Omar-Magdy0/ForgeDriveHW/Doc/ForgeX/G0/PSU_G0P20N_tref.pdf

# ForgeX

# PSU_G0P20N Technical Reference

Project: ForgeX
Generation: Gen0
Document: PSU_G0P20N Technical Reference Author: Omar Magdy
Revision: Rev. 0
Status: Development
Date: August 2026

FOrgeDrive

PSU_G0P20N Technical Reference | 1

# Table of Contents

Table of Contents

# 1. Introduction

The PSU (Power Supply Module) provides the localized low-voltage auxiliary power required by the ForgeX platform. It converts the system high-voltage DC link, nominally in the 340–400 VDC range, into regulated low-voltage supplies for downstream electronics and auxiliary circuitry.

The PSU provides the electrical boundary between the VDCH power domain and the low-voltage electronics domain. In addition to power conversion, the module incorporates the local functions required for controlled startup, protection, output regulation, and DC-link voltage monitoring.

The Gen0 implementation, PSU_G0P20N , establishes the initial electrical, mechanical, and interface definition for the ForgeX PSU family. Subsequent PSU generations may revise the power-conversion topology, switching devices, magnetics, control and regulation architecture, protection mechanisms, or thermal implementation while maintaining the defined ForgeX module interfaces where generational compatibility is required.

The Gen0 design is intentionally optimized for a relatively low-power auxiliary supply, with emphasis on simple magnetics, component availability, ease of debugging, and predictable behavior under the intended ForgeX operating conditions.

## 1.1 Naming

PSU_G0P20N follows the ForgeX module naming convention:

- PSU — Power Supply Module
- G0 — Generation 0
- P20 — 20 W nominal power class
- N — Non-isolated auxiliary/tie interface variant

The N suffix denotes that the module exposes the internal auxiliary supply and the power-side reference through a dedicated tie interface. This allows the module to be used in configurations where:

- the internal auxiliary supply is used on the PGND side;
- the PSU output-side ground is intentionally referenced to PGND ;
- the low-voltage outputs are used in a non-galvanically-isolated system configuration

The P20 designation identifies the intended power class of the module and should not be interpreted as an unconditional continuous-power rating. The achievable output power and current depend on operating conditions including:

- VDCH input voltage
- ambient and component temperature
- transformer and semiconductor losses
- PCB thermal characteristics
- enclosure and cooling conditions
- output-voltage loading

## 1.2 Functional Overview

The PSU accepts the ForgeX VDCH bus as its primary input and generates regulated low-voltage auxiliary supplies for downstream electronics.

The principal functions of the PSU are:

- Generate the primary 12 V auxiliary supply.
- Generate the 5 V auxiliary supply.
- Provide the required startup and power-conversion functions.
- Provide local protection against abnormal operating conditions.
- Provide output-side monitoring and regulation.
- Provide conditioned measurement of the VDCH bus voltage.
- Provide the required power and signal interfaces to downstream ForgeX modules.
- Maintain the required galvanic isolation between the VDCH /power domain and the low-voltage domain for configurations requiring an isolated output.
1. Introduction

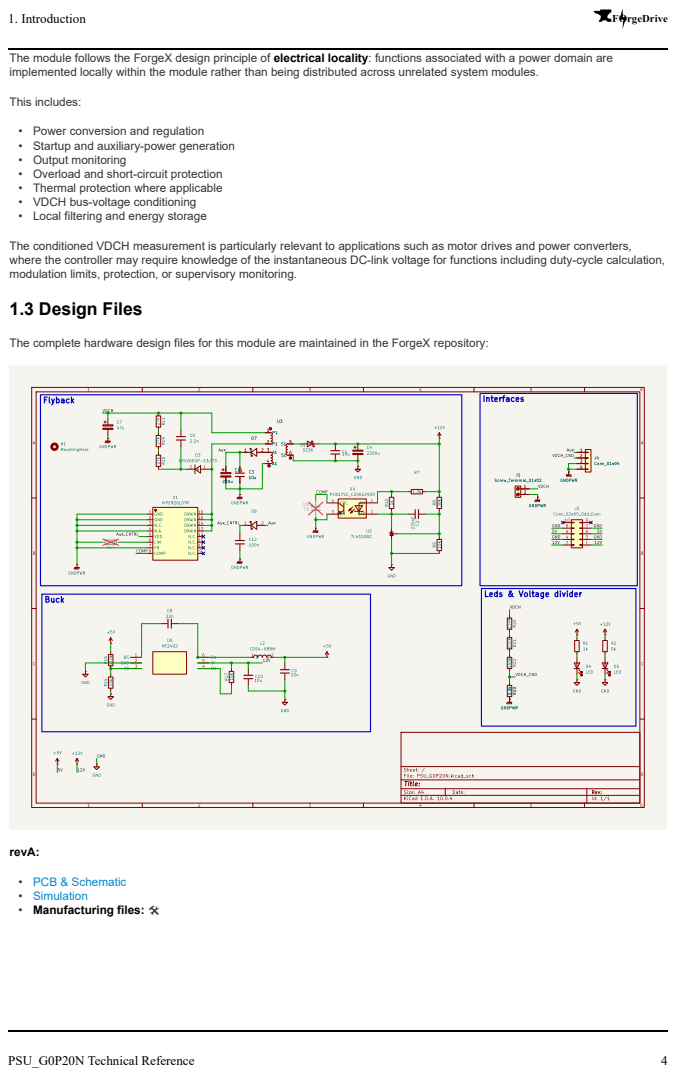
[picture p21: page 4]
This includes:; revA:; • PCB & Schematic • Simulation • Manufacturing files: 🛠; 1. Introduction

The module follows the ForgeX design principle of electrical locality: functions associated with a power domain are
implemented locally within the module rather than being distributed across unrelated system modules.

• Power conversion and regulation
• Startup and auxiliary-power generation
• Output monitoring
• Overload and short-circuit protection
• Thermal protection where applicable
• VDCH bus-voltage conditioning
• Local filtering and energy storage

The conditioned VDCH measurement is particularly relevant to applications such as motor drives and power converters,
where the controller may require knowledge of the instantaneous DC-link voltage for functions including duty-cycle calculation,
modulation limits, protection, or supervisory monitoring.
1.3 Design Files

The complete hardware design files for this module are maintained in the ForgeX repository:

# 2. Interfaces & I/O

1 | 2

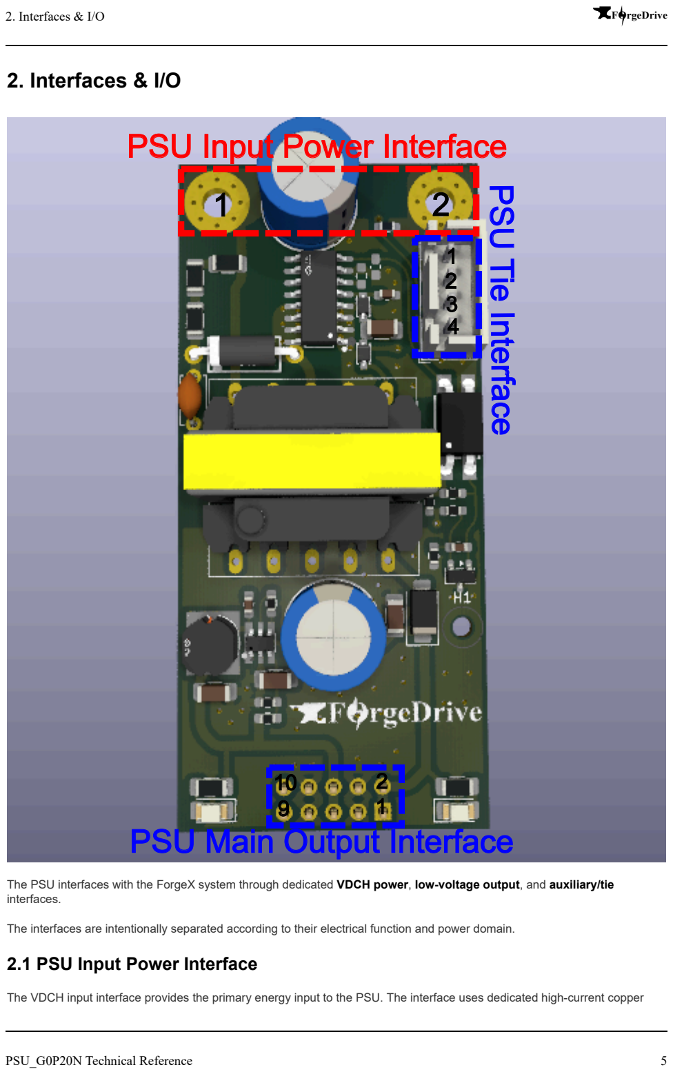
[picture p22: page 5]

1
9
10 | 2

1

4

2
3

# PSU Input Power Interface PSU Main Output InterfacePSU

# Tie Interface

The PSU interfaces with the ForgeX system through dedicated VDCH power, low-voltage output, and auxiliary/tie interfaces.

The interfaces are intentionally separated according to their electrical function and power domain.

## 2.1 PSU Input Power Interface

The VDCH input interface provides the primary energy input to the PSU. The interface uses dedicated high-current copper

2. Interfaces & I/O terminals suitable for connection to the ForgeX DC-link distribution structure.

The positive terminal is connected to the system VDCH positive rail, while PGND provides the corresponding DC-link return and power-domain reference.

Pin Number | Pin Name | Pin Description
1 | VDCH | Positive VDCH input. Connects to the positive DC-link rail.
2 | PGND | VDCH return and primary power-domain reference.

The input interface shall be treated as a hazardous-voltage interface when the PSU is connected to the ForgeX VDCH bus.

## 2.2 PSU Main Output Interface

The main output interface provides the regulated low-voltage supplies generated by the PSU.

The interface exposes both 12 V and 5 V rails together with their corresponding low-voltage ground reference, LGND .

The PSU Main Output interface uses a 2.54 mm-pitch header and is compatible with standard IDC and Dupont-style connectors. Multiple pins are paralleled for the power rails and return paths to reduce contact resistance and distribute current across multiple contacts.

A long-pin Dupont header may be used where access to the module's top-layer debug and test points is required.

Pin Number | Pin Name | Pin Description
1–2 | 12V | Regulated 12 V low-voltage output.
3–4 | LGND | Low-voltage output return/reference.
5–6 | 5V | Regulated 5 V low-voltage output.
7–8 | LGND | Low-voltage output return/reference.
9–10 | NC | No electrical connection.

LGND represents the low-voltage output reference and is electrically distinct from PGND in galvanically isolated configurations. In non-isolated configurations, LGND and PGND may be intentionally referenced together through the system-level grounding/ tie arrangement.

## 2.3 PSU Non-Isolated Tie Interface

The N variant provides a dedicated auxiliary/tie interface exposing selected internal nodes that are not available through the main output connector.

The Non-Isolated Tie interface uses JST-XH 2.5 mm-pitch connectors.

This interface permits the PSU to be integrated into systems where the low-voltage auxiliary supply or its reference must be associated with the primary power domain.

Pin Number | Pin Name | Pin Description
1 | Internal Aux 12V | Internal 12 V auxiliary output, limited to < 5W.
2 | VDCH_CND | Conditioned VDCH bus-voltage measurement output.
3 | PGND | Primary power-domain reference.
4 | PGND | Primary power-domain reference.

VDCH_CND is a conditioned analog representation of the VDCH DC-link voltage after the PSU's internal voltage-conditioning

2. Interfaces & I/O network. It is intended for connection to a suitable low-voltage ADC or monitoring circuit.

The PGND connection on this interface provides access to the primary power-domain reference and shall only be connected according to the intended system-level grounding architecture.

2. Interfaces & I/O

# 3. Design Requirements

The Gen0 PSU is designed around the following primary requirements:

- VDCH input: 340–400 VDC nominal operating range.
- Power class: 5–20W output operation.
- Nominal auxiliary rails: 12 V and 5 V.
- Efficiency: ≥ 85 under the intended nominal operating condition.
- Provide controlled startup from the VDCH bus.
- Provide appropriate overload and short-circuit protection.
- Provide regulated low-voltage outputs suitable for ForgeX downstream electronics.
- Provide conditioned VDCH-bus voltage measurement.
- Maintain the required electrical isolation or intentional non-isolated relationship according to the selected system configuration.
- Provide sufficient thermal margin for continuous operation within the intended power class.

The 20W designation represents the intended Gen0 design power class. Detailed continuous-load capability shall be evaluated against the thermal limits of the transformer, switching devices, rectification components, PCB copper, and other dissipative elements.

3. Design Requirements

# 4. Constraints

The Gen0 PSU design is subject to several practical constraints.

A significant constraint is the limited local supply chain, with component availability primarily governed by vendors accessible in Egypt. Component selection therefore considers availability and replacement options in addition to electrical performance.

PCB fabrication is constrained by the DFM rules applicable to the available fabrication process:

- Maximum number of layers: 2
- Minimum track width: 0.25 mm
- Minimum clearance: 0.25 mm
- Minimum polygon-pour clearance: 0.3 mm
- Minimum via diameter: 0.9 mm
- Minimum via hole diameter: 0.4 mm
- Minimum annular ring: 0.5 mm
- Maximum single-board size: 38 cm × 28 cm
- Maximum double-board size: 28 cm × 22 cm

The Gen0 implementation additionally prioritizes:

- Cost effectiveness
- Component availability
- Electrical and mechanical simplicity
- Reliability
- Predictable startup and protection behavior
- Ease of debugging and characterization
- Ease of modification during development
- Maintainability
- Simple and reproducible magnetics
- Compatibility with the broader ForgeX module architecture

Because the PSU interfaces directly with the VDCH bus, the Gen0 implementation also places particular emphasis on controlled voltage stress, switching-node behavior, insulation/isolation requirements where applicable, creepage and clearance, and safe probing during development and validation.

4. Constraints

# 5. Sizing and Component Selection

This section documents the principal component-selection and sizing decisions of the Gen0 PSU. Component values are selected from the electrical requirements established in the preceding sections, together with the operating characteristics of the selected switching topology and power devices.

Where analytical sizing is insufficient to capture parasitic effects or nonlinear device behavior, the initial component values are supplemented by simulation and experimental characterization.

## 5.1 Off-line Switcher

The VIPer26 off-line switcher from the STMicroelectronics VIPerPlus family was selected as the primary switching controller and integrated power device.

Datasheet: VIPer26LD (https://www.st.com/resource/en/datasheet/VIPER26.pdf)

Selection rationale:

- Local availability and cost: The device is readily available from local suppliers at relatively low unit cost, making it practical for prototyping, production, and replacement.
- Integrated high-voltage MOSFET: The integrated MOSFET provides an 800 V maximum drain-source voltage rating, providing substantial voltage margin relative to the intended VDCH operating range and associated switching transients.
- Application-appropriate conduction characteristics: The integrated MOSFET has an on-state resistance in the order of 7 Ω, which is suitable for the relatively low primary current associated with the 5–20W PSU power class.
- Low switching-node capacitance: The relatively low effective output capacitance of the integrated MOSFET reduces switching-node capacitive energy and associated switching losses.
- Integrated control and protection: The device integrates startup, PWM control, current limiting, burst-mode operation, and associated protection functions.
- Integrated current sensing: Primary current is sensed internally through the integrated SenseFET structure, eliminating the need for a conventional external primary-side current-sense resistor.
- Frequency jittering: The integrated switching-frequency jitter function reduces the concentration of switching energy at a single frequency and can reduce EMI peaks.
- Low standby consumption: Integrated low-power operating modes reduce consumption under light-load conditions.

The integrated switching, control, sensing, startup, and protection functions result in a compact implementation with substantially reduced external component count.

Although the application is not a conventional mains-powered offline supply, the input-voltage range and required operating conditions are within the intended application domain of the device. The VIPer26 therefore provides a suitable integrated switching solution for the ForgeX PSU.

The Gen0 implementation follows the isolated flyback application topology presented in the VIPer26 datasheet.

## 5.2 Flyback Transformer

The flyback transformer is the primary energy-storage, energy-transfer, and galvanic-isolation element of the PSU.

Unlike a conventional power transformer, the flyback transformer stores a substantial fraction of the transferred energy in its magnetizing inductance during the primary conduction interval and subsequently transfers this energy to the secondary during the demagnetization interval.

The design methodology follows the general procedure described in Designing a DCM flyback converter, (https://www.ti.com/lit/ta/ssztcw6/ssztcw6.pdf?ts=1787114658344&ref_url=https://www.google.com/)
with modifications to the order and priority of the design constraints to reflect the requirements of the ForgeX PSU.

The transformer design is constrained by:

- VDCH operating-voltage range
- Required output power
5. Sizing and Component Selection

- Selected switching frequency
- Maximum primary peak current
- Target operating mode
- Allowable flux density
- Required primary magnetizing inductance
- Selected turns ratio
- Allowable leakage inductance
- Winding current density
- Insulation and creepage requirements
- Thermal constraints

The transformer design establishes the primary magnetizing inductance, maximum stored energy per switching cycle, reflected secondary voltage, MOSFET voltage stress, secondary-device voltage stress, and the resulting flyback operating regime.

The initial electrical parameterization is performed before physical core
and winding selection. The resulting electrical requirements are then passed to the magnetic design stage, where the core, number of turns, air gap, winding geometry, leakage inductance, and thermal characteristics are determined.

The 150 V maximum reflected-voltage constraint is selected
from the available voltage margin of the VIPer26 integrated MOSFET.

At the maximum VDCH input voltage, the idealized MOSFET drain-source voltage is approximately:

Additional voltage stress is introduced by leakage-inductance-induced switching overshoot. For the initial design, a 100 V allowance
is reserved for this overshoot:

This provides an initial voltage margin below the 800 V MOSFET rating. The actual leakage-induced overshoot and resulting voltage margin are subsequently verified using the final transformer leakage inductance and RCD clamp design.

### Primary Inductance and Turns Ratio

The initial flyback electrical parameterization is performed by first
establishing the reflected-voltage constraint and turns ratio, followed by selection of the maximum operating duty cycle and corresponding primary peak current.

For DCM operation, the switching period consists of three distinct intervals:

VDS ≈ Vin,max + VR

## VDS,max ≈ 400 V + 150 V + 100 V = 650 V

fsw

VRmax

Ns

Np

VR

Ilim

## = 60 Khz (Switcher fixed switching frequency) = 150 V (Maximum tolerable secondary-to-primary reflected voltage)

= 8

## = (Vout + Vd) ×

Ns

## Np = 99.2 V

## = 0.7 A (Controller peak-current limit)

where:

The boundary between DCM and CCM occurs when the demagnetization interval exactly occupies the remainder of the switching period:

The maximum operating duty cycle is selected below this boundary to maintain DCM operation at the minimum VDCH input voltage:

Therefore:

With the maximum duty cycle selected as a design constraint, the required primary peak current is determined from the desired output power:

The required primary magnetizing inductance is then selected to store the required energy per switching cycle at the selected peak current:

The resulting peak current remains below the controller current limit:

The resulting Lm, Ipk, Dmax, and turns ratio are passed to
the subsequent magnetic design stage.

### Magnetics Design

The practical design of the flyback transformer follows the procedure
presented in Fairchild application note
AN-4140 — Transformer Design Consideration for Offline Flyback Converters Using Fairchild Power Switch FPS. (https://www.academia.edu/8900999/AN_4140_Transformer_Design_Consideration_for_Offline_Flyback_Converters_Using_Fairchild_Power_Switch_FPS)

The transformer is designed around the previously established electrical
requirements, including the primary magnetizing inductance, peak primary
current, switching frequency, turns ratio, reflected voltage, and required
DCM operating range.

Ts

Ts

Ts

D

=
fsw

1
= 16.67 μs

## = t1 + t2 + t3

> t1 + t2

=
Ts

t1

t1

t2

t3

: Primary switch ON; magnetizing current ramps up.
: Primary switch OFF; secondary conducts and transfers stored energy. : Both primary and secondary currents are zero.

Dcrit =
Vin,min + VR

VR =
340 + 99.2

99.2
≈ 0.226

## Dmax ≈ 0.2

## Dmax < Dcrit (DCM operation at Vin,min)

Pout

η

Ipk

= 20W
= 0.85

=
ηVin,minDmax

2Pout
≈ 0.692 A

Lm =
ηIpk

2 fsw

2Pout
≈ 1.6 mH

Ipk < Ilim

Core Selection

An 6H20 EE22 ferrite core from
FDK's ferrite core catalogue (https://www.es.co.th/Schemetic/PDF/FDK-FERRITE.PDF)
is selected as the initial magnetic core for the Gen0 transformer.

The selected core provides the required magnetic cross-sectional area and winding window for the intended 20W flyback application.

The transformer is operated with an intentional air gap to establish the required magnetizing inductance and to store the majority of the flyback energy in the magnetic circuit.

Primary and Secondary Turns

The required primary turns are initially determined from the required magnetizing inductance and the allowable peak flux density.

Equation 1 — Minimum Primary Turns

where Lm is the required primary magnetizing inductance,
Iover is the maximum primary current used for the magnetic design,

Bsat

is the selected saturation flux-density limit, and Ae is
the effective magnetic cross-sectional area of the core.

The resulting minimum primary-turn requirement is:

The secondary winding turns are determined from the required output voltage and the selected primary-to-secondary turns ratio.

Equation 2 — Secondary Winding Turns

For the Gen0 12 V output winding, the resulting winding is:

The auxiliary winding is similarly determined from the required auxiliary supply voltage.

Equation 3 — Auxiliary Winding Turns

with:

giving:

The resulting winding arrangement is therefore based on approximately 80 primary turns, 10 secondary turns, and 12 auxiliary turns.

NP

min =
BsatAe

LmIover × 10
6

## (turns)

NP

## min ≈ 80 (turns)

Ns1 =
8

Np

## Ns(n) = 10 (turns)

Na =
Vo1 + VF1

Vcc

∗ + VFa
⋅ Ns1

Vcc

∗ = 15 V

## Na = 12 (turns)

Air Gap

The required effective air gap is determined from the target magnetizing inductance and the magnetic core AL value.

Equation 4 — Air Gap Length

For the selected core and target magnetizing inductance, the calculated effective gap is approximately:

The final physical gap is established during magnetic construction and verified by measuring the resulting primary inductance. The magnetic inductance measurement is used as the final validation of the implemented air gap rather than relying solely on the calculated mechanical gap.

Winding Conductor Sizing

The winding conductors are sized according to the calculated RMS winding currents and the selected allowable copper current density.

For the primary winding, a current density of approximately

## 5 A/mm²

is used.

The primary RMS current is estimated from the peak current and maximum primary conduction duty:

For the secondary winding, a current density of approximately

## 6 A/mm²

is used.

The secondary conduction interval is determined from the primary conduction interval and the applied primary and reflected secondary voltages:

Using the selected operating point:

The corresponding secondary RMS current is estimated as:

The required copper cross-sectional areas are therefore:

G = 40πAe (
1000Lm

NP

2
−
AL

1
)

## G = 0.2 mm

Ipk,rms = Ipk
3

## Dmax ≈ 170 mA

t2 =
(Vout + Vd) Ns

Np

t1Vin

t2 =
(12 + 0.4) × 8

60k

0.2 × 340
= 11.42 μs

Isec,rms = Ipk Ns

Np
3

## t2fsw = 2.676 A

Cp =
5

0.17

## = 0.034 mm²

Cs =
6

2.676

## = 0.446 mm²

Ca =
6

0.4

## = 0.067 mm²

where Cp, Cs, and Ca represent the required copper cross-sectional areas of the primary, secondary, and auxiliary windings, respectively.

Parallel Conductor Selection

The primary and auxiliary windings are implemented using 0.15 mm-diameter enamelled copper conductors, while the secondary winding uses 0.3 mm-diameter enamelled copper conductors.

The copper cross-sectional area of an individual conductor is:

The required number of parallel conductors is therefore approximately:

The resulting winding conductor configuration is therefore approximately:

Winding | Required Copper Area | Conductor Diameter | Parallel Conductors
Primary | 0.034 mm² | 0.15 mm | 2
Secondary | 0.446 mm² | 0.30 mm | 6
Auxiliary | 0.067 mm² | 0.15 mm | 4

The conductor selection is based on RMS-current density and represents the
initial copper-sizing calculation. Final winding selection additionally
depends on the available winding window, insulation system, winding construction, temperature rise, proximity effects, and manufacturability.

The implemented transformer is subsequently verified by measurement of the primary magnetizing inductance, winding resistance, leakage inductance, and winding-to-winding isolation.

Winding Area

The winding-window calculation accounts for the bounding-square footprint of the round conductors rather than using copper cross-sectional area alone. This provides a conservative estimate of the physical winding area required by each parallel conductor.

C0.15 = 0.15

2 ×
4

π

## = 0.0177 mm²

C0.3 = 0.3

2 ×
4

π

## = 0.071 mm²

kp =
C0.15

Cp ≈ 2

ks =
C0.3

Cs ≈ 6

ka =
C0.15

Ca ≈ 4

Astrand,ext = dext

## 2 = (1.1 ⋅ dbare)

2

Awire,total =

k∈{p,s,a}

∑ Nk ⋅ mk ⋅ Astrand,ext,k

Variable Definitions

- dbare: Bare copper conductor diameter (mm)
- dext

: Insulated outer conductor diameter (≈ 1.1 ⋅ dbare)

- Astrand,ext

: Bounding square cross-sectional footprint per strand (dext

2
)
- Nk: Turn count for winding k ∈ {p, s, a}
- mk: Number of parallel strands per turn
- Kpack: Winding packing factor (≈ 0.55 − 0.7)
- Wa: Usable bobbin window area (≈ 29.5 mm²
for EE22)

The resulting winding-window occupancy factor is within the available winding-window area of the EE22/19 core, confirming that the selected core provides sufficient space for the required winding configuration.

Winding Resistance

Based on core dimensions and expected bobbin dimensions, the mean diameter of windings is expected to be of 10.5 mm, this gives us a Mean Length / Turn (MLT) of:

Using the copper resistivity at an elevated operating temperature of approximately 75

## ∘C (ρcu ≈ 2.09 × 10

−8 Ω ⋅ m), the DC
winding resistances are calculated as:

Winding Power Loss
Winding Power LossThe conduction power loss for each winding is determined using the respective RMS currents:

The total copper conduction loss across all transformer windings is:

Awire,total = Npmpdext,p

2 | + Nsmsdext,s
2 | + Namadext,a

2
= (88 × 2 × 0.175

2
) + (10 × 6 × 0.335

2
) + (12 × 4 × 0.175

2
)

## = 5.39 mm² + 6.73 mm² + 1.47 mm²

## = 13.59 mm²

Awinding,total =
Kpack

Awire,total =
0.55

## 13.59 mm²

## ≈ 24.71 mm²

Ku

## Occupation

= Wa

Acu,total =

## 29.5 mm²

## 8.00 mm²

≈ 27.1%

## = Wa Awinding,total = 29.5 mm²

## 24.71 mm²

≈ 83.8%

## (Pure Copper Fill Ratio)

## (Bobbin Window Build-Up)

## MLT = π × Dmean = π × 10.5 mm ≈ 33 mm = 0.033 m

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
k × Cstrand

## ρ × N × MLT

=
2 × 0.0177 × 10

−6

2.09 × 10

−8 × 88 × 0.033
≈ 1.716 Ω

=
6 × 0.071 × 10

−6

2.09 × 10

−8 × 10 × 0.033

## ≈ 0.0162 Ω (16.2 mΩ)

=
4 × 0.0177 × 10

−6

2.09 × 10

−8 × 12 × 0.033

## ≈ 0.117 Ω (117 mΩ)

Pcu,p = Ip,rms

## 2 × Rp = (0.17 A)

2 × 1.716 Ω ≈ 0.05W

Pcu,s = Is,rms

## 2 × Rs = (2.68 A) 2 × 0.0162 Ω ≈ 0.116W

Pcu,a = Ia,rms

## 2 × Ra = (0.35 A) 2 × 0.117 Ω ≈ 0.014W

Winding Configuration

Sandwiching the secondary between two primary halves significantly lowers leakage inductance and suppresses switching voltage spikes across the MOSFET. This minimizes snubber power dissipation and improves overall power supply efficiency.

Layer | Winding
| Component | Turn Count (
N)
| | | Conductor
| | | Configuration | Insulation / Interlayer Barrier
0 | Bobbin Barrel | — | — | Core insulation base
1 | Primary Half 1 (P1) | 44 | 2× 0.15 mm | 2× layers Kapton or Mylar tape
2 | Main Secondary (S) | 10 | 6× 0.30 mm | 2× layers Kapton or Mylar tape
3 | Primary Half 2 (P2) | 44 | 2× 0.15 mm | 2× layers Kapton or Mylar tape
4 | Auxiliary Supply (A) | 12 | 4× 0.15 mm | Outer protective Kapton/Mylar
| | | | wrap

## 5.3 RCD Clamp

An RCD clamp is used to limit the primary switching-device voltage excursion caused by transformer leakage inductance.

When the primary switch turns off, the magnetizing current is interrupted while current associated with the transformer leakage inductance cannot change instantaneously. The resulting leakage energy produces a voltage excursion at the primary switching node.

The RCD network provides a controlled path for this leakage energy, converting the stored leakage energy primarily into heat in the clamp resistor while limiting the resulting VDCH -referenced voltage stress on the integrated MOSFET.

The initial RCD clamp values are obtained using empirical flyback-snubber design relationships and are subsequently verified using circuit simulation and experimental measurements.

The design primarily considers:

- maximum VDCH ;
- maximum primary peak current;
- transformer leakage inductance;
- switching frequency;
- reflected secondary voltage;
- desired clamp voltage;
- allowable MOSFET voltage stress;
- clamp-capacitor voltage ripple;
- clamp-resistor dissipation; and
- PCB and transformer parasitic inductance.

The initial sizing follows the methodology described in Application Note AN-4147. (https://e2e.ti.com/cfs-file/__key/communityserver-discussions-components-files/188/Design-Guidelines-for-RCD-Snubber-of-Flyback-Converters_2D00_Fairchild-AN41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)

For the initial design, transformer leakage inductance is assumed to be approximately 1% of the primary magnetizing inductance:

This value is used as an initial design assumption. The actual leakage inductance is determined by the final transformer construction and subsequently verified experimentally.

The preliminary clamp design uses:

## Pcu,total = Pcu,p + Pcu,s + Pcu,a = 0.05W + 0.116W + 0.014W ≈ 0.18W

## Llk = 0.01Lm = 0.01 × 1.6 mH ≈ 16 μH

The reflected secondary voltage established by the transformer design is:

For the initial RCD design, the clamp voltage is selected according to the empirical relationship:

The energy stored in the transformer leakage inductance at primary switch turn-off is:

The corresponding average snubber dissipation is estimated using the empirical RCD relationship:

The corresponding clamp resistance is:

For an initial clamp-capacitor value of:

the estimated clamp-voltage ripple is:

The resulting component values are used as the initial simulation values. The final RCD network is subsequently tuned against the simulated and measured primary switching waveform.

Particular attention is given to:

- MOSFET maximum VDS
- leakage-induced voltage overshoot
- clamp-voltage ripple
- snubber power dissipation
- switching-node ringing
- transformer leakage-inductance variation
- PCB parasitic inductance

The final clamp voltage is selected with sufficient margin below the 800 V MOSFET rating while avoiding unnecessary snubber dissipation.

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
= 1.6 mH
= 16 μH
= 12 V
= 0.4 V

≈ 8
= 0.692 A

## = 60 kHz

## VR = (Vo + Vd)

Ns

## Np ≈ 99.2 V

## Vsn = 2 × nVo = 198.4 V

Elk =
2

1
LlkIpk

2

Psn =
2

1
LlkIpk

2
Vsn − VR

Vsn

## fs ≈ 0.47W

Rsn =
Psn

Vsn

2
≈ 84 kΩ

## Csn = 2.2 nF

## ΔVsn =

RsnfsCsn

## Vsn ≈ 17.9 V

## 5.4 Output Capacitor, and Output Diode

The input capacitor provides the local energy reservoir for the primary-side converter and limits the high-frequency current drawn from the VDCH distribution network.

The output capacitor stores the energy delivered by the secondary winding and supplies the load during the interval in which the secondary rectifier is not conducting.

The output rectifier is selected according to:

- maximum reverse voltage
- peak forward current
- average forward current
- reverse-recovery characteristics
- forward-voltage drop
- switching frequency
- thermal dissipation

The capacitor and rectifier sizing considers both steady-state electrical requirements and transient operating conditions.

The principal sizing relationships are given below.

Output Diode

Output Capacitor

The output ripple contribution due to ESR is:

For example, with Ipk = 0.66 A, Np/Ns = 8, and Resr = 30 mΩ:

Therefore, for a 0.3 Vpp ripple target, Cout,min = 161 μF.

Consequently, the calculated Cout,min is the minimum capacitance required to meet the specified ripple-voltage target. A larger capacitance may be selected in practice to reduce the effective ESR and improve ripple-current capability, while providing additional margin for capacitor tolerance and temperature-dependent derating.

Iout

PDiode

IDiode,pk

=
Vout

Pout =
12

20
= 1.67 A

## = Vd × Iout = 0.668W; Vd ≈ 0.4 V (Schottky)

## = Ipk ×

Ns

## Np = 0.66 × 8 = 5.28 A

Cout,min

ICout,rms

t2

=
(ΔVout − Ipk Ns

NpResr)fsw

Iout,max(1 − Dmin)

= Isec,rms

2 | − Iout

2 =
3

Ipk

2 ( Ns

Np )

2
t2fsw
− Iout,max

2

= 2 A

=
( Ns

Np ) (Vout + VD)

## LmIpk = 11.976 μs

ΔVout,ESR = Ipk ×
Ns

Np × Resr

ΔVout,ESR =0.158 Vpp

For the RevA implementation, an output capacitor of Cout = 2200 μF, Iripple,rms = 2 A, and ESR ≈ 35 mΩ was selected.

## 5.5 Feedback and Compensation

The feedback network establishes output-voltage regulation and determines the small-signal response of the converter.

The control-loop design considers:

- flyback power-stage dynamics;
- the selected operating mode;
- output-capacitor characteristics;
- feedback-network dynamics; and
- the required loop bandwidth and stability margins.

The small-signal model used for the Gen0 PSU is based on the analytical DCM current-mode flyback model presented in the Richtek application note AN017 — Feedback Control Design of Off-line Flyback Converter. (https://www.richtek.com/Design%20Support/Technical%20Document/AN017)

The published analytical procedure is adapted to the electrical parameters and control characteristics of the PSU_G0P20N . The resulting model is subsequently used to determine the required compensation network and to verify loop stability across the expected operating range.

The following notation is used:

The primary-side current-sense slope is represented by:

where Sn represents the voltage slope generated across the current-sense element by the primary current ramp.

For the VIPer26 implementation, the effective current-sense conversion is approximately 3 V/A according to the device documentation.
Therefore, for the present implementation the corresponding expression can be represented as:

where the resulting units are V/s.

Se represents externally applied slope compensation:

For the present VIPer26 implementation, external slope compensation is not

D

R

fs

n

M

τL

## : Duty cycle : Equivalent load resistance : Switching frequency

=
Ns

Np

## : Transformer turns ratio

=
Vin

nVo

## : Voltage transfer ratio

=
n²R

2Lpfs

## : Flyback power-stage time constant

Sn =
Lp

Vin Rs

Sn =
Lp

Vin
× 3

## Se : Externally added current-sense voltage slope

used, therefore:

The small-signal feedback gain is represented by:

where^vRS represents the small-signal current-sense voltage and ^vFB represents the corresponding feedback signal.

### Current-Mode DCM Flyback Small-Signal Model

Following the analytical model presented in the Richtek application note, the current-mode DCM flyback control-to-output transfer function is represented by:

where:

The two power-stage poles are:

The two zeros are:

The equations above are used as an analytical approximation of the converter power-stage response rather than as a first-principles derivation of the switching converter dynamics.

1P2Z Simplification

For the intended DCM operating range, the second power-stage pole ωp2 is located well above the target control-loop crossover frequency.

It can therefore be neglected for the purpose of compensator design, reducing the power-stage model to an equivalent one-pole, two-zero 1P2Z transfer function:

Se = 0

GFB =
^vFB

^vRS

^vcomp(s)

## ^vo(s)

= G0 ⋅
(1 + ωp1

s ) (1 + ωp2

s )

(1 + ωz1

s ) (1 − ωz2

s )

G0 = Vin ⋅ GFB ⋅
2Lp

fsR
⋅

## (Sn + Se)

1

ωp1 =
RCo

2

## ωp2 = 2fs ⋅ (

(1 + M

1
)

D

1
)

2

ωz1 =
RcCo

1

## (ESR zero, LHP)

## ωz2 = M(1 + M)Lp

n

2R

## (RHP zero)

## GPS(s) ≈ G0 ⋅

(1 + ωp1

s )

(1 + ωz1

s ) (1 − ωz2

s )

This simplification substantially reduces the complexity of the
compensation design while retaining the dominant dynamics relevant to the selected crossover frequency.

Design Operating Point

The feedback network is initially designed around the low-line, heavy-load operating condition.

This operating point represents a demanding condition for the control loop and is therefore used as the primary compensation-design condition. Adequate phase margin and gain margin at this operating point provide additional stability margin as the operating conditions move away from the nominal design point.

### Compensator

The secondary-side feedback network uses the conventional TL431 and optocoupler feedback arrangement.

The compensator is designed according to the procedure presented in the Richtek AN017 application note, with the component values adapted to the output-voltage, output-capacitance, load, and power-stage parameters of the Gen0 PSU.

The compensation design establishes:

- target loop crossover frequency
- compensator pole and zero locations
- low-frequency loop gain
- phase margin
- gain margin
- required feedback-network component values

Compensator Design Procedure

The Type-II voltage-loop compensator is designed at low line Vin,min and maximum output power Pout,max to ensure stability across the worst-case power-stage operating point.

- Target Loop Dynamics: Formulated to approximate Gloop(s) ∝ s

1
near crossover, yielding a −20 dB/dec slope and a
≈ 90

∘
phase margin.
- Crossover Frequency fc: Selected well below the 60 kHz switching frequency (fc ≈ 800 Hz − 3 kHz) to decouple control dynamics from switching noise and RHP zero effects.
- Pole/Zero Placement:
- Low-Frequency Zero ωcz1: Cancels the dominant power-stage pole (ωp1) to restore phase margin.
- High-Frequency Pole (ωcp1): Cancels the output capacitor ESR zero (ωz1) and suppresses high-frequency switching noise.
- Robustness & Verification: Nominal component values are calculated analytically and swept across input voltage extremes ( VDCH ), load range, output capacitor ESR/tolerance, and feedback tolerances. Stability is verified via loop simulation and frequency response measurements.

Compensator Implementation

Gcomp(s) = A ⋅
s(1+ ωcp1
s

)

(1+ ωcz1
s

)

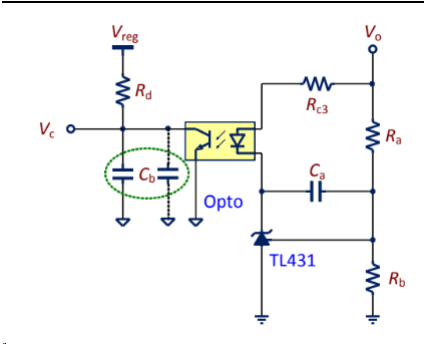
[picture p23: figure]

Compensator Implementation

The practical implementation of the feedback compensator follows the procedure presented in Section "Implementation of Compensator" of the Richtek AN017 (https://www.richtek.com/Design%20Support/Technical%20Document/AN017)
application note, specifically the sequence of design steps given in
Points 1–9.

The procedure is adapted to the TL431/PC817 feedback network used in the Gen0 PSU and to the electrical characteristics of the VIPer26 controller.

Given / Design Parameters:

where Rd is the internal VIPer26 feedback-related resistance specified by the device datasheet.

where Vref is the internal reference voltage of the TL431.

PC817 Parameters:

The optocoupler parameters are taken from the
Sharp PC817 datasheet. (https://www.alldatasheet.com/datasheet-pdf/view/43371/SHARP/PC817.html)

Gcomp(s)

A

ωcz1

ωcp1

=

## ^vc(s)

## ^vo(s)

= CTR ⋅
Rc3

Rd
⋅
sCaRa

1
⋅

## (1 + sCbRd)

## (1 + sCaRa)

= CTR ⋅
Rc3

Rd
⋅
CaRa

1

=
CaRa

1

=
CbRd

1

## Rd = 15 kΩ

## Vo = 12 V

## Vref = 2.5 V

## CTR = 0.5

The optocoupler phototransistor parasitic capacitance is approximated as:

based on the capacitance indicated by the PC817 frequency-response characteristics.

The above parameters are used as the initial values for the compensator component calculations described in the following steps.

AN017 Compensator Design Procedure:

1. Determine the required feedback-divider resistance from the TL431 reference voltage and the required output voltage.
2. Determine the required optocoupler operating current and corresponding LED current using the selected PC817 CTR.
3. Determine the required low-frequency loop gain and target crossover frequency from the previously established power-stage model.
4. Determine the required compensator zero location to provide phase compensation for the dominant power-stage pole.
5. Determine the high-frequency compensator pole location.
6. Calculate the required compensator resistance and capacitance values.
7. Verify the resulting compensator gain and phase characteristics together with the flyback power-stage transfer function.
8. Verify the resulting loop crossover frequency, phase margin, and gain margin.
9. Verify the complete compensation network across the expected input-voltage and load operating range using circuit simulation.

The calculated component values and the resulting loop characteristics are given below.

## 5.6 Primary Switch Loss Estimation

The primary switch losses are initially estimated at the principal operating-voltage extremes.

At Vin = 340 V: Maximum-duty operating point

For the triangular primary current waveform associated with DCM operation, the RMS primary current during the switching period is:

Copto = 5 nF

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
## = 800 Hz (crossover frequency)

=
Ivd

Vref =
250 μA

2.5
= 10 kΩ

=
Ivd

## Vo − Vref = 38 kΩ

= 230 nF

## = 5.133 ≈ 5 nF ≈ Copto

= 1.2 kΩ

<
Icathode

Vo − Vf − Vref

< 5.66 kΩ

Ipk,rms

Ipk,rms

= Ipk
3

Dmax

≈ 170 mA

The corresponding MOSFET conduction loss is estimated using the integrated MOSFET on-resistance:

The nonlinear MOSFET output capacitance is represented using a fitted Coss(V ) characteristic derived from the device datasheet:

For a nonlinear output capacitance, the stored capacitive energy is determined from the charge-voltage characteristic:

The corresponding first-order capacitive switching-loss estimate is:

The switching-loss contribution associated with the active turn-on and turn-off transitions is initially approximated as being comparable to the MOSFET conduction loss. This assumption is used only for the preliminary thermal estimate and is subsequently refined using switching-waveform simulation.

Therefore:

At Vin = 400 V: Minimum-duty operating point

The primary ON-time becomes:

Using the same preliminary switching-loss assumption:

The preceding loss calculations represent preliminary first-order estimates. Final MOSFET loss is verified against the simulated switching waveform, including the effects of drain-voltage overshoot, leakage inductance, switching transition time, and the RCD clamp.

## 5.7 Voltage Sensing

The PSU_G0P20N exposes VDCH non isolated voltage measurement conditioned for 3.3 ADC measurement with respect to PGND , through the Tie interface.

The divider ratio is selected such that the maximum expected switch-node voltage is mapped into the valid 0--3.3 V range of the analog sensing circuitry:

PFET,cond

PFET,cond

PFET,cond

= Ipk,rms

2 | × RDS(on)
= 0.17

2 × 7 Ω
≈ 0.2W

## QFet(V ) = 580 pC × V

0.443

Eoss(V ) = ∫

0

V
V

′
dQoss(V

′
) = 178 p × V

1.443 J

PFET,Coss = fsw × Eoss(Vin) = 48 mW

PFET,total

PFET,total

≈ PFET,Coss + PFET,cond + PFET,switching
≈ 0.45W

D

Ip,rms

PFET,cond

PFET,Coss

=
ηVinIpk

2Po ≈ 0.178

≈ 160 mA
= 0.16

2 × 7 Ω ≈ 0.18W
≈ 60 mW

PFET,total ≈ 0.42W

This gives the following nominal full-scale mapping:

The resulting scaling makes effective use of the available ADC input range while retaining a small margin below the 3.3 V rail. The divider is implemented as a series string of high-voltage resistors so that the voltage stress across each individual component remains within its rated working voltage. The physical implementation also maintains the required creepage and clearance distances across the high-voltage portion of the divider.

The power dissipated by the divider under a 400 V DC switch-node condition is approximately:

This dissipation is distributed across the series resistor string rather than concentrated in a single component, reducing the voltage and power stress on each individual resistor.

## 5.8 12V to 5V Buck Converter

The 5 V auxiliary rail is generated from the regulated
12 V PSU output using an on-board synchronous buck converter.

The selected device is the MT2492, providing a compact and integrated solution suitable for the relatively low-power 5 V auxiliary
rail.

Datasheet: MT2492 (https://www.lcsc.com/datasheet/C89358.pdf)

The converter is intended for an output power of up to approximately 10W, subject to the thermal and electrical operating
conditions of the implementation.

Selection rationale:

- Compact implementation: The integrated synchronous switching architecture reduces the required external component count and PCB area.
- High switching frequency: The 600 kHz switching
frequency permits relatively small inductance and capacitance values, reducing the overall converter footprint.
- Integrated synchronous rectification: The integrated high-side and low-side switching devices eliminate the need for an external freewheeling diode and improve conversion efficiency at the intended output current.
- Simple external power stage: The selected operating point can be implemented using a small number of external passive components.

The component values are initially selected according to the manufacturer's application and component-selection guidelines.

Initial power-stage component selection:

Component | Selected Value | Function
Input capacitor | 10 μF MLCC | Local input energy storage and switching-current decoupling
Output capacitor | 22 μF MLCC | Output filtering and reduction of switching ripple
Inductor | CD54-6R8 | 6.8 μH buck-converter energy-storage inductor

Vsignal = Vsw ×
450 k + 3.3 k

3.3 k

450 V → 3.276 V

Pdivider =
450 k + 3.3 k

400

2
≈ 0.353W

The input capacitor is placed locally to the converter switching stage to minimize the high-frequency input-current loop area.

The output capacitor and inductor form the primary LC filtering network, with the selected values providing the required output-current ripple and transient-response characteristics for the 5 V auxiliary
rail.

The selected components and resulting operating waveforms are subsequently verified against the converter datasheet limits and the expected PSU operating conditions.

# 6. Simulation

Simulation is used as a first-pass validation and design tool for the PSU.

The simulations are intended to:

- Validate initial electrical estimates
- Evaluate the effects of layout-related parasitics
- Assist with component sizing
- Investigate switching behavior and transient effects
- Provide a basis for first-pass design tuning

Simulation results are not considered a substitute for physical testing and validation. Their accuracy depends on the quality, fidelity, and
applicability of the underlying semiconductor, parasitic, and system
models.

The primary simulation focus is the power-electronics behavior of the module and its associated switching infrastructure.

The simulation test circuits used for verification are provided under simulation/ .

## Switching Model

Simulation file: PSU_G0P20N.asc

The switching-level model reproduces the principal control and power-stage behavior of the Gen0 PSU, including:

- primary-side current-mode control
- programmed current limiting
- the approximately 8.5 ms current-limited startup ramp
- feedback and compensator behavior
- flyback transformer magnetizing and leakage inductance effects
- RCD clamp operation
- output-voltage regulation under dynamic loading

The simulation includes two programmed load transitions to evaluate the transient response of the converter.

The load profile is:

For a regulated 12 V output, these correspond approximately to 6W, 12W, and 20W load conditions,
respectively.

The simulation is performed at both 340 V and
400 V input voltage to evaluate the converter response at the nominal operating range endpoints.

### Simulation Results and Summary

## - At Vin = 340 V

Rload = 24 Ω | for | 0 ms ≤ t < 35 ms
Rload = 12 Ω | for | 35 ms ≤ t < 50 ms
Rload = 7.2 Ω | for | 50 ms ≤ t < 70 ms
6. Simulation

1

1.5

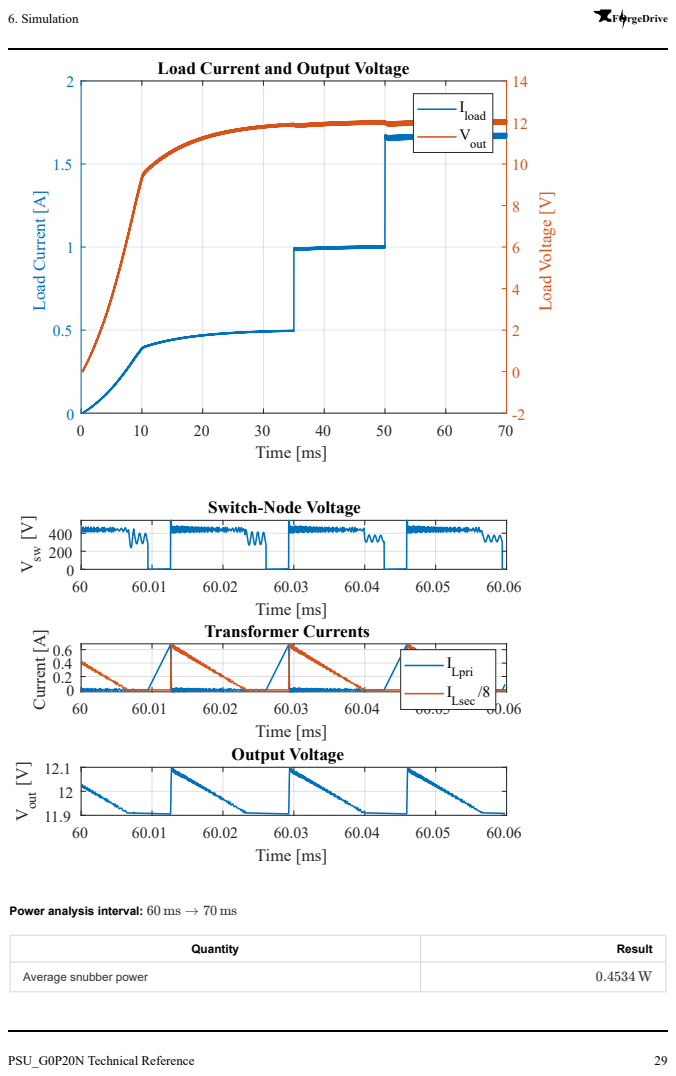
[picture p24: page 29]
Time [ms]; Load Current [A]; Load; Voltage [V]; I load V out; Current [A]; Transformer Currents; Lsec /8; Vout [V]; Output Voltage; Quantity; Result; Average snubber power; 6. Simulation

Load Current and Output Voltage

Switch-Node Voltage

Lpri

Power analysis interval: 60 ms → 70 ms

## - At Vin = 400 V

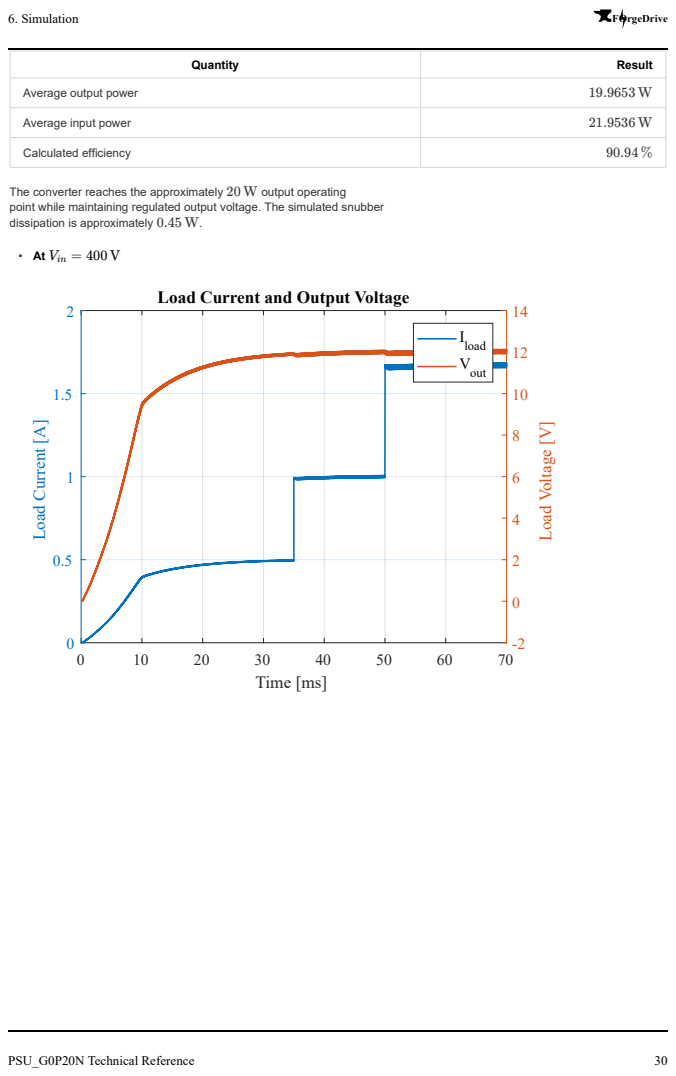
[picture p25: page 30]
Quantity; Result; Average output power; Average input power; Calculated efficiency; Time [ms]; Load Current [A]; Load; Voltage [V]; I load V out; 6. Simulation

The converter reaches the approximately 20W output operating
point while maintaining regulated output voltage. The simulated snubber
dissipation is approximately 0.45W.

Load Current and Output Voltage

60 | 60.01 | 60.02 | 60.03 | 60.04 | 60.05 | 60.06
| | | Time [ms]

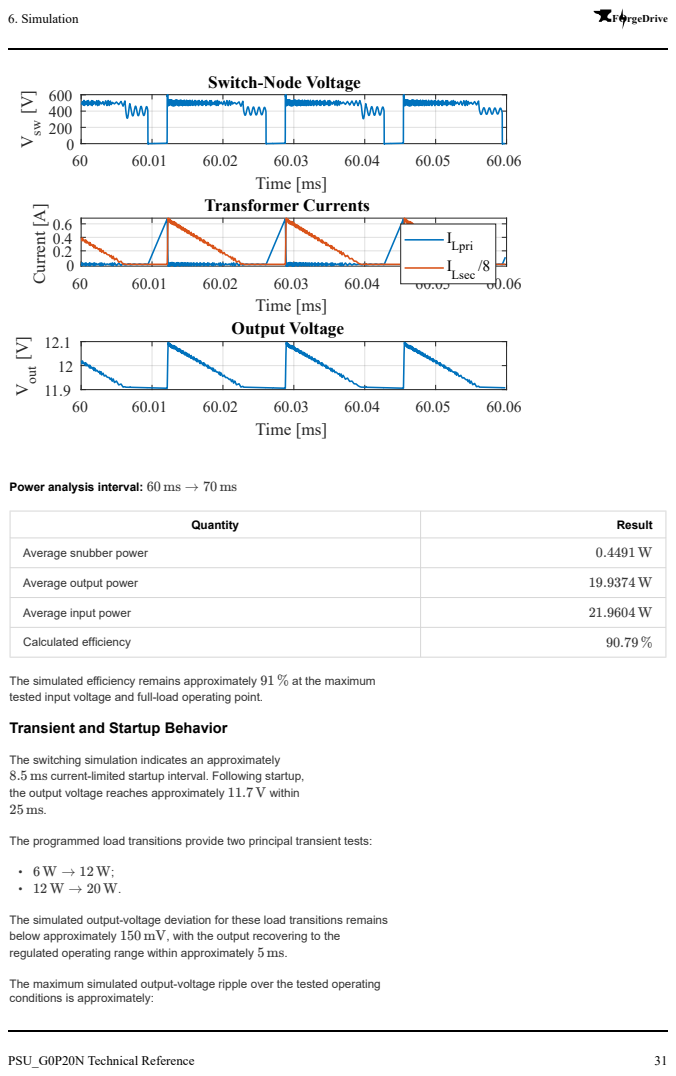
[picture p26: page 31]
Time [ms]; Current [A]; Transformer Currents; Lsec /8; Vout [V]; Output Voltage; Quantity; Result; Average snubber power; Average output power; Average input power; Calculated efficiency; 6. Simulation

Switch-Node Voltage

Lpri

Power analysis interval: 60 ms → 70 ms

The simulated efficiency remains approximately 91 % at the maximum
tested input voltage and full-load operating point.
Transient and Startup Behavior

The switching simulation indicates an approximately
8.5 ms current-limited startup interval. Following startup,
the output voltage reaches approximately 11.7 V within

The programmed load transitions provide two principal transient tests:

The simulated output-voltage deviation for these load transitions remains
below approximately 150 mV, with the output recovering to the
regulated operating range within approximately 5 ms.

The maximum simulated output-voltage ripple over the tested operating
conditions is approximately:

At the maximum tested input voltage, the simulated peak drain-source voltage of the integrated switching MOSFET reaches approximately:

The RCD clamp dissipates approximately 0.45W under the full-load operating condition.

Across the two tested input-voltage conditions, the simulated full-load efficiency is:

giving an approximately 90.9 % efficiency level over the tested operating points.

### Simulation Conclusions

The switching-level simulation demonstrates that the Gen0 PSU reaches the specified 20W operating point at both tested VDCH input
voltages while maintaining closed-loop output regulation.

The simulation additionally verifies, within the scope of the implemented model:

- current-limited startup behavior
- closed-loop regulation during load transitions
- approximately 0.2 V maximum simulated output ripple
- approximately 0.45W RCD-clamp dissipation at full load
- approximately 90.9 % full-load conversion efficiency
- a maximum simulated MOSFET drain-source voltage of approximately
600 V at Vin = 400 V.

## ΔVpp ≈0.2 V

VDS,peak ≈ 600 V

η340V = 90.94 %

η400V = 90.79 %

6. Simulation

# 7. Layout Considerations & Highlights

1
2

3
4

The PCB layout was developed with particular attention to high-voltage creepage and clearance, galvanic isolation, thermal management, and minimization of high-di/dt current-loop areas.

## 7.1 High-Voltage Clearance and Isolation

The primary-side VDCH domain is physically separated from the low-voltage secondary domain.

Particular attention was given to the spacing between high-voltage nodes and the primary-side ground. The minimum identified creepage distance between the VIPer26 drain node and the corresponding ground region is approximately
2.5 mm.

The primary-to-secondary isolation barrier provides approximately
6 mm of physical separation. This distance is primarily governed
by the mechanical dimensions and pin geometry of the feedback optocoupler.

The RCD clamp network and VDCH voltage-sensing divider are implemented using 1206-package resistors. Their placement and spacing account for the voltage rating and creepage requirements of the resistor packages and associated PCB conductors.

7. Layout Considerations & Highlights

High-voltage switching nodes are kept physically separated from sensitive low-voltage circuitry wherever practical.

## 7.2 Primary Switch Thermal Management

The VIPer26 drain connection is implemented using an approximately

## 100 mm²

copper area. This copper region provides both the electrical drain connection and a PCB-based heat-spreading path for the integrated switching device.

The increased copper area reduces the effective thermal impedance between the device package and the PCB and is intended to provide an effective junction-to-ambient thermal resistance of approximately

for the implemented package and PCB configuration.

The resulting junction temperature is determined from the device power dissipation together with the expected ambient temperature and effective thermal resistance.

## 7.3 High-di/dt Current Loops

Particular attention was given to minimizing the physical area enclosed by the principal high-di/dt current loops.

Reducing these loop areas reduces parasitic inductance and consequently limits switching-node voltage overshoot, ringing, electromagnetic coupling, and high-frequency conducted noise.

The principal high-di/dt loops identified during the layout design are shown in the preceding figure.

### 1. Secondary Rectifier and Output-Capacitor Loop

The principal secondary-side commutation loop consists of:
Transformer secondary → Output diode → Output capacitor → Transformer secondary return

### 2. Synchronous Buck Input Loop

The principal high-frequency input loop of the 12V-to-5V
buck converter consists approximately of:
CIN + → Switching stage / VCC → GND → CIN −
The CIN decoupling capacitor is positioned close to the converter power-stage connections to minimize the input switching-current loop inductance.

### 3. Primary Flyback Switching Loop

The primary flyback switching loop consists of:
CIN + → Transformer primary → switcher drain → switcher source / PGND → CIN −

This loop carries the primary switching current and is therefore kept as
compact as practical.
The input capacitor, transformer primary winding, and Switcher device
are positioned to minimize the enclosed loop area and associated parasitic inductance.

### 4. RCD Clamp Loop

The RCD clamp provides the high-frequency current path for the energy associated with the transformer leakage inductance during primary switch turn-off.

The RCD components are placed close to the transformer primary and the Switcher drain connection to minimize the physical area enclosed by the clamp

## RθJA ≈ 90 ∘C/W

7. Layout Considerations & Highlights

current path.

Minimizing this loop reduces its parasitic inductance and limits additional high-frequency voltage overshoot and ringing at the primary switching node.

7. Layout Considerations & Highlights

# 8. Field Tests and Validation 🛠

[Document laboratory testing, measurements, test conditions, and comparison against simulation.]

8. Field Tests and Validation 🛠

# 9. Known Issues and Limitations 🛠

[Document known limitations of Rev. A / Gen0.]

9. Known Issues and Limitations 🛠

# 10. Revisions

Revision | Date | Description
Rev. 0 | August 2026 | Initial technical reference
10. Revisions
