Omar-Magdy0/ForgeDriveHW/Doc/ForgeX/G0/Images_G0A/a4.png

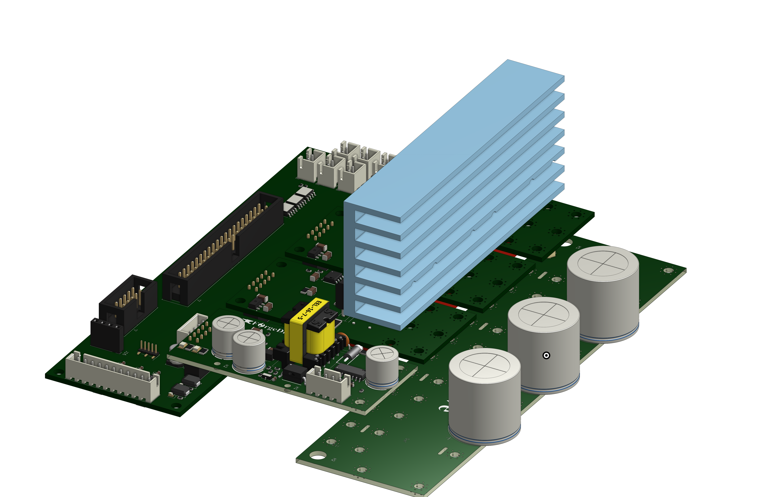
Doc/ForgeX/G0/Images_G0A/a4.png
