Omar-Magdy0/ForgeDriveHW/Doc/ForgeX/G0/Images_G0A/ab2.png

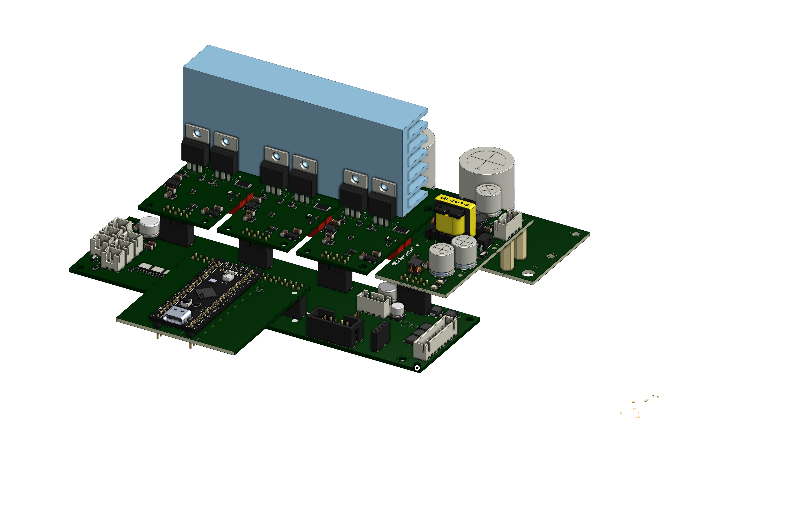
Doc/ForgeX/G0/Images_G0A/ab2.png
