Omar-Magdy0/ForgeDriveHW/Doc/ForgeX/G0/Images_G0A/ab3.png

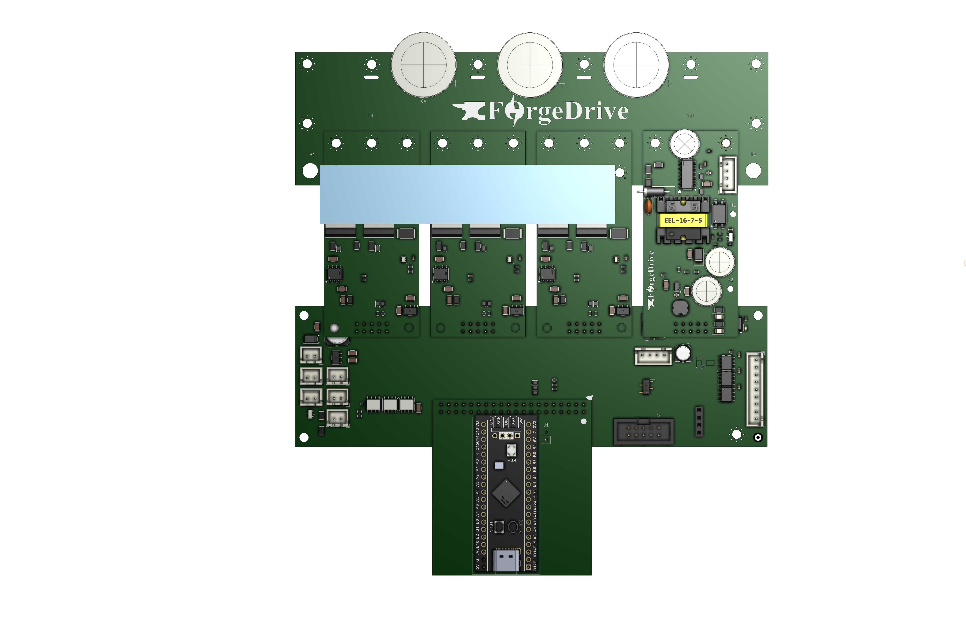
Doc/ForgeX/G0/Images_G0A/ab3.png
