Omar-Magdy0/ForgeDriveHW/Doc/ForgeX/G0/Images_G0A/LVP1.png

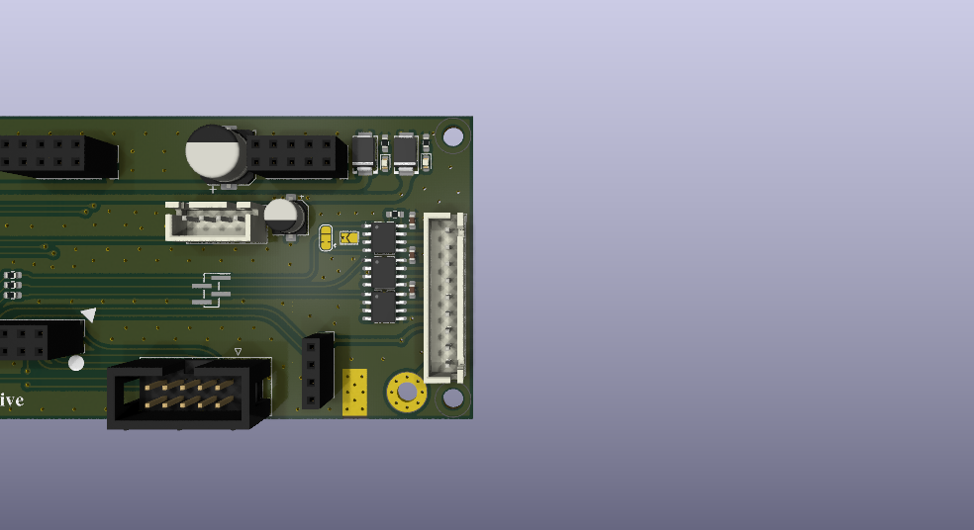
Doc/ForgeX/G0/Images_G0A/LVP1.png
