Omar-Magdy0/ForgeDriveHW/Doc/ForgeX/G0/Images_G0A/PSU0f.png

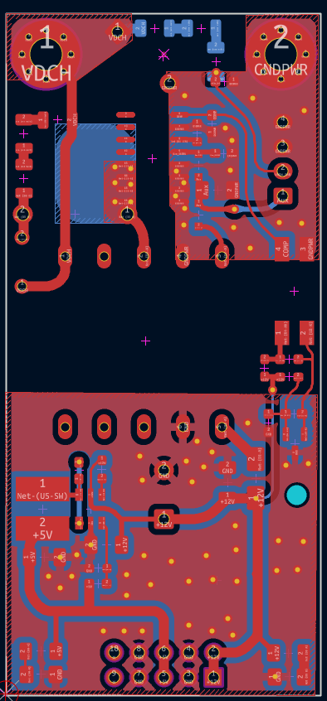
Doc/ForgeX/G0/Images_G0A/PSU0f.png
