Omar-Magdy0/ForgeDriveHW/Doc/ForgeX/G0/Images_G0A/PSU1f.png

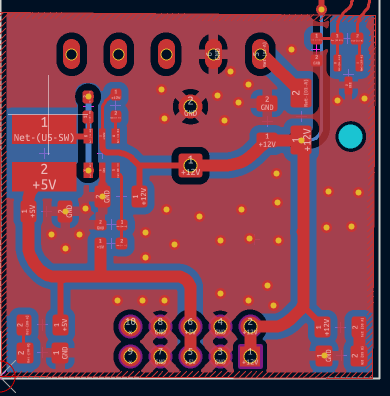
Doc/ForgeX/G0/Images_G0A/PSU1f.png
