Omar-Magdy0/ForgeDriveHW/Doc/ForgeX/G0/Images_G0A/PSU2f.png

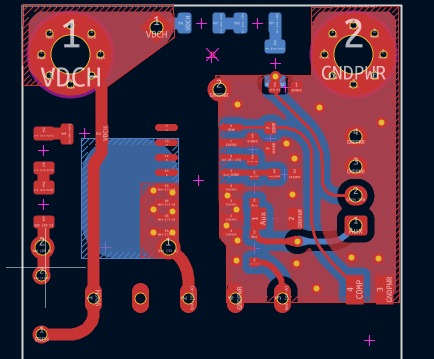
Doc/ForgeX/G0/Images_G0A/PSU2f.png
