Omar-Magdy0/ForgeDriveHW/ForgeX/BlackDev_G0Basic/Doc/BlackDev_G0Basic.step

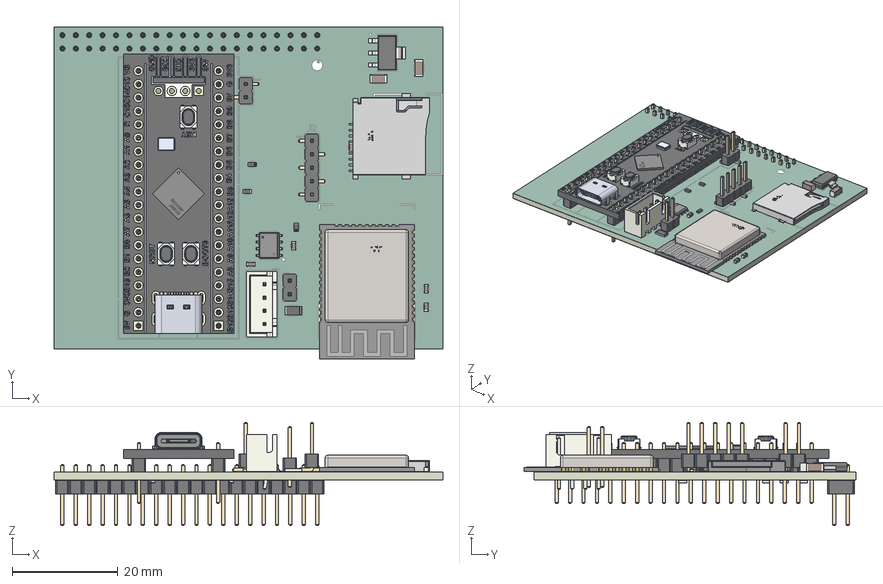
[picture p43: CAD file, 2026-09-02]
ForgeX/BlackDev_G0Basic/Doc/BlackDev_G0Basic.step
73.7 x 62.9 x 19.5 mm
PinHeader_1x02_P254mm_Vertical_SMD_Pin1Right
C_1206_3216Metric x 2
SOP-8_L4.9-W3.9-P1.27-LS6.0-BL-1
C_0603_1608Metric x 5
R_0603_1608Metric x 7
SOT-223
PinHeader_1x02_P254mm_Vertical
USB Type C Port (SMD Type) v1
PTS810 SJK 250 SMTR LFS--3DModel-STEP-1 v2 x 2
PTS810 SJK 250 SMTR LFS--3DModel-STEP-1 v2(Mirror)
STM32F411CEU6 v2
ECS-135.60-12-33Q-JES-TR v1
PinHeader_1x20_P254mm_Vertical x 2
WIFI-SMD_L25.5-W18.0-H3.1-ESP32-WROOM-32E
JST_B4B_XH_A
PinHeader_1x05_P254mm_Vertical_SMD_Pin1Left
TF-SMD_TF-PUSH
R_1206_3216Metric
PinHeader_2x20_P254mm_Vertical
BlackDev_G0Basic_silkscreen x 2
BlackDev_G0Basic_soldermask x 2
BlackDev_G0Basic_PCB
