Omar-Magdy0/ForgeDriveHW/ForgeX/HBM_G0VH4C5/revA/Doc/HBM_G0VH4C5.step

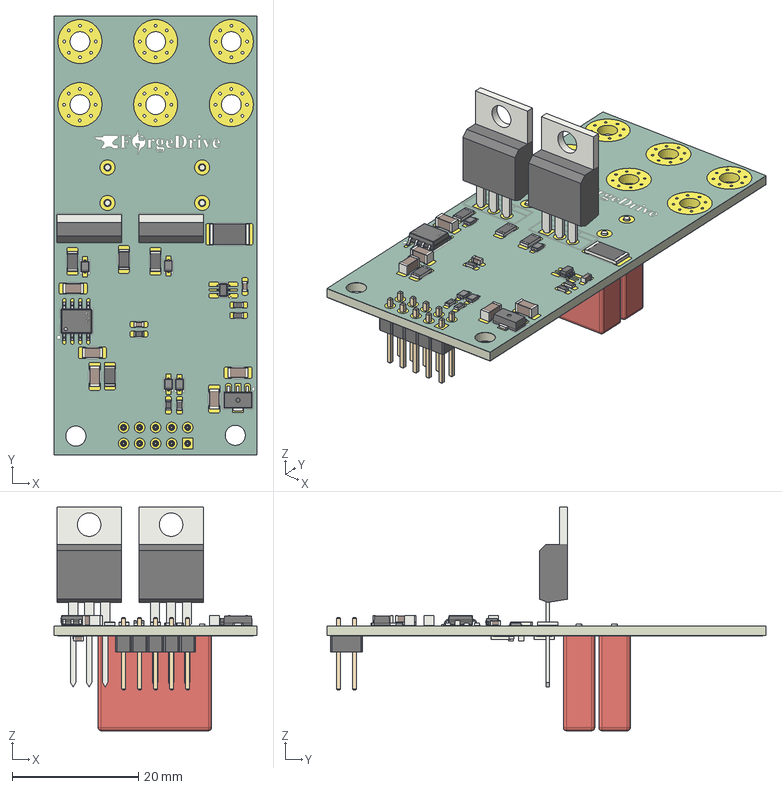
[picture p44: CAD file, 2026-08-10]
ForgeX/HBM_G0VH4C5/revA/Doc/HBM_G0VH4C5.step
32.1 x 69.6 x 35.5 mm
TO-220-3_Vertical x 2
R_0603_1608Metric x 7
C_1206_3216Metric x 5
C_0603_1608Metric x 4
adbeea57-9c39-11ed-93f0-dde97e994e83_part
adbeea58-9c39-11ed-93f0-dde97e994e83_part
adbeea59-9c39-11ed-93f0-dde97e994e83_part
R_2512_6332Metric
R_1206_3216Metric x 6
SO-8_L4.9-W3.9-H1.5-LS5.9-P1.27
SOT-363_SC-70-6
SOD-323_L1.7-W1.3-LS2.5-FD x 4
C_Rect_L180mm_W50mm_P1500mm_FKS3_FKP3 x 2
PinHeader_2x05_P254mm_Vertical
HBM_G0VH4C5_copper
HBM_G0VH4C5_silkscreen x 2
HBM_G0VH4C5_soldermask x 2
HBM_G0VH4C5_PCB
