Omar-Magdy0/ForgeDriveHW/ForgeX/LVP_G0S4B/revA/Doc/LVP_G0S4B.step

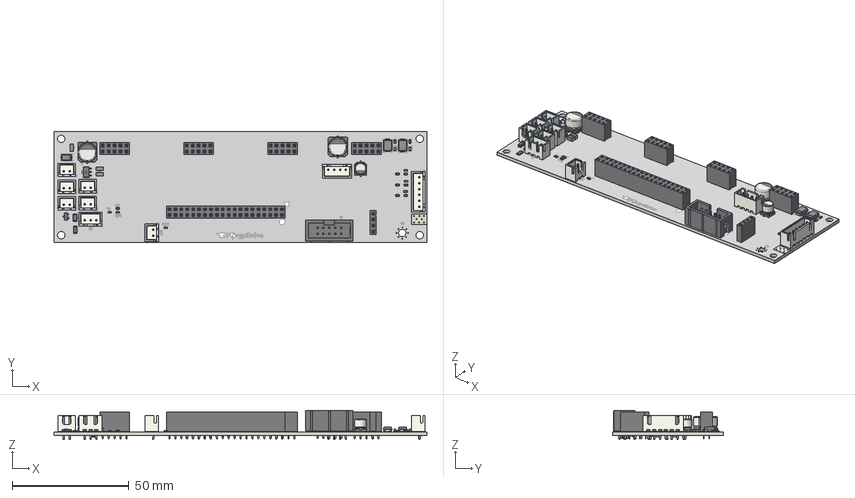
[picture p45: CAD file, 2026-09-03]
ForgeX/LVP_G0S4B/revA/Doc/LVP_G0S4B.step
159.9 x 47.5 x 12.5 mm
R_0603_1608Metric x 17
PinSocket_2x20_P2.54mm_Vertical
SMB_L4.6-W3.6-LS5.3-RD x 2
JST_B2B_XH_A x 6
PinSocket_2x05_P2.54mm_Vertical x 4
C_0603_1608Metric x 4
R_1206_3216Metric x 4
SMA_L4.3-W2.6-LS5.2-RD
SOT-23
CP_Elec_8x65 x 2
JST_B3B_XH_A
PinSocket_1x04_P2.54mm_Vertical
IDC_Header_2x05_P254mm_Vertical
LED_0603_1608Metric x 2
JST_B6B_XH_A
C_1206_3216Metric x 3
CP_Elec_5x54
JST_B4B_XH_A
adbeea57-9c39-11ed-93f0-dde97e994e83_part
adbeea58-9c39-11ed-93f0-dde97e994e83_part
adbeea59-9c39-11ed-93f0-dde97e994e83_part
LVP_G0S4B_silkscreen x 2
LVP_G0S4B_soldermask x 2
LVP_G0S4B_PCB
