Omar-Magdy0/ForgeDriveHW/ForgeX/PMB_G0S4V80B/revA/Doc/PMB_G0S4V80B.step

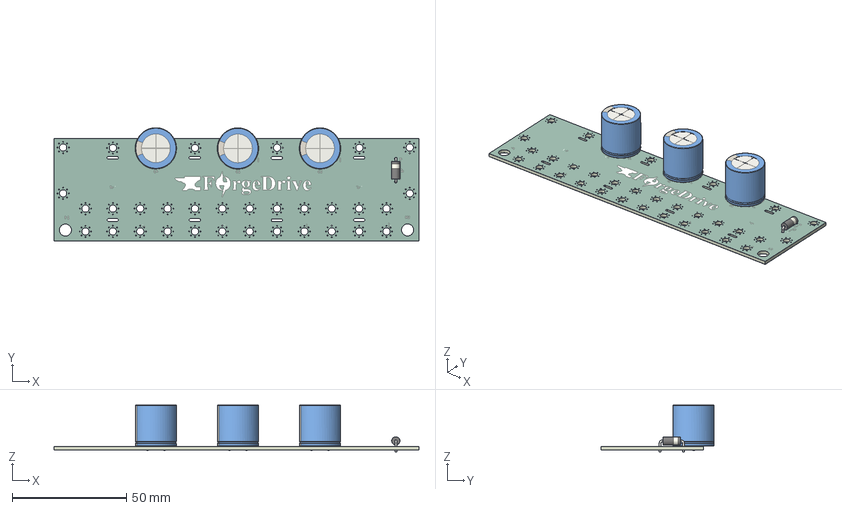
[picture p46: CAD file, 2026-09-05]
ForgeX/PMB_G0S4V80B/revA/Doc/PMB_G0S4V80B.step
160.1 x 49.8 x 20.5 mm
CP_Radial_D180mm_P750mm x 3
D_DO-15_P10.16mm_Horizontal
PMB_G0S4V80B_silkscreen
PMB_G0S4V80B_soldermask x 2
PMB_G0S4V80B_PCB
