Omar-Magdy0/ForgeDriveHW/ForgeX/PMB_G0S4VH4/revA/Doc/PMB_G0S4VH4.step

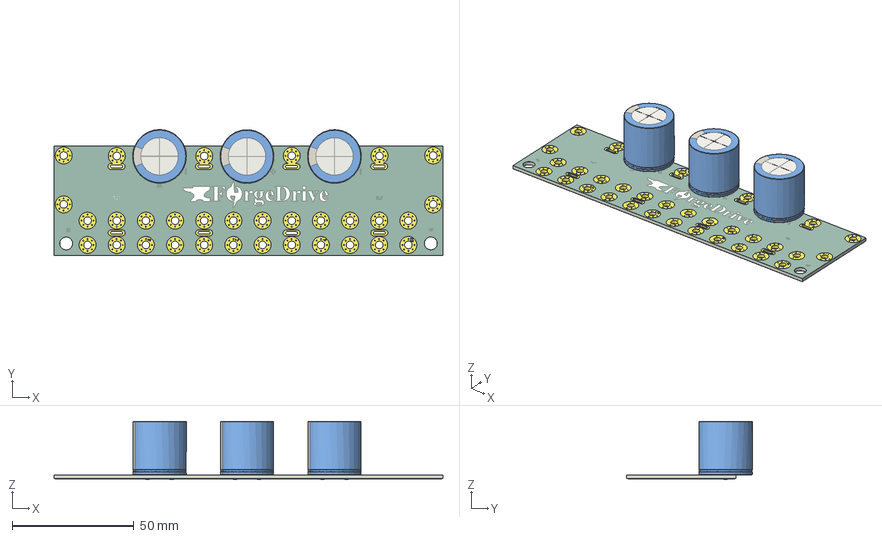
[picture p47: CAD file, 2026-08-10]
ForgeX/PMB_G0S4VH4/revA/Doc/PMB_G0S4VH4.step
160.1 x 51.8 x 24.0 mm
CP_Radial_D220mm_P1000mm_SnapIn x 3
PMB_G0S4VH4_copper
PMB_G0S4VH4_silkscreen
PMB_G0S4VH4_soldermask x 2
PMB_G0S4VH4_PCB
