Omar-Magdy0/ForgeDriveHW/ForgeX/PSU_G0V48P15R/revA/Doc/PSU_G0V48P15R.step

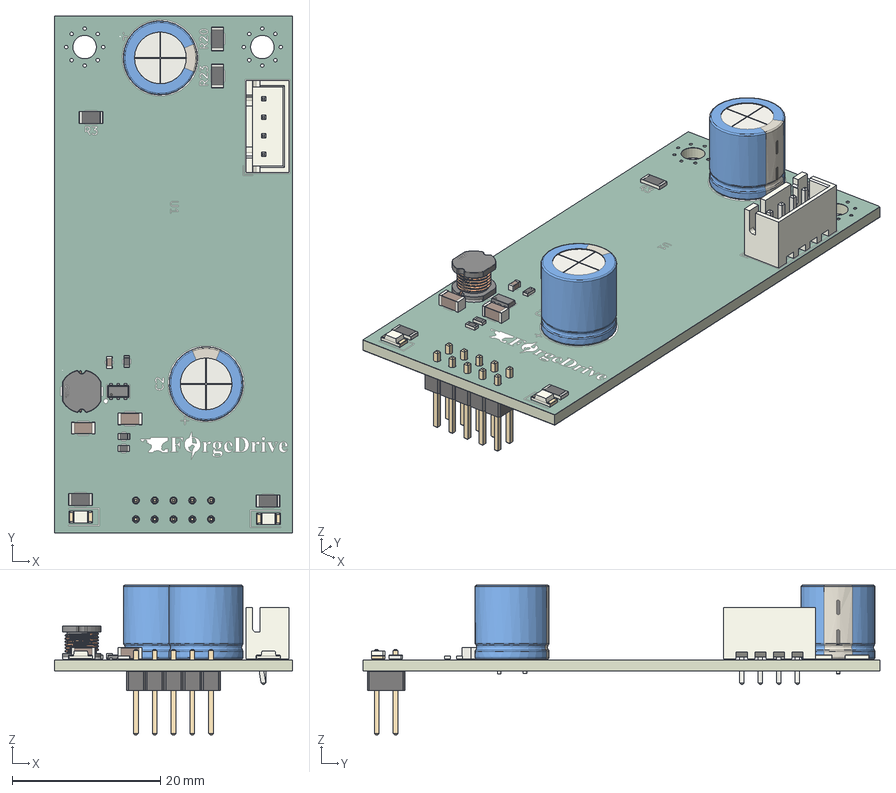
[picture p48: CAD file, 2026-09-05]
ForgeX/PSU_G0V48P15R/revA/Doc/PSU_G0V48P15R.step
32.1 x 69.8 x 20.2 mm
IND-SMD_L5.8-W5.2-H4.5
JST_B4B_XH_A
LED_1206_3216Metric x 2
R_1206_3216Metric x 5
R_0603_1608Metric x 3
SOT-23-6_L2.9-W1.6-P0.95-LS2.8-BL_3
C_0603_1608Metric
CP_Radial_D100mm_P350mm x 2
C_1206_3216Metric x 2
PinHeader_2x05_P254mm_Vertical
PSU121D_silkscreen x 2
PSU121D_soldermask x 2
PSU121D_PCB
