Omar-Magdy0/ForgeDriveHW/ForgeX/RJ45CANOpenDaisyChain_G0S2/Doc/RJ45CANOpenDaisyChain_G0S2.step

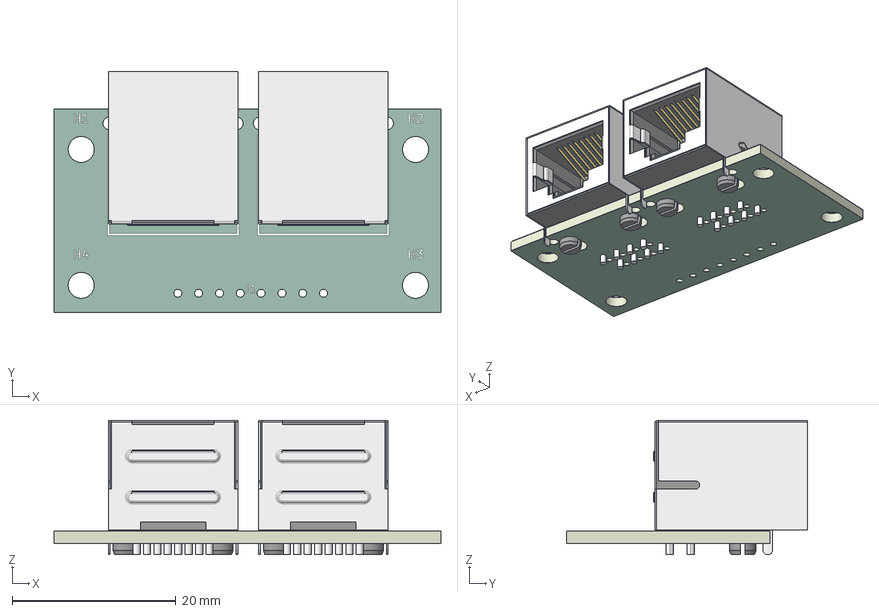
[picture p49: CAD file, 2026-09-06]
ForgeX/RJ45CANOpenDaisyChain_G0S2/Doc/RJ45CANOpenDaisyChain_G0S2.step
47.2 x 29.4 x 16.4 mm
RJ45-TH_L18.4-W15.8-H13.5 x 2
RJ45CANOpenDaisyChain_G0S2_silkscreen
RJ45CANOpenDaisyChain_G0S2_soldermask x 2
RJ45CANOpenDaisyChain_G0S2_PCB
