Omar-Magdy0/ForgeDriveHW/ForgeX/RJ45CANOpenDaisyChain_G0S2/Doc/RJ45CANOpenDaisyChain_G0S2.pdf

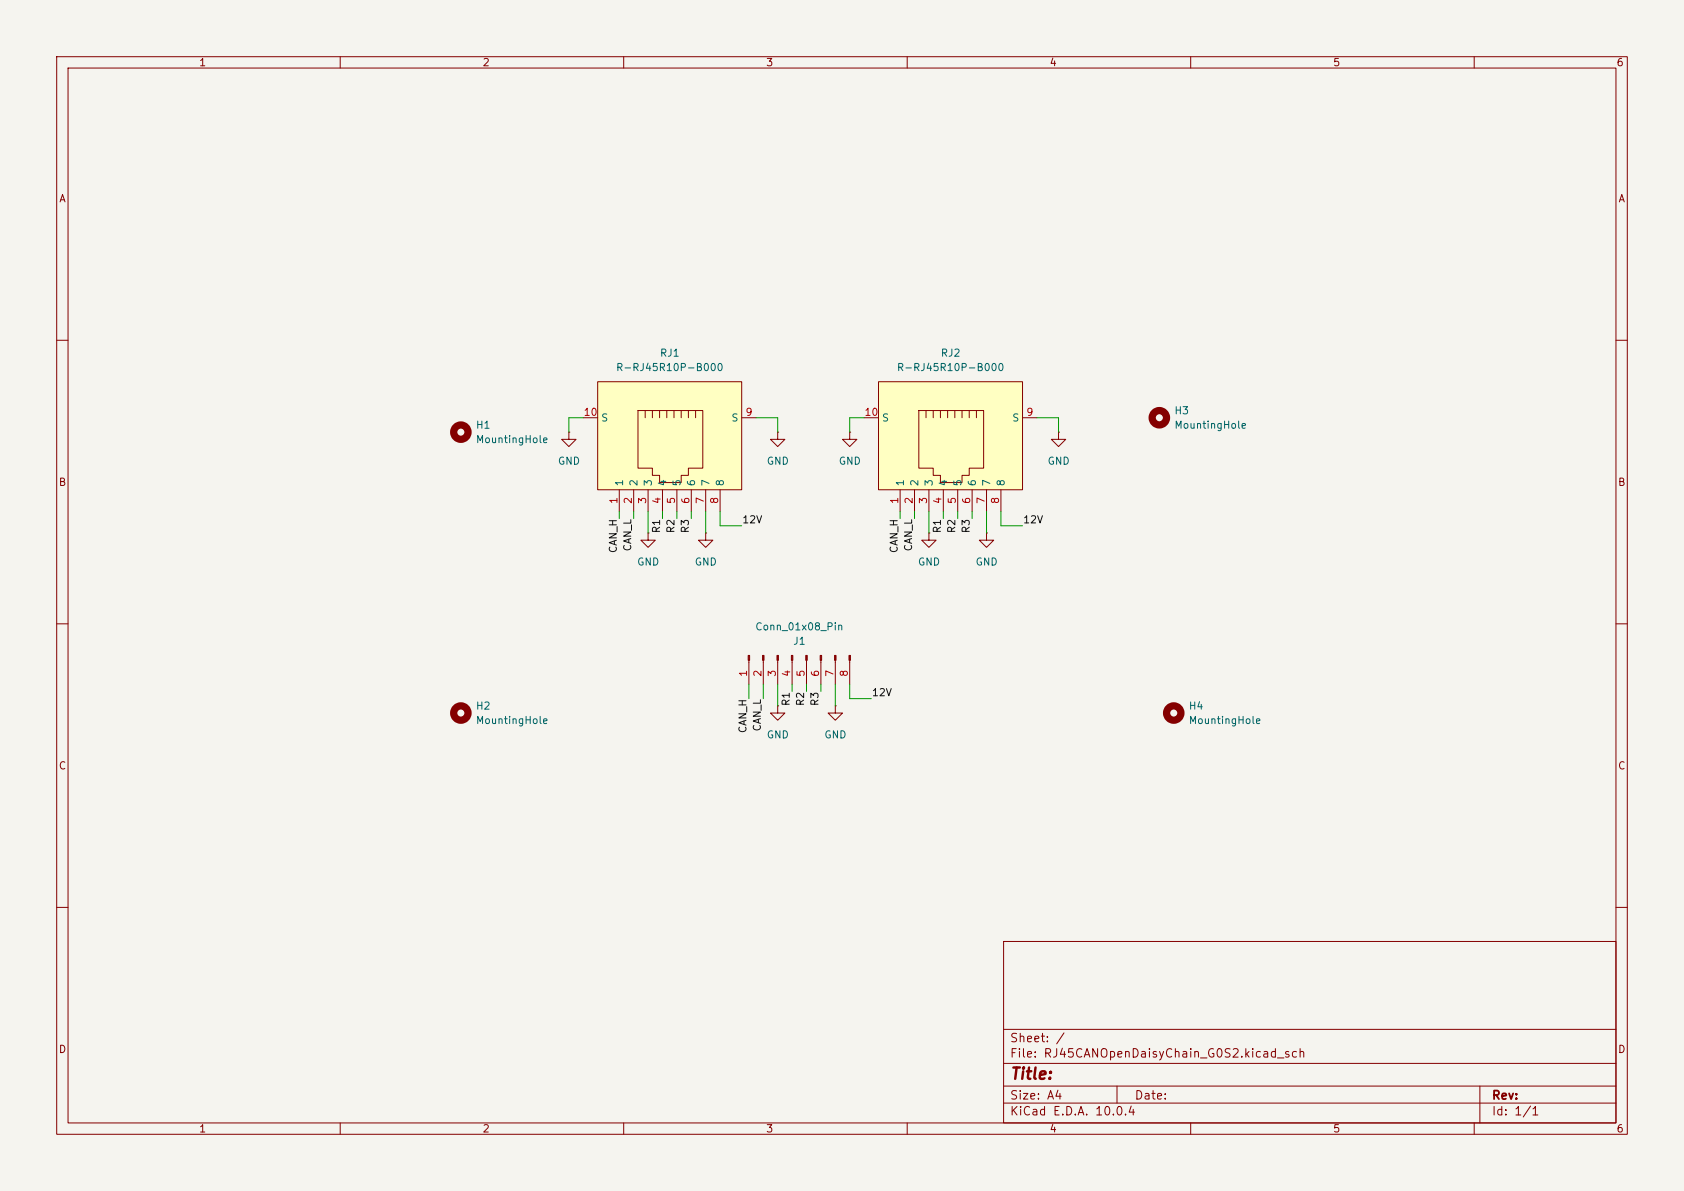
[picture p50: page 1]

Size: A4 | Rev:
KiCad E.D.A. 10.0.4 | Id: 1/1
