Omar-Magdy0/ForgeDriveHW/ForgeX/BlackDev_G0Basic/Doc/BlackDev_G0Basic.pdf

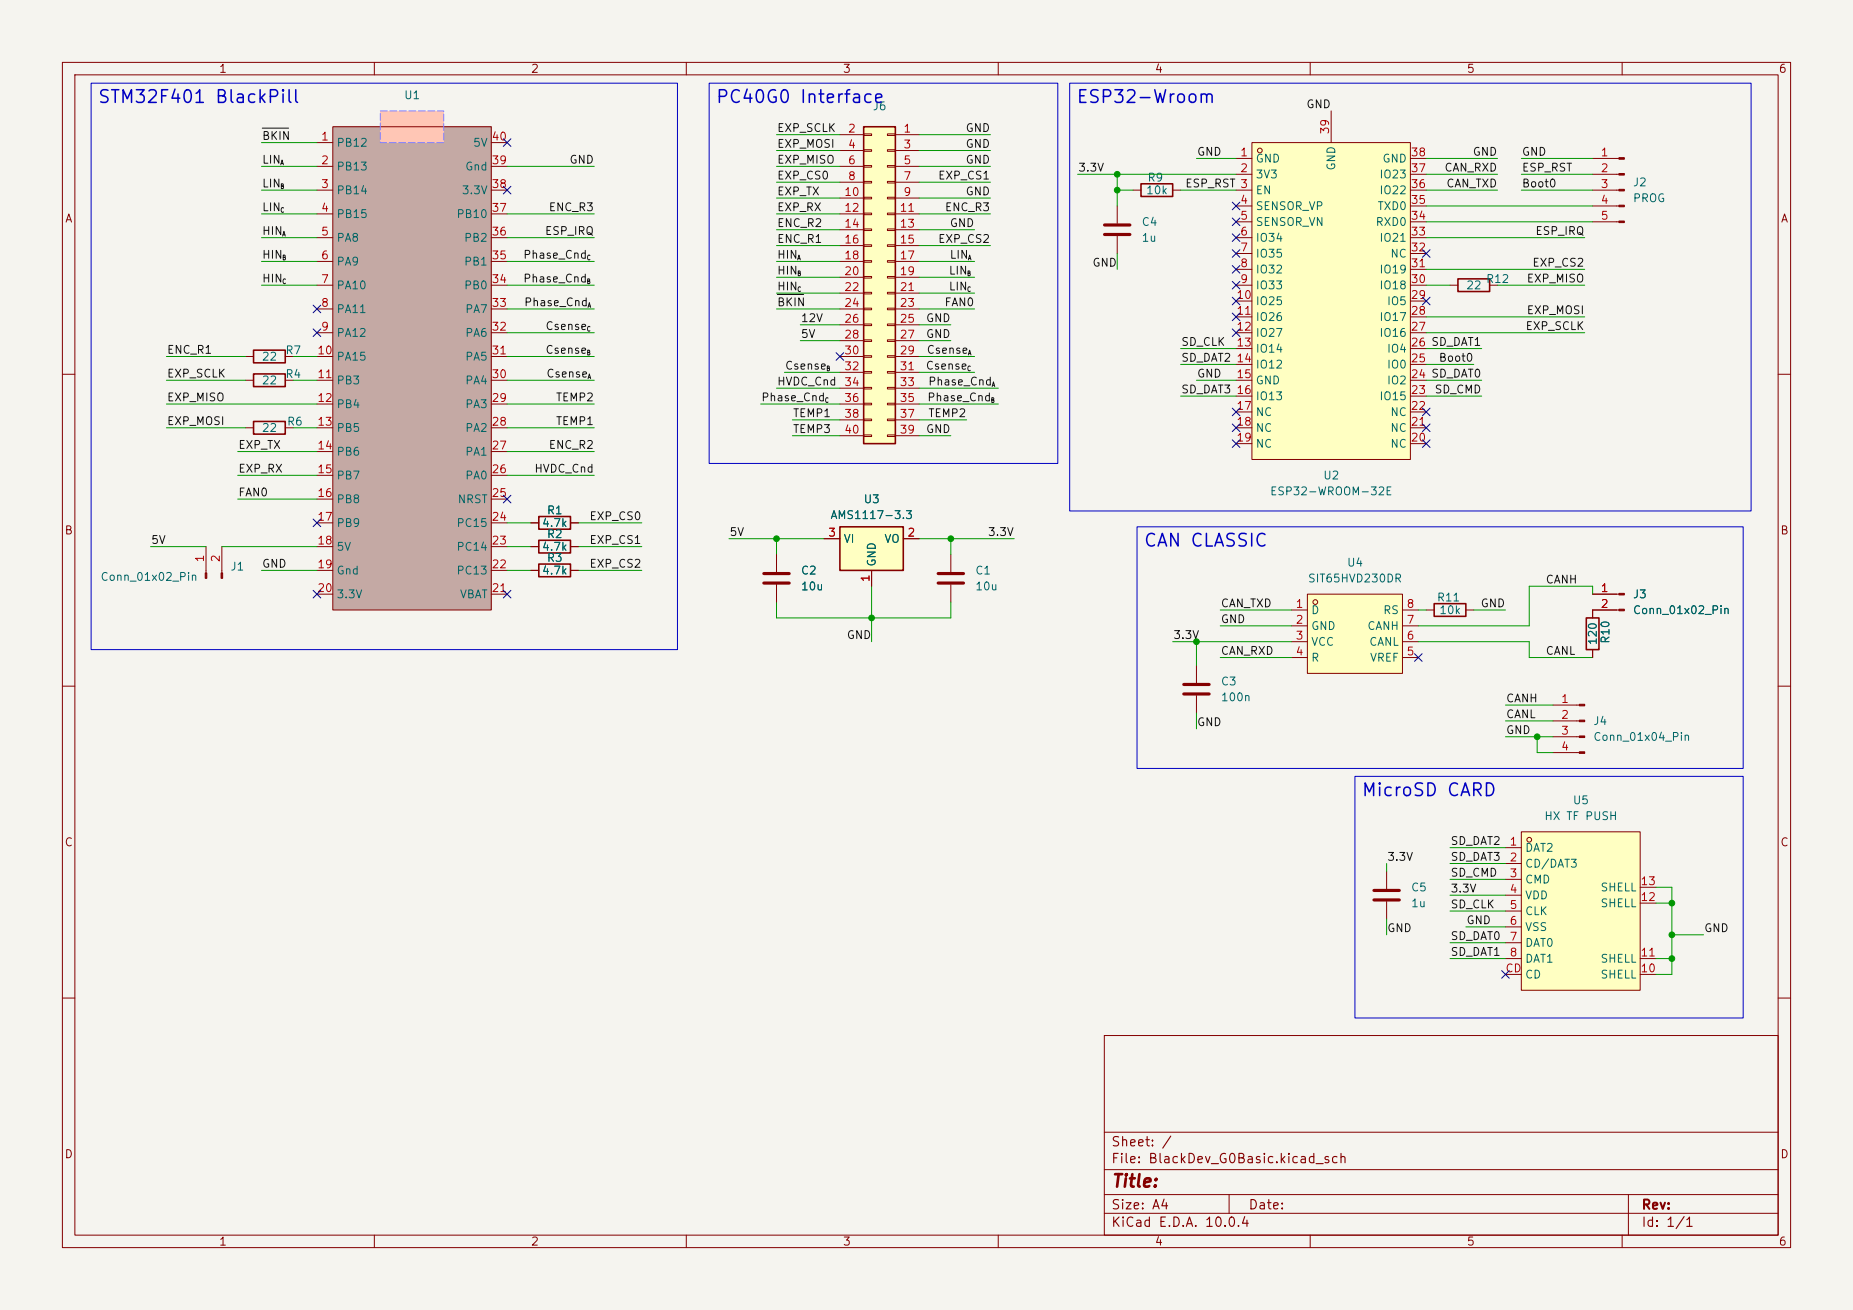
[picture p51: page 1]

Size: A4 | Rev:
KiCad E.D.A. 10.0.4 | Id: 1/1
