Omar-Magdy0/ForgeDriveHW/ForgeX/PSU_G0V48P15R/revA/Doc/PSU_G0V48P15R.pdf

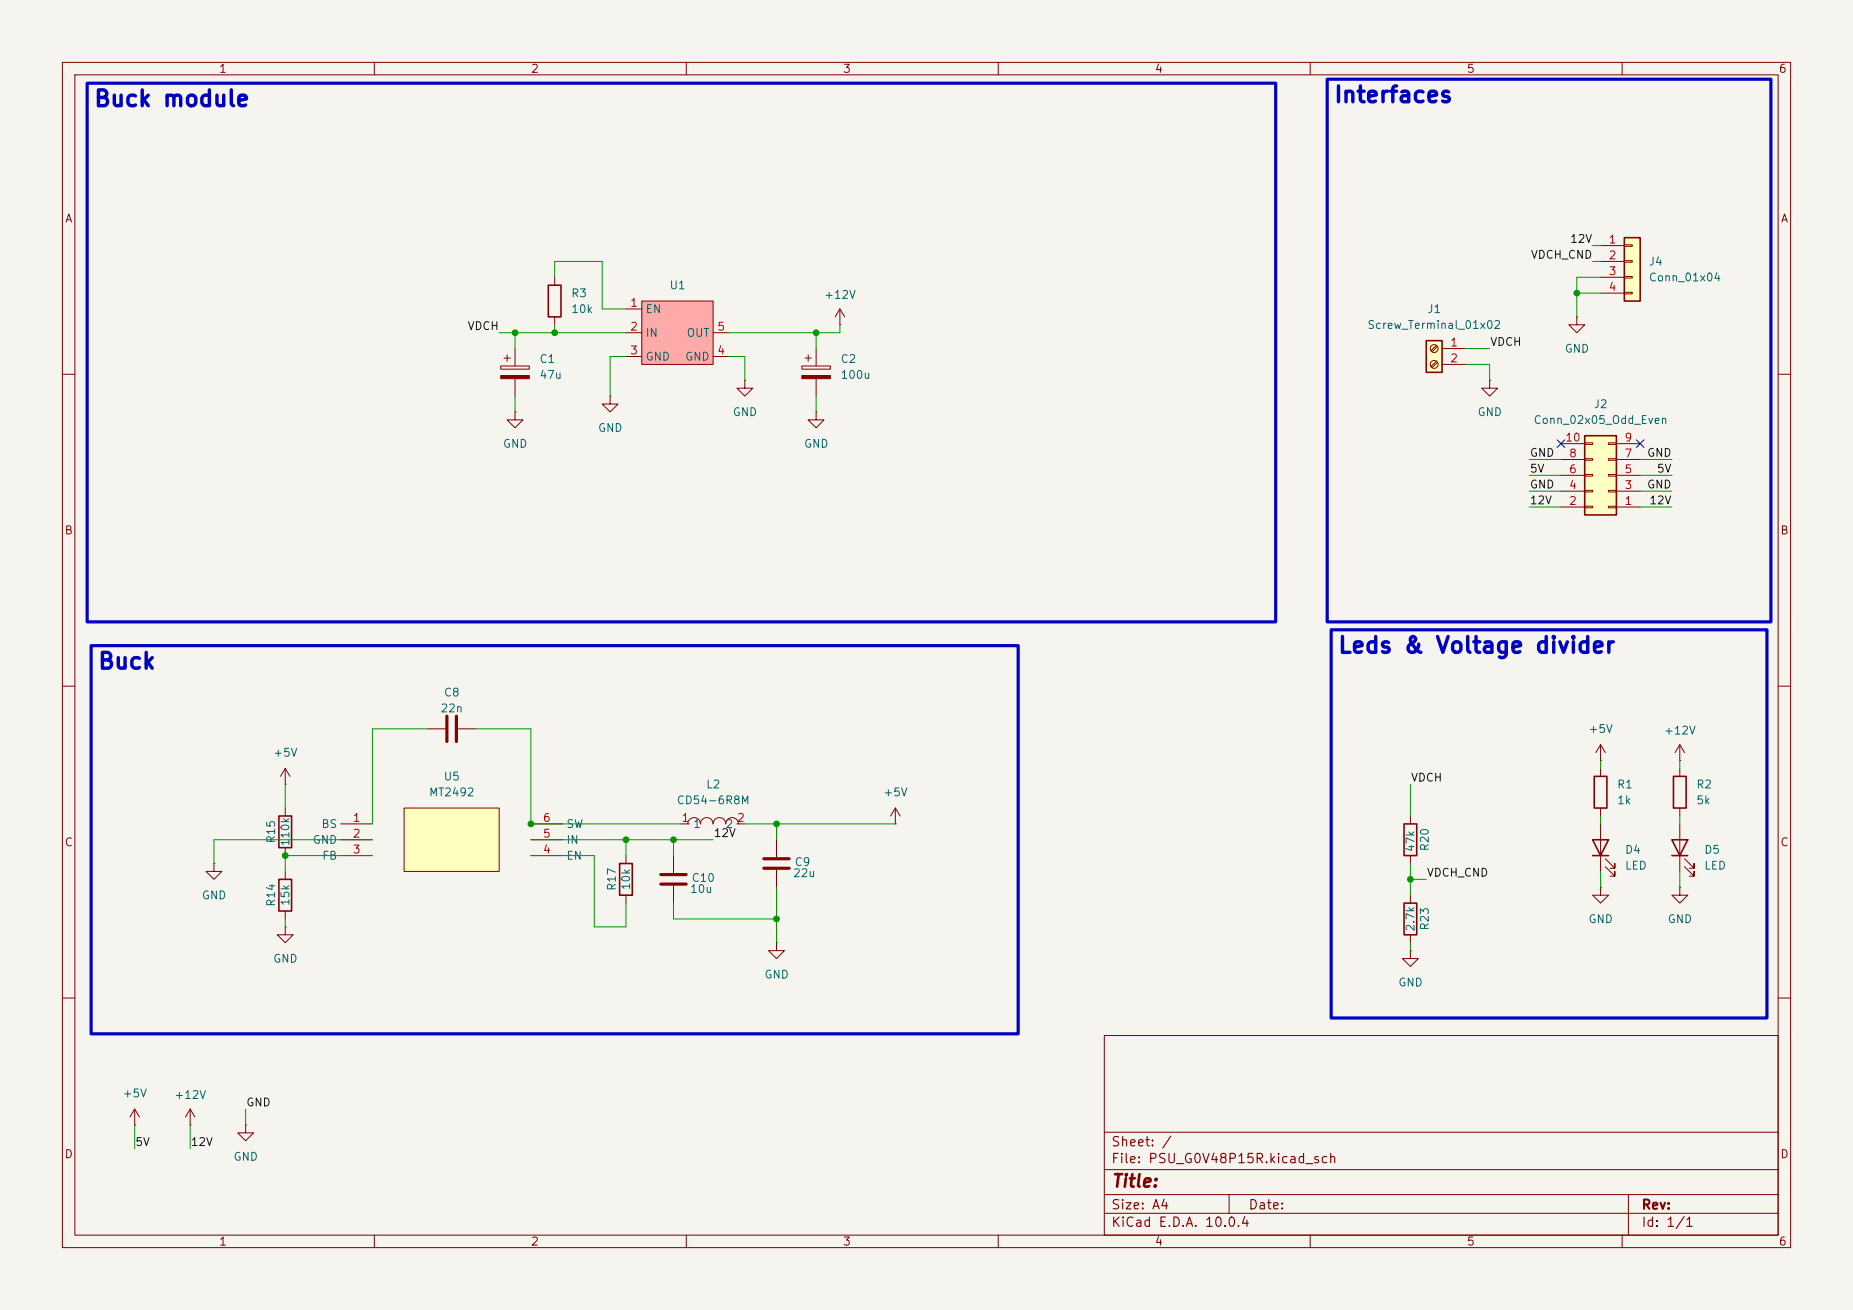
[picture p52: page 1]

Size: A4 | Rev:
KiCad E.D.A. 10.0.4 | Id: 1/1
