Omar-Magdy0/ForgeDriveHW/ForgeX/PMB_G0S4V80B/revA/Doc/PMB_G0S4V80B.pdf

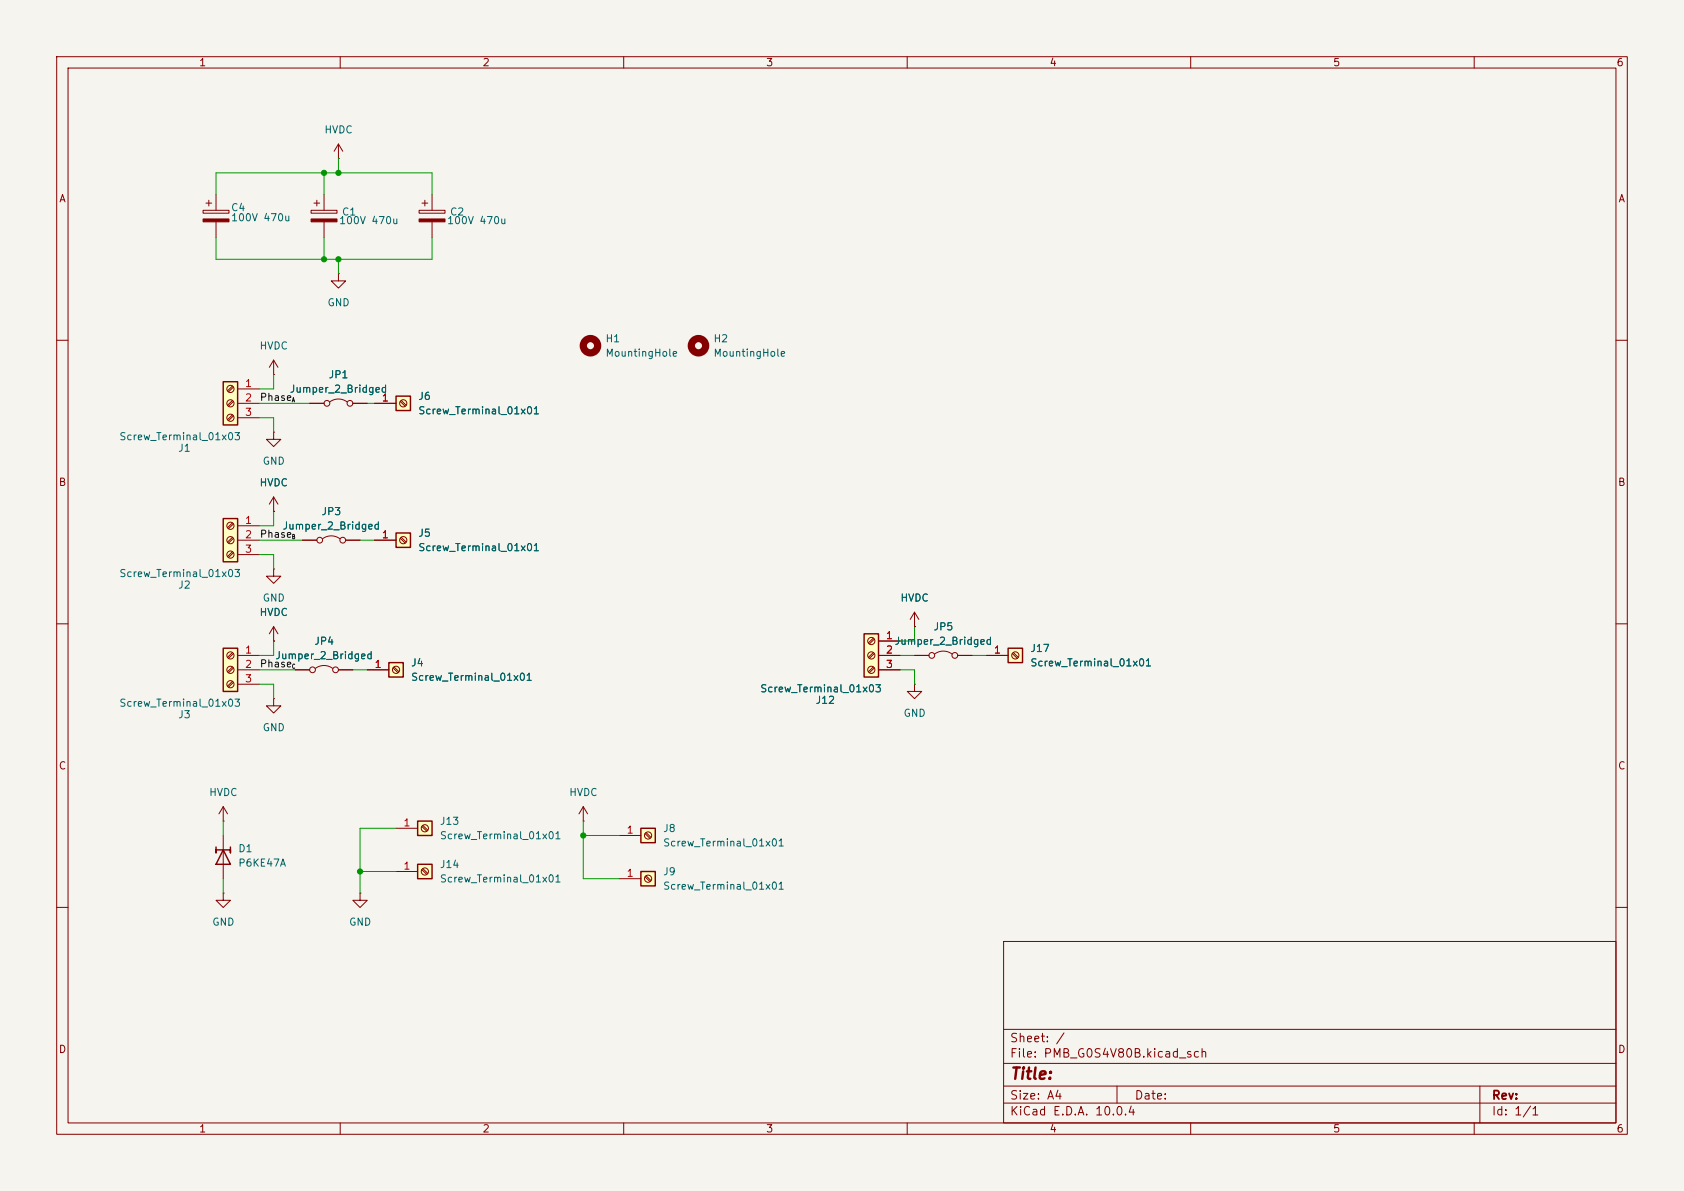
[picture p53: page 1]

Size: A4 | Rev:
KiCad E.D.A. 10.0.4 | Id: 1/1
