Omar-Magdy0/ForgeDriveHW/ForgeX/LVP_G0S4B/revA/Doc/LVP_G0S4B.pdf

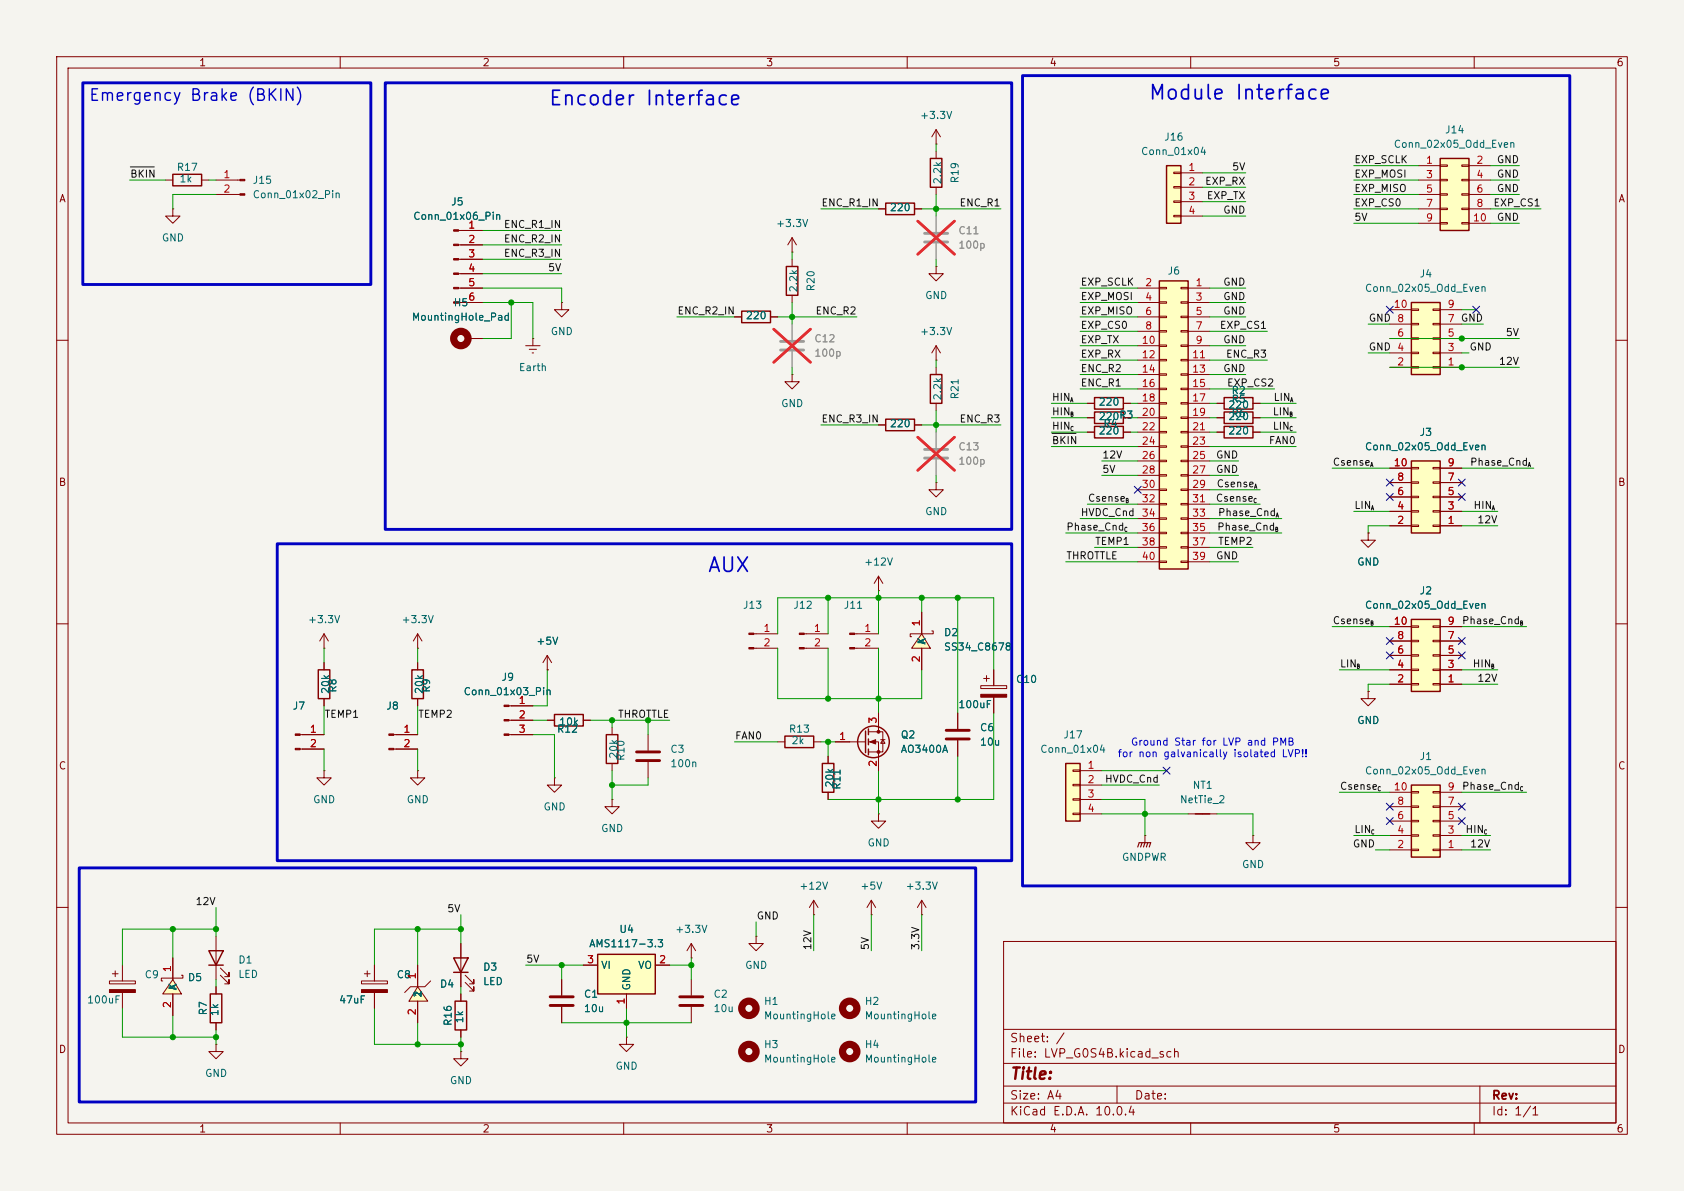
[picture p54: page 1]

Ground Star for LVP and PMB

Size: A4 | Rev:
KiCad E.D.A. 10.0.4 | Id: 1/1
