Omar-Magdy0/ForgeDriveHW/Doc/ForgeX/G0/Images_G0A/HBM_G0VH4C5.pdf

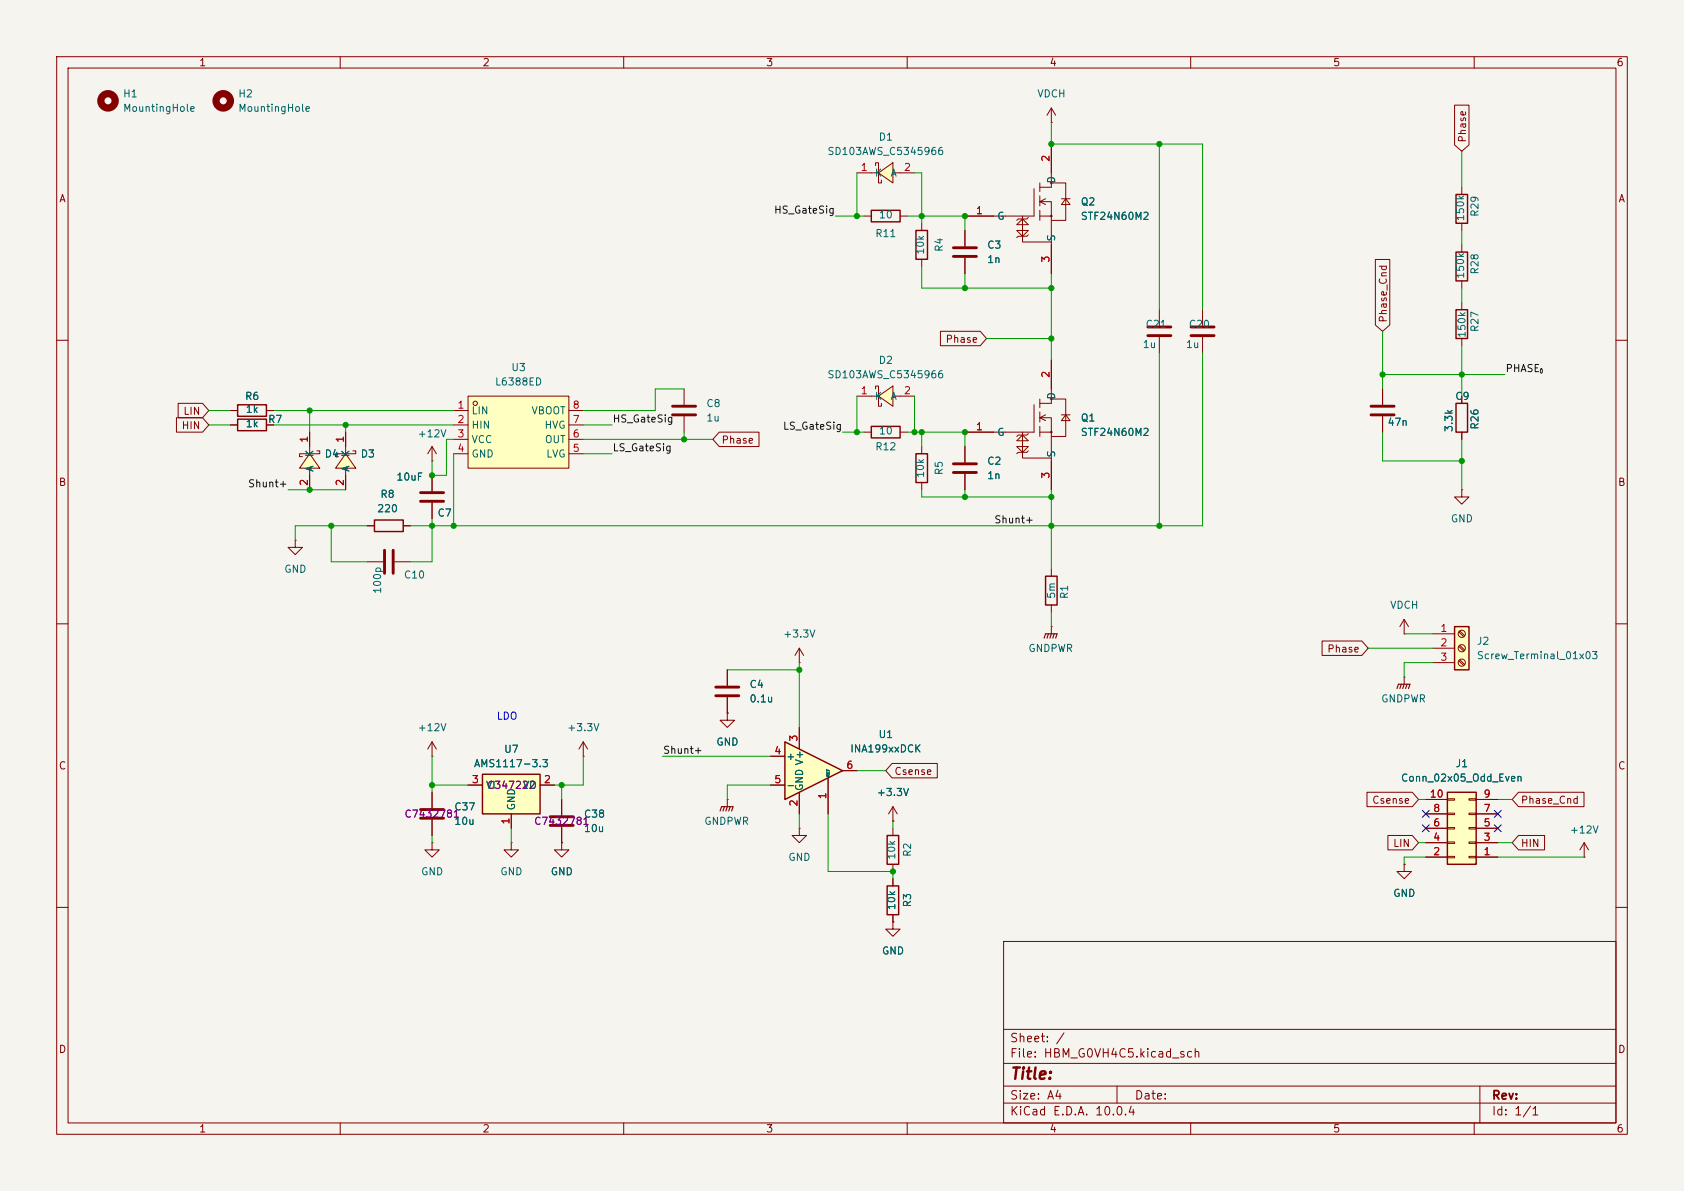
[picture p55: page 1]

Size: A4 | Rev:
KiCad E.D.A. 10.0.4 | Id: 1/1
