Omar-Magdy0/ForgeDriveHW/Doc/ForgeX/G0/Images_G0A/PSU_G0P20N.pdf

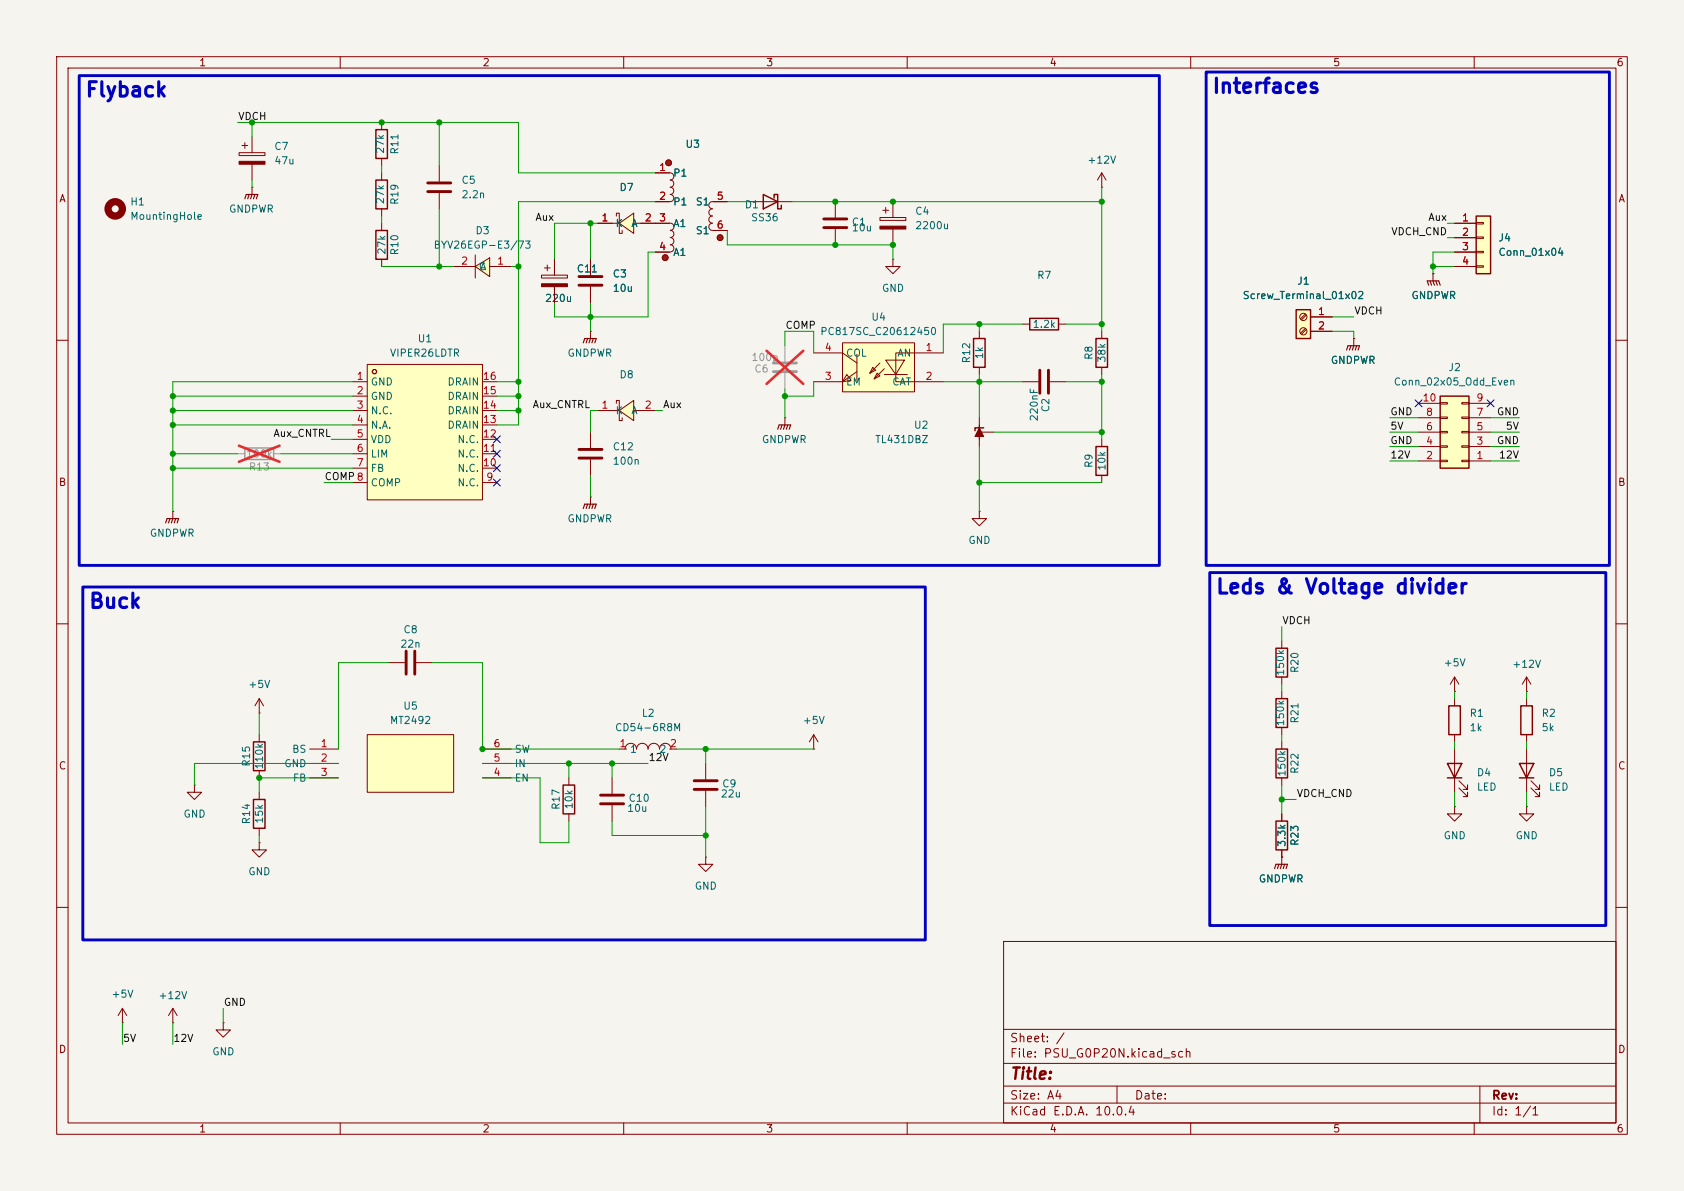
[picture p56: page 1]

Leds & Voltage divider Buck

Size: A4 | Rev:
KiCad E.D.A. 10.0.4 | Id: 1/1
