Omar-Magdy0/ForgeDriveHW/ForgeX/HBM_G0VH4C5/revA/Doc/simulation/HBM_SLinverter_test.asc

A1: inv; Vhigh=3.3
C1: cap; 47µ
C2: cap; 20µ; Rser=50m Lser=30n
C3: cap; 20µ; Rser=50m Lser=30n
C4: cap; 10µ
C7: cap; 10p
L1: ind; 10µ
L2: ind; 30n
L3: ind; 10µ
L5: ind; 20n
LOAD_R: res; 14
R5: res; 10m
S2: sw; MYSW
V1: voltage; PULSE(0 5 1m 20n 20n 1e6 1e9 1)
V3: voltage; 12V; Rser=50m
V4: voltage; PULSE(0 3.3 1m 10n 10n 5u 10u 100000)
VDCH: voltage; 400; Rser=0.5
X1: HBM_G0VH4C5
Named nets: 0, PGND, SW, LR0, Virtual_Ground, VDCH
.tran 0 2m 0 1u startup uic
.model MYSW SW(Ron=1m Roff=1Meg vt=3 vh=1)
.save I(LOAD_R) V(SW) V(PGND) V(SW,LR0) V(Virtual_Ground) I(VDCH) V(VDCH)
.save V(X1:XQH_D) V(X1:XQL_S) I(X1:RSNUBL) I(X1:RSNUBH)
.save Ix(X1:XQH) Ix(X1:XQL)
