Omar-Magdy0/ForgeDriveHW/ForgeX/HBM_G0VH4C5/revA/Doc/simulation/HBM_SLinverter_test1.asc

A1: diffschmitt; vhigh=3.3 vt=0.01 vh=0.01
C1: cap; 150µ
C2: cap; 5m; Rser=50m Lser=10n Cpar=100n
C3: cap; 5m; Rser=50m Lser=10n Cpar=100n
C4: cap; 10µ
C5: cap; 10p
L1: ind; 10µ
L2: ind; 30n; Cpar=10p
L3: ind; 20n
LOAD_L: ind; 1m
LOAD_R: res; 8.5
R1: res; 10m
R2: res; 100k
R3: res; 100k
S2: sw; MYSW
V1: voltage; PULSE(0 5 4m 20n 20n 1e6 1e9 1)
V3: voltage; 12V; Rser=50m
V4: voltage; PULSE(0 5 4m 50u 50u 0 100u 100000)
V5: voltage; SINE(2.5 2.3 50 4m 0 0 10e6)
VDCH: voltage; 400; Rser=0.5
X1: HBM_G0VH4C5
Named nets: 0, Virtual_Ground, LR0, SW, PGND, VDCH
.tran 0 44m 0 1u startup
.model MYSW SW(Ron=1m Roff=1Meg vt=3 vh=1)
.save I(LOAD_R) V(SW) V(PGND) V(SW,LR0) V(Virtual_Ground) I(VDCH) V(VDCH)
.save V(X1:XQH_D) V(X1:XQL_S) I(X1:RSNUBL) I(X1:RSNUBH)
.save Ix(X1:XQH) Ix(X1:XQL)
Make sure to use Alternate solver from SPICE settings
