Omar-Magdy0/ForgeDriveHW/ForgeX/HBM_G0VH4C5/revA/Doc/simulation/STFH24N60M2_test_bodyDiode.asc

C1: cap; 100µ
C2: cap; 1p
L2: ind; 100µ
R1: res; 1k
R2: res; 25
V1: voltage; 60
V3: voltage; PWL(0 0 50u 0 50.1u 12 78u 12 78.1u 0 90u 0 90.1u 12 100u 12 100.1u 0)
X1: STFH24N60M2
X2: STFH24N60M2
Named nets: 0
.model MYD D(Ron=1u Roff=1Meg Vrev=480 Vfwd=0)
.tran 0 200u 0 10n
