Omar-Magdy0/ForgeDriveHW/ForgeX/HBM_G0VH4C5/revA/Doc/simulation/STFH24N60M2_test_bodyDiode2.asc

Id: current; 1
R1: res; 10
R2: res; 10
X1: STFH24N60M2
Named nets: 0
.model MYD D(Ron=1u Roff=1Meg Vrev=480 Vfwd=0)
.dc Id 0.1 20 0.5
