Omar-Magdy0/ForgeDriveHW/ForgeX/HBM_G0VH4C5/revA/Doc/simulation/STFH24N60M2_test_cap.asc

B1: bi; I=100n*(time>10u)
B2: bi; I=18
D1: diode; MYD
V1: voltage; 480
X1: STFH24N60M2
Named nets: 0, gate
.tran 0 400m 0 1u
.model MYD D(Ron=1u Roff=1Meg Vrev=480 Vfwd=0)
.ic V(gate)=0
