Omar-Magdy0/ForgeDriveHW/ForgeX/HBM_G0VH4C5/revA/Doc/simulation/L6388_test.asc

A2: inv; Vhigh=3.3
C1: cap; 1n
C2: cap; 1n
R1: res; 1Meg
V1: voltage; 15
V2: voltage; 15
V3: voltage; PULSE(0 3.3 1p 1p 1p 20u 40u 10)
X1: L6388_Behavioral
Named nets: 0
.tran 0 1m 0 50n
