Omar-Magdy0/ForgeDriveHW/ForgeX/HBM_G0VH4C5/revA/Doc/simulation/STFH24N60M2_test_outChar.asc

Vds: voltage; ""
Vgs: voltage; ""
X1: STFH24N60M2
Named nets: 0
.dc Vds 0 20 0.2 Vgs list 4 5 6 7 8 9 10
