Omar-Magdy0/ForgeDriveHW/ForgeX/HBM_G0VH4C5/revA/Doc/simulation/STFH24N60M2_test_tranChar.asc

R1: res; 90
V1: voltage; 400
Vgs: voltage; ""
X1: STFH24N60M2
Named nets: 0
.dc Vgs 0 10 0.5
