Omar-Magdy0/ForgeDriveHW/ForgeX/PSU_G0P20N/revA/Doc/simulation/PSU_G0P20N.asc

A1: diffschmtbuf; trise=10n Vh=40m Vt=20m
A2: srflop; Vhigh=12 Vlow=0 Trise=120n Ref=0.5
A3: or
A4: diffschmtbuf; trise=10n Vh=40m Vt=20m
B1: bv; V=-I(Lpri)
B2: bi; I=if(V(ILIM)<0.7, 0.8u, 0)
C1: cap; Q = 580p * pow(max(x, 1), 0.443)
C2: cap; 2.2n
C3: cap; 230n
C4: cap; 100p
C5: cap; 10n ic=0
C6: cap; 100µ
Cout: cap; 2200µ; Rser=35m
D1: diode
D2: diode; Dout
D3: diode; DIDEAL
D5: diode
L1: ind; 10µ
Lpri: ind; 1.6m; Rser=1
Lsec: ind; 25µ; Rser=50m
R2: res; 38k
R3: res; 24
R4: res; 10k
R5: res; 1.2k
R6: res; 1k
R7: res; 15k
R8: res; 20k
R9: res; 10k
R10: res; 17
R11: res; 11
RSnub: res; 84k
S1: sw; Fet
S2: sw; Fet
S3: sw; Fet
U1: PC817A
U2: TL431
V1: voltage; 3
V2: voltage; 400; Rser=50m
V3: voltage; 5
V4: voltage; PULSE(0 5 100u 10n 10n 1u 16.66u 10e6)
V5: voltage; PULSE(3 10 35m 100n 100n 10e6 10e7 10e6)
V6: voltage; PULSE(3 10 50m 100n 100n 10e6 10e7 10e6)
Named nets: 0, Vout, ILIM, SW, VsnubL, Vsnubh
.model Fet SW(Ron=7 Roff=1Meg Vt=5 Vh=-2 Ilimit=10)
K1 Lpri Lsec 0.995
.tran 0 70m 0 1u
.model Dout D(Ron=10m Roff=1Meg Vfwd=0.4)
.model DIDEAL D(Ron=10m Roff=1Meg Vfwd=0.05)
