Omar-Magdy0/ForgeDriveHW/ForgeX/HBM_G0VH4C5/revA/Doc/simulation/HBM_G0VH4C5.asc

B1: bv; V=I(R1)*50*{R_shunt}+(3.3/2)
C1: cap; 1µ
C2: cap; 220p; Rser=20m
C3: cap; 1n
C4: cap; 1µ
C5: cap; 10p
C6: cap; 10µ
C7: cap; 10p
C8: cap; 10p
C9: cap; 100p
C10: cap; 100p
C11: cap; 220p
C12: cap; 220p
L1: ind; {L_shunt}
L7: ind; {L_PWIN}
L8: ind; {L_SWDecoup}
L10: ind; {L_LGLoop}
L11: ind; {L_HGLoop}
R1: res; {R_shunt}
R3: res; 10k
R5: res; 10k
R8: res; 1k
R9: res; 1k
R10: res; 220
R11: res; 3.3k
R12: res; 450k
RGATE_H: res; {R_gate}
RGATE_L: res; {R_gate}
RSNUBH: res; 25
RSNUBL: res; 25
X1: L6388_Behavioral
XQH: STFH24N60M2
XQL: STFH24N60M2
Named nets: PGND, VDCH, HIN, LIN, VCC, SW, LGND, C_Cnd, SW_Cnd, XQL_S, XQH_D
Measurements
.param L_HGLoop=15n L_LGLoop=25n L_PWIN=40n L_SWDecoup=15n R_shunt=5m L_shunt=3n R_gate=10
