Omar-Magdy0/ForgeDriveHW/ForgeX/HBM_G0VH4C5/revA/Doc/simulation/L6388_Behavioral.asc

A1: schmitt; vt=1.45 vh=0.35 trise=20n
A3: and; Vh=0.5 Vt=0.2 Td=10n
A4: and; Vh=0.5 Vt=0.2 Td=10n
A5: and; trise=10n
A6: diffschmitt; vt=8.95 vh=0.9 Td=10n trise=10n
A7: schmitt; vt=1.45 vh=0.35 trise=20n
A9: and; trise=10n
A11: schmitt; vt=8.95 vh=0.9 Td=10n trise=10n
B1: bv; V=!(delay(V(H_SIG,COM), 320n)>0.5) & !(V(H_SIG,COM)>0.5)
B2: bv; V=!(delay(V(L_SIG, COM), 320n)>0.5) & !(V(L_SIG, COM)>0.5)
B3: bv; V=delay(V(LIN_L, COM), 160n)
B4: bv; V=delay(V(HIN_L, COM), 160n)
B5: bv; V=delay(V(HIN_L, COM), 225n)
B6: bv; V=delay(V(LIN_L, COM), 225n)
B7: bv; V=(V(LIN_L,COM)&V(LIN_L0,COM))+(!V(LIN_L,COM)&V(LIN_L1,COM))
B8: bv; V=(V(HIN_L,COM)&V(HIN_L0,COM))+(!V(HIN_L,COM)&V(HIN_L1,COM))
C4: cap; 10p
C6: cap; 10p
C7: cap; 10p
C8: cap; 10p
D1: diode; INT_BOOT
R1: res; 200k
R3: res; 500k
R6: res; 37.5
R7: res; 37.5
R8: res; 23
R9: res; 23
R11: res; 200k
S1: sw; SWLOG
S2: sw; SWLOG
S3: sw; SWLOG
S4: sw; SWLOG
Named nets: HIN, LIN, COM, VCC, HO, VS, VB, L_SIG, H_SIG, LO, L_UVLO, H_UVLO, HIN_L, HIN_L0, HIN_L1, LIN_L0, LIN_L1, H_SIG0, L_SIG0, LIN_L
.model SWLOG SW(Ron=1m Roff=100Meg Vt=0.5 Vh=0.2)
Propagation delay
Interlock and Deadtime generation
UVLO and final logic
UVLO and final logic
Push pull output
Push pull output
.model INT_BOOT D(Ron=125 Roff=1e9 Vfwd=0)
Internal Bootstrap Diode
