Omar-Magdy0/ForgeDriveHW/ForgeX/HBM_G0VH4C5/revA/Doc/simulation/STFH24N60M2.asc

L1: ind; 5n; Cpar=10p
L2: ind; 3n; Cpar=10p
M1: nmos; STFH24N60M2
Named nets: D, G, S
Lead Inductances added are package inductance estimations
.model STFH24N60M2 VDMOS(Rg=7 
+Vto=3
+Rd=80m
+Rs=75m
+Kp=14.5
+Lambda=0.15
+Cgs=1058p
+Cgdmin=2.2p
+Cgdmax=2000p
+Cjo=50p
+A=1.5
+Rb=10m
+Is=1e-14
+N=0.85
+Vj=0.75
+M=0.5
+Fc=0.5
+TT=300n
+BV=600
+Qg=29n
+Ron=0.19)
