Omar-Magdy0/ForgeDriveHW/ForgeX/RJ45CANOpenDaisyChain_G0S2/RJ45CANOpenDaisyChain_G0S2.kicad_pcb

## KiCad design ForgeX/RJ45CANOpenDaisyChain_G0S2/RJ45CANOpenDaisyChain_G0S2.kicad_pcb (2026-09-06)

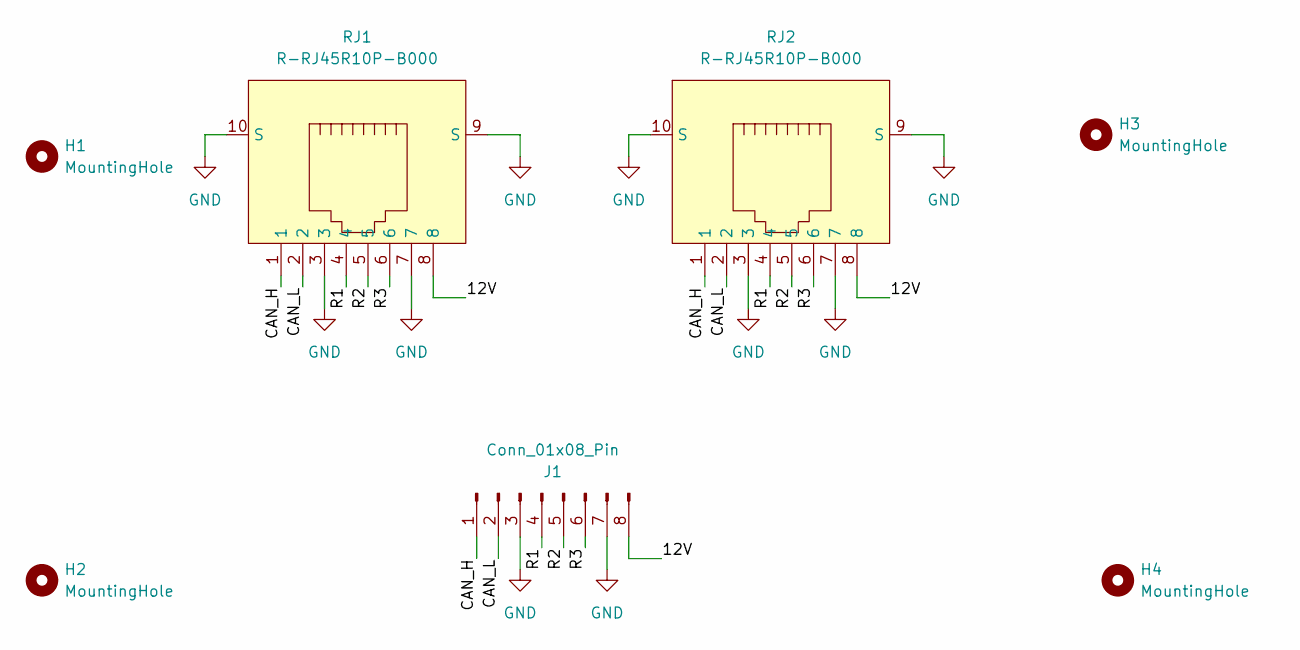
[picture p57: schematic RJ45CANOpenDaisyChain_G0S2.kicad_sch]

Parts:
H1, H2, H3, H4: MountingHole; MountingHole_3.2mm_M3_DIN965_Pad_TopBottom
J1: Conn_01x08_Pin; P2.54_WirePad_Header
RJ1, RJ2: R-RJ45R10P-B000; RJ45-TH_R-RJ45R10P-B000; MPN R-RJ45R10P-B000; LCSC Part C386758

Connections:
/12V: J1.8, RJ1.8, RJ2.8
/CAN_H: J1.1, RJ1.1, RJ2.1
/CAN_L: J1.2, RJ1.2, RJ2.2
/R1: J1.4, RJ1.4, RJ2.4
/R2: J1.5, RJ1.5, RJ2.5
/R3: J1.6, RJ1.6, RJ2.6
GND: J1.3, J1.7, RJ1.3, RJ1.7, RJ1.9 (S), RJ1.10 (S), RJ2.3, RJ2.7, RJ2.9 (S), RJ2.10 (S)

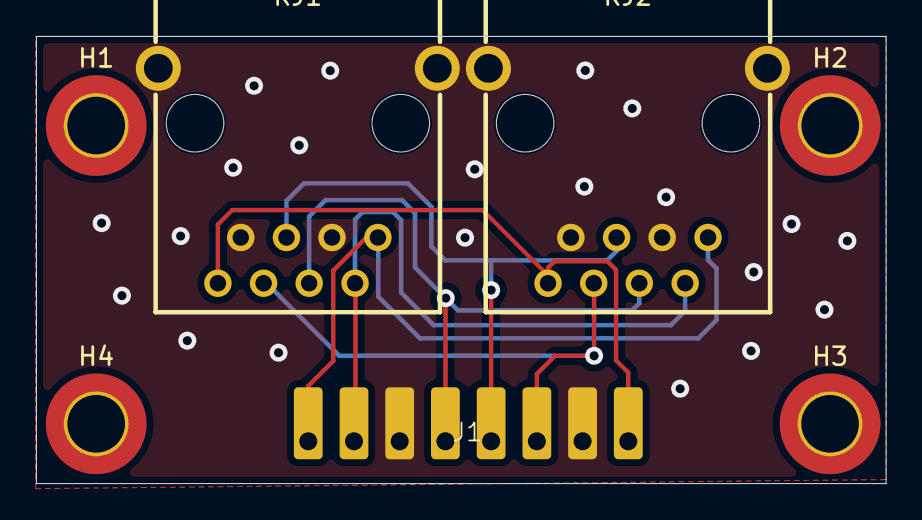
[picture p58: board RJ45CANOpenDaisyChain_G0S2.kicad_pcb from above]

Board: 2 copper layers, 47.2 x 24.8 mm, 7 parts (0 on the bottom side), 7 nets.
