Omar-Magdy0/ForgeDriveHW/ForgeX/PSU_G0V48P15R/revA/PSU_G0V48P15R.kicad_pcb

## KiCad design ForgeX/PSU_G0V48P15R/revA/PSU_G0V48P15R.kicad_pcb (2026-09-05)

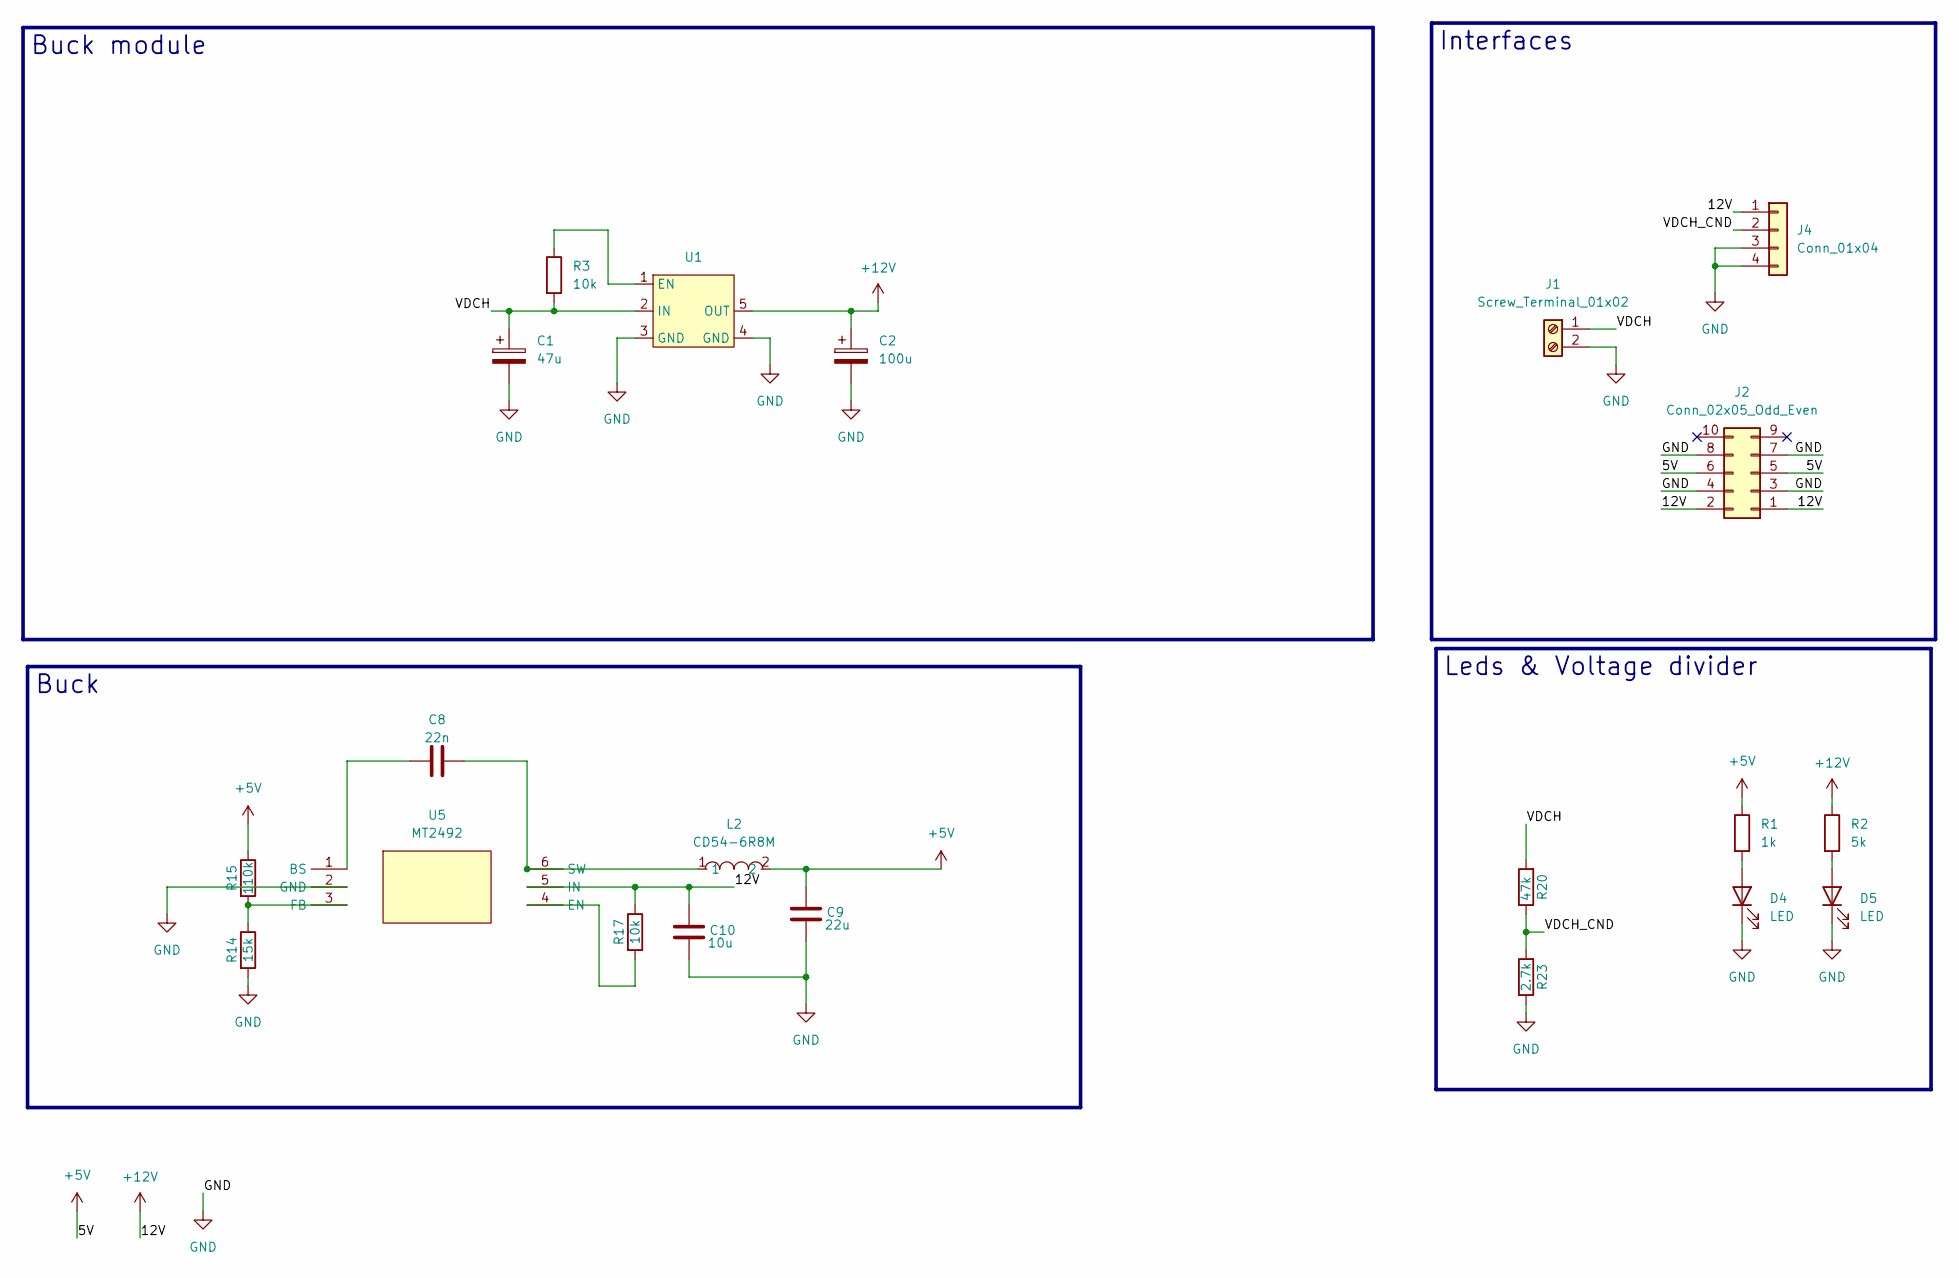
[picture p59: schematic PSU_G0V48P15R.kicad_sch]

Parts:
C1: 47u; CP_Radial_D10.0mm_P3.50mm
C2: 100u; CP_Radial_D10.0mm_P3.50mm
C8: 22n; C_0603_1608Metric_Pad1.08x0.95mm_HandSolder
C9: 22u; C_1206_3216Metric_Pad1.33x1.80mm_HandSolder
C10: 10u; C_1206_3216Metric_Pad1.33x1.80mm_HandSolder
D4, D5: LED; LED_1206_3216Metric_Pad1.42x1.75mm_HandSolder
J1: Screw_Terminal_01x02; SPACER_M3_PCONN_PSU
J2: Conn_02x05_Odd_Even; PinHeader_2x05_P2.54mm_Vertical
J4: Conn_01x04; JST_XH_B4B-XH-A_1x04_P2.50mm_Vertical
L2: CD54-6R8M; IND-SMD_L5.8-W5.2_CD54; MPN CD54-6R8M; LCSC Part C7588992
R1: 1k; R_1206_3216Metric_Pad1.30x1.75mm_HandSolder
R2: 5k; R_1206_3216Metric_Pad1.30x1.75mm_HandSolder
R3: 10k; R_1206_3216Metric_Pad1.30x1.75mm_HandSolder
R14: 15k; R_0603_1608Metric_Pad0.98x0.95mm_HandSolder
R15: 110k; R_0603_1608Metric_Pad0.98x0.95mm_HandSolder
R17: 10k; R_0603_1608Metric_Pad0.98x0.95mm_HandSolder
R20: 47k; R_1206_3216Metric_Pad1.30x1.75mm_HandSolder
R23: 2.7k; R_1206_3216Metric_Pad1.30x1.75mm_HandSolder
U1: HW-788abcd
U5: MT2492; SOT-23-6_L2.9-W1.6-P0.95-LS2.8-BL_3; MPN MT2492; LCSC Part C89358

Connections:
+5V: C9.1, J2.5, J2.6, L2.2, R1.1, R15.1
+12V: C2.1, C10.1, J2.1, J2.2, J4.1, R2.1, R17.1, U1.5 (OUT), U5.5 (IN)
/VDCH: C1.1, J1.1, R3.2, R20.2, U1.2 (IN)
/VDCH_CND: J4.2, R20.1, R23.2
GND: C1.2, C2.2, C9.2, C10.2, D4.1 (K), D5.1 (K), J1.2, J2.3, J2.4, J2.7, J2.8, J4.3, J4.4, R14.2, R23.1, U1.3 (GND), U1.4 (GND), U5.2 (GND)
unnamed: D4.2 (A), R1.2
unnamed: D5.2 (A), R2.2
unnamed: R3.1, U1.1 (EN)
unnamed: C8.2, U5.1 (BS)
unnamed: R17.2, U5.4 (EN)
unnamed: R14.1, R15.2, U5.3 (FB)
unnamed: C8.1, L2.1, U5.6 (SW)

Notes on the sheet:
Buck module
Buck
Interfaces
Leds & Voltage divider

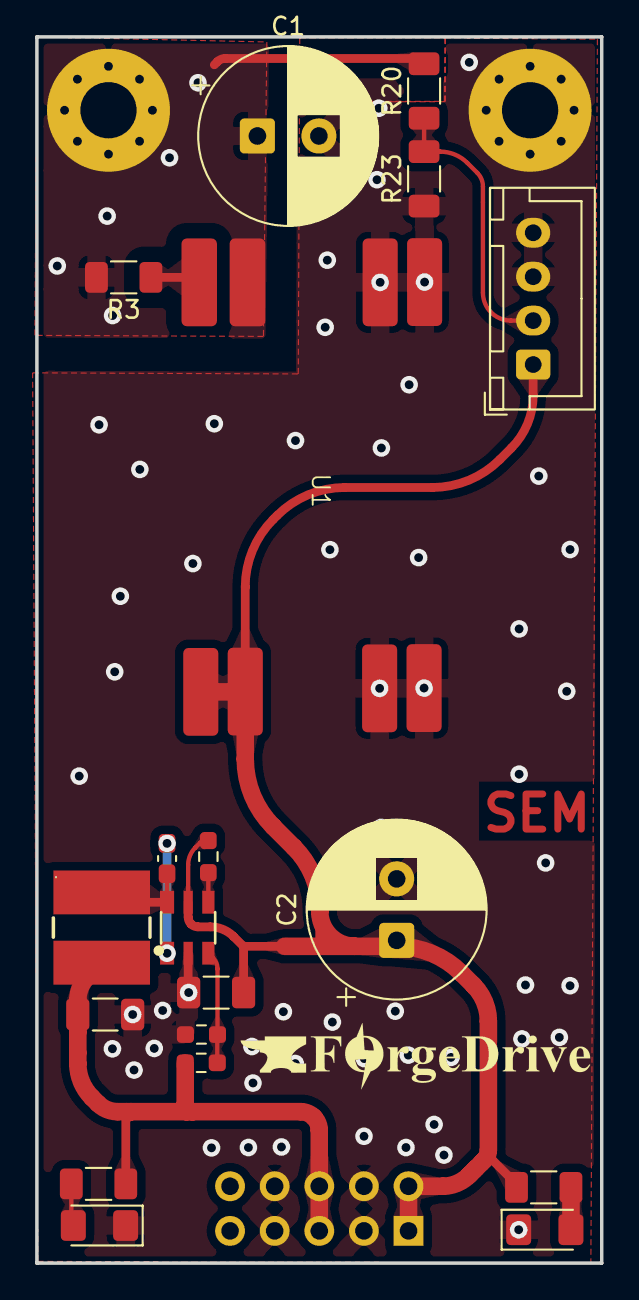
[picture p60: board PSU_G0V48P15R.kicad_pcb from above]

Board: 2 copper layers, 32.1 x 69.8 mm, 21 parts (1 on the bottom side), 12 nets.
