Omar-Magdy0/ForgeDriveHW/ForgeX/PMB_G0S4V80B/revA/PMB_G0S4V80B.kicad_pcb

## KiCad design ForgeX/PMB_G0S4V80B/revA/PMB_G0S4V80B.kicad_pcb (2026-09-05)

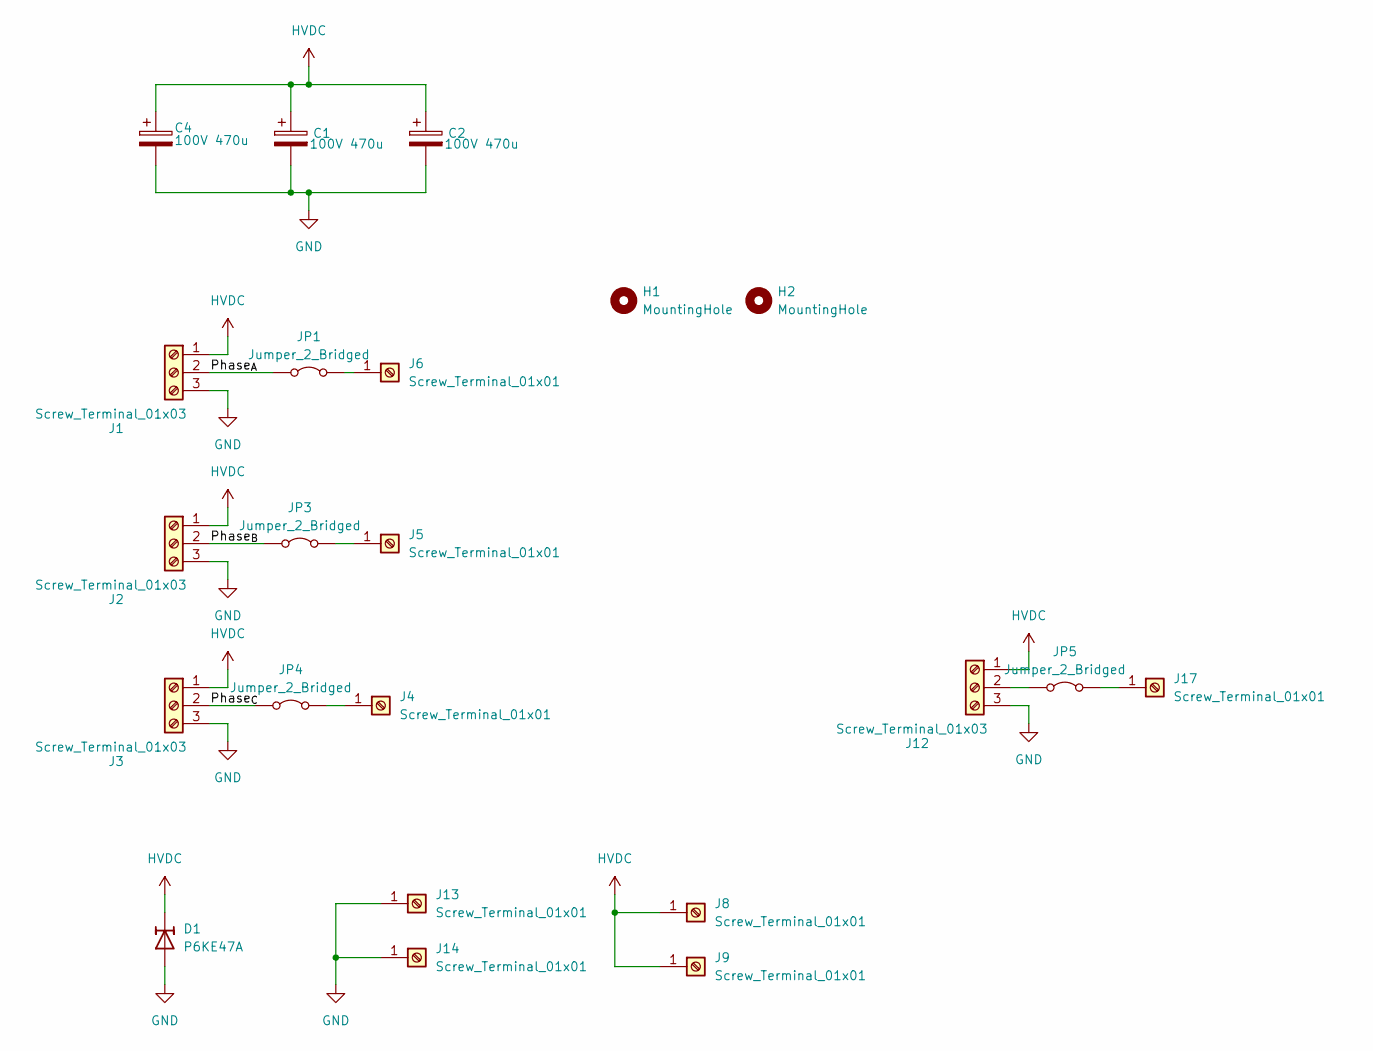
[picture p61: schematic PMB_G0S4V80B.kicad_sch]

Parts:
C1, C2, C4: 100V 470u; CP_Radial_D18.0mm_P7.50mm
D1: P6KE47A; D_DO-15_P10.16mm_Horizontal
H1, H2: MountingHole; MountingHole_5.3mm_M5_DIN965
J1, J2, J3, J12: Screw_Terminal_01x03; SPACER_M3_PCONN_2x03
J4, J5, J6, J8, J9, J13, J14, J17: Screw_Terminal_01x01; M3_PCONN_1x01
JP1, JP3, JP4, JP5: Jumper_2_Bridged; PowerJumper_PMB

Connections:
/Phase_{A}: J1.2, JP1.1 (A)
/Phase_{B}: J2.2, JP3.1 (A)
/Phase_{C}: J3.2, JP4.1 (A)
GND: C1.2, C2.2, C4.2, D1.2 (A), J1.3, J2.3, J3.3, J12.3, J13.1 (Pin_1_1), J14.1 (Pin_1_1)
HVDC: C1.1, C2.1, C4.1, D1.1 (K), J1.1, J2.1, J3.1, J8.1 (Pin_1_1), J9.1 (Pin_1_1), J12.1
unnamed: J4.1 (Pin_1_1), JP4.2 (B)
unnamed: J5.1 (Pin_1_1), JP3.2 (B)
unnamed: J6.1 (Pin_1_1), JP1.2 (B)
unnamed: J12.2, JP5.1 (A)
unnamed: J17.1 (Pin_1_1), JP5.2 (B)

Board: 2 copper layers, 22 parts (0 on the bottom side), 10 nets, no tracks yet.
