Omar-Magdy0/ForgeDriveHW/ForgeX/LVP_G0S4B/revA/LVP_G0S4B.kicad_pcb

## KiCad design ForgeX/LVP_G0S4B/revA/LVP_G0S4B.kicad_pcb (2026-09-03)

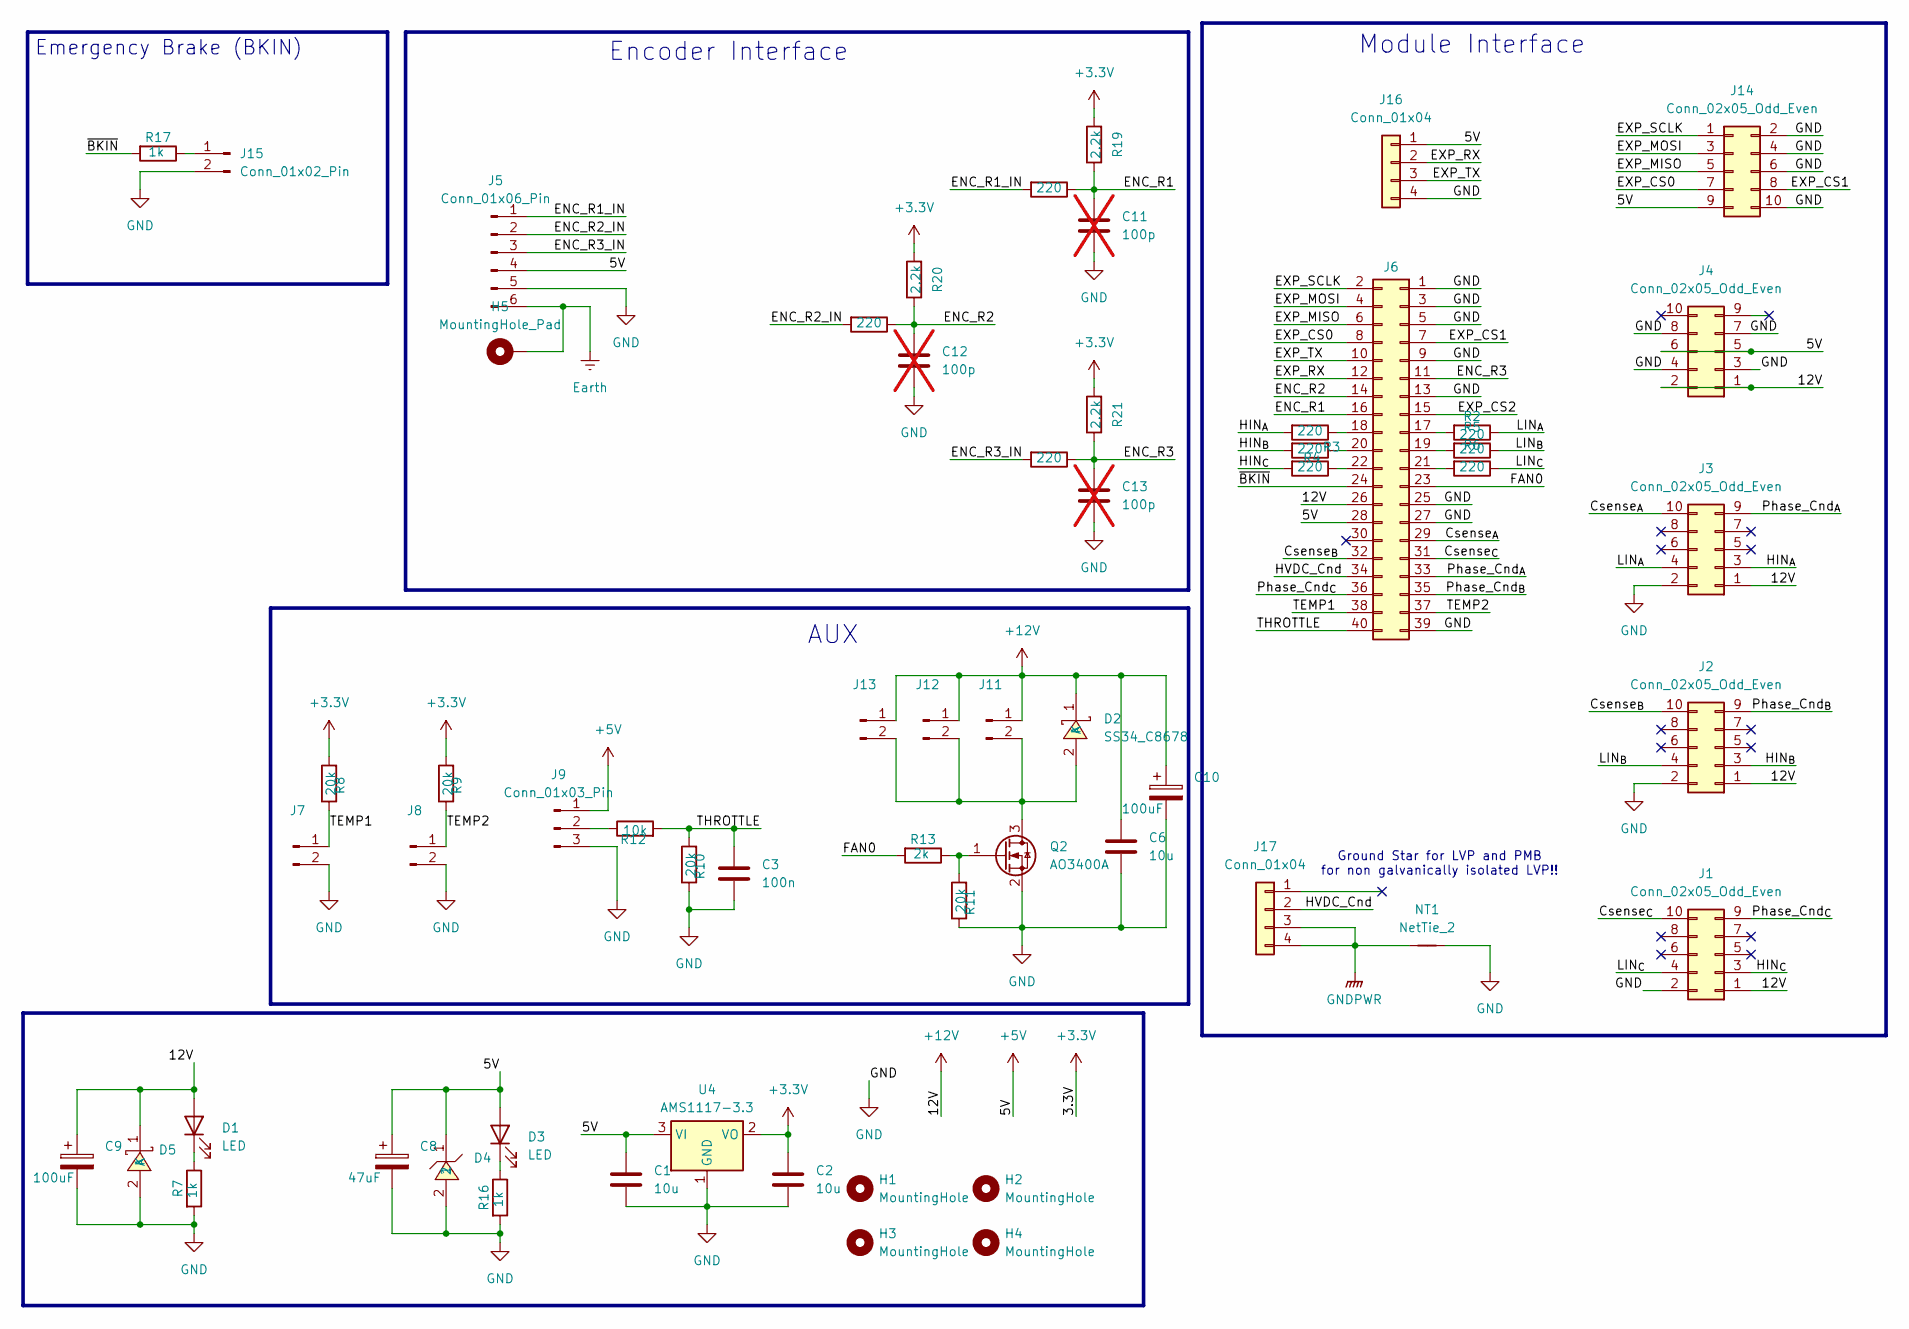
[picture p62: schematic LVP_G0S4B.kicad_sch]

Parts:
C1, C2, C6: 10u; C_1206_3216Metric_Pad1.33x1.80mm_HandSolder
C3: 100n; C_0603_1608Metric_Pad1.08x0.95mm_HandSolder
C8: 47uF; CP_Elec_5x5.4
C9, C10: 100uF; CP_Elec_8x6.5
C11, C12, C13: 100p; C_0603_1608Metric_Pad1.08x0.95mm_HandSolder; not fitted
D1, D3: LED; LED_0603_1608Metric
D2: SS34_C8678; SMA_L4.3-W2.6-LS5.2-RD; MPN SS34; LCSC Part C8678
D4: SMBJ5.0A_C83333; SMB_L4.6-W3.6-LS5.3-RD; MPN SMBJ5.0A; LCSC Part C83333
D5: SMBJ12A_C151251; SMB_L4.6-W3.6-LS5.3-RD; MPN SMBJ12A; LCSC Part C151251
H1, H2, H3, H4: MountingHole; MountingHole_3.2mm_M3_DIN965
H5: MountingHole_Pad; MountingHole_3.2mm_M3_Pad_Via
J1, J2, J3, J4: Conn_02x05_Odd_Even; PinSocket_2x05_P2.54mm_Vertical
J5: Conn_01x06_Pin; JST_XH_B6B-XH-A_1x06_P2.50mm_Vertical
J6: Conn_02x20_Odd_Even; PinSocket_2x20_P2.54mm_Vertical
J7, J8, J11, J12, J13, J15: Conn_01x02_Pin; JST_XH_B2B-XH-A_1x02_P2.50mm_Vertical
J9: Conn_01x03_Pin; JST_XH_B3B-XH-A_1x03_P2.50mm_Vertical
J14: Conn_02x05_Odd_Even; IDC-Header_2x05_P2.54mm_Vertical
J16: Conn_01x04; PinSocket_1x04_P2.54mm_Vertical
J17: Conn_01x04; JST_XH_B4B-XH-A_1x04_P2.50mm_Vertical
NT1: NetTie_2; ground_tie
Q2: AO3400A; SOT-23
R1, R2, R3, R4, R5, R6, R14, R15, R18: 220; R_0603_1608Metric_Pad0.98x0.95mm_HandSolder
R7, R16, R17: 1k; R_0603_1608Metric_Pad0.98x0.95mm_HandSolder
R8, R9, R11: 20k; R_1206_3216Metric_Pad1.30x1.75mm_HandSolder
R10: 20k; R_0603_1608Metric_Pad0.98x0.95mm_HandSolder
R12: 10k; R_0603_1608Metric_Pad0.98x0.95mm_HandSolder
R13: 2k; R_1206_3216Metric_Pad1.30x1.75mm_HandSolder
R19, R20, R21: 2.2k; R_0603_1608Metric_Pad0.98x0.95mm_HandSolder
U4: AMS1117-3.3; SOT-89-3

Connections:
+3.3V: C2.1, R8.2, R9.2, R19.2, R20.2, R21.2, U4.2 (VO)
+5V: C1.1, C8.1, D3.2 (A), D4.1, J4.5, J4.6, J5.4, J6.28, J9.1, J14.9, J16.1, U4.3 (VI)
+12V: C6.1, C9.1, C10.1, D1.2 (A), D2.1 (K), D5.1 (K), J1.1, J2.1, J3.1, J4.1, J4.2, J6.26, J11.1, J12.1, J13.1
/Csense_{A}: J3.10, J6.29
/Csense_{B}: J2.10, J6.32
/Csense_{C}: J1.10, J6.31
/ENC_R1: C11.1, J6.16, R14.1, R19.1
/ENC_R1_IN: J5.1, R14.2
/ENC_R2: C12.1, J6.14, R15.1, R20.1
/ENC_R2_IN: J5.2, R15.2
/ENC_R3: C13.1, J6.11, R18.1, R21.1
/ENC_R3_IN: J5.3, R18.2
/EXP_CS0: J6.8, J14.7
/EXP_CS1: J6.7, J14.8
/EXP_CS2: J6.15
/EXP_MISO: J6.6, J14.5
/EXP_MOSI: J6.4, J14.3
/EXP_RX: J6.12, J16.2
/EXP_SCLK: J6.2, J14.1
/EXP_TX: J6.10, J16.3
/FAN0: J6.23, R13.2
/HIN_{A}: J3.3, R1.2
/HIN_{B}: J2.3, R3.2
/HIN_{C}: J1.3, R4.2
/HVDC_Cnd: J6.34, J17.2
/LIN_{A}: J3.4, R2.1
/LIN_{B}: J2.4, R5.1
/LIN_{C}: J1.4, R6.1
/Phase_Cnd_{A}: J3.9, J6.33
/Phase_Cnd_{B}: J2.9, J6.35
/Phase_Cnd_{C}: J1.9, J6.36
/TEMP1: J6.38, J7.1, R8.1
/TEMP2: J6.37, J8.1, R9.1
/THROTTLE: C3.1, J6.40, R10.2, R12.2
/~BKIN: J6.24, R17.2
Earth: H5.1 (1_1), J5.6
GND: C1.2, C2.2, C3.2, C6.2, C8.2, C9.2, C10.2, C11.2, C12.2, C13.2, D4.2, D5.2 (A), J1.2, J2.2, J3.2, J4.3, J4.4, J4.7, J4.8, J5.5, J6.1, J6.3, J6.5, J6.9, J6.13, J6.25, J6.27, J6.39, J7.2, J8.2, J9.3, J14.2, J14.4, J14.6, J14.10, J15.2, J16.4, NT1.2, Q2.2 (S), R7.2, R10.1, R11.1, R16.2, U4.1 (GND)
GNDPWR: J17.3, J17.4, NT1.1
unnamed: D1.1 (K), R7.1
unnamed: D2.2 (A), J11.2, J12.2, J13.2, Q2.3 (D)
unnamed: D3.1 (K), R16.1
unnamed: J6.17, R2.2
unnamed: J6.18, R1.1
unnamed: J6.19, R5.2
unnamed: J6.20, R3.1
unnamed: J6.21, R6.2
unnamed: J6.22, R4.1
unnamed: J9.2, R12.1
unnamed: J15.1, R17.1
unnamed: Q2.1 (G), R11.2, R13.1

Notes on the sheet:
Ground Star for LVP and PMB for non galvanically isolated LVP!!
AUX
Encoder Interface
Module Interface
Emergency Brake (BKIN)

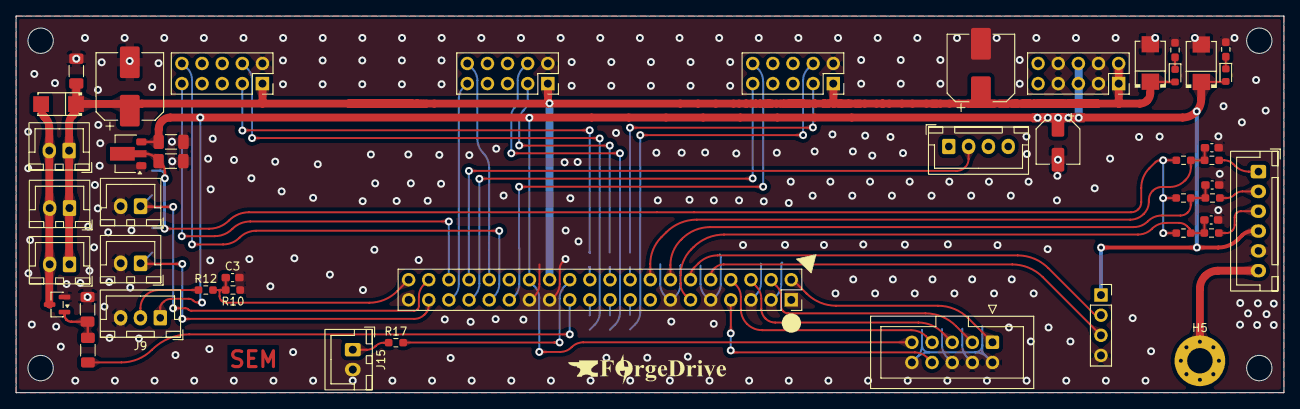
[picture p63: board LVP_G0S4B.kicad_pcb from above]

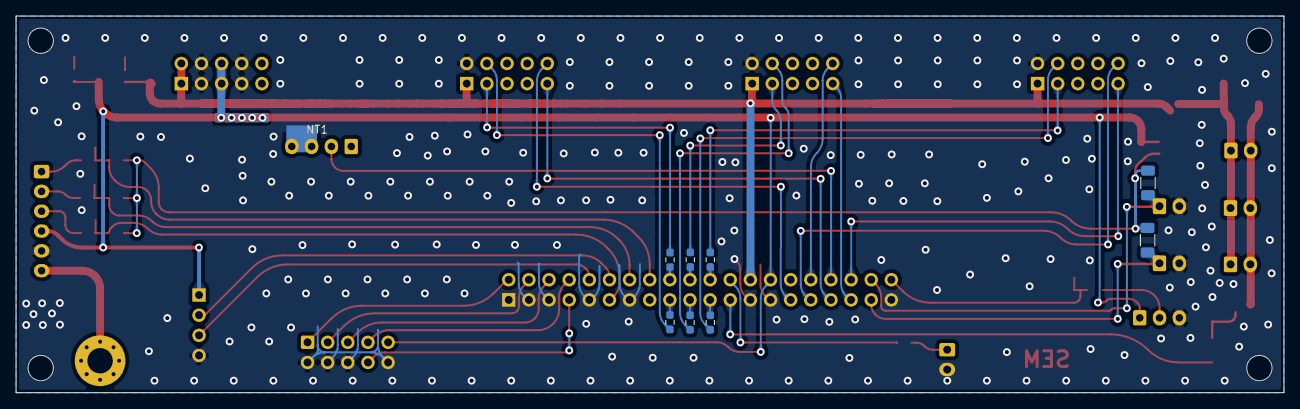
[picture p64: board LVP_G0S4B.kicad_pcb from below]

Board: 2 copper layers, 159.9 x 47.5 mm, 60 parts (9 on the bottom side), 49 nets.
