Omar-Magdy0/ForgeDriveHW/ForgeX/BlackDev_G0Basic/BlackDev_G0Basic.kicad_pcb

## KiCad design ForgeX/BlackDev_G0Basic/BlackDev_G0Basic.kicad_pcb (2026-09-02)

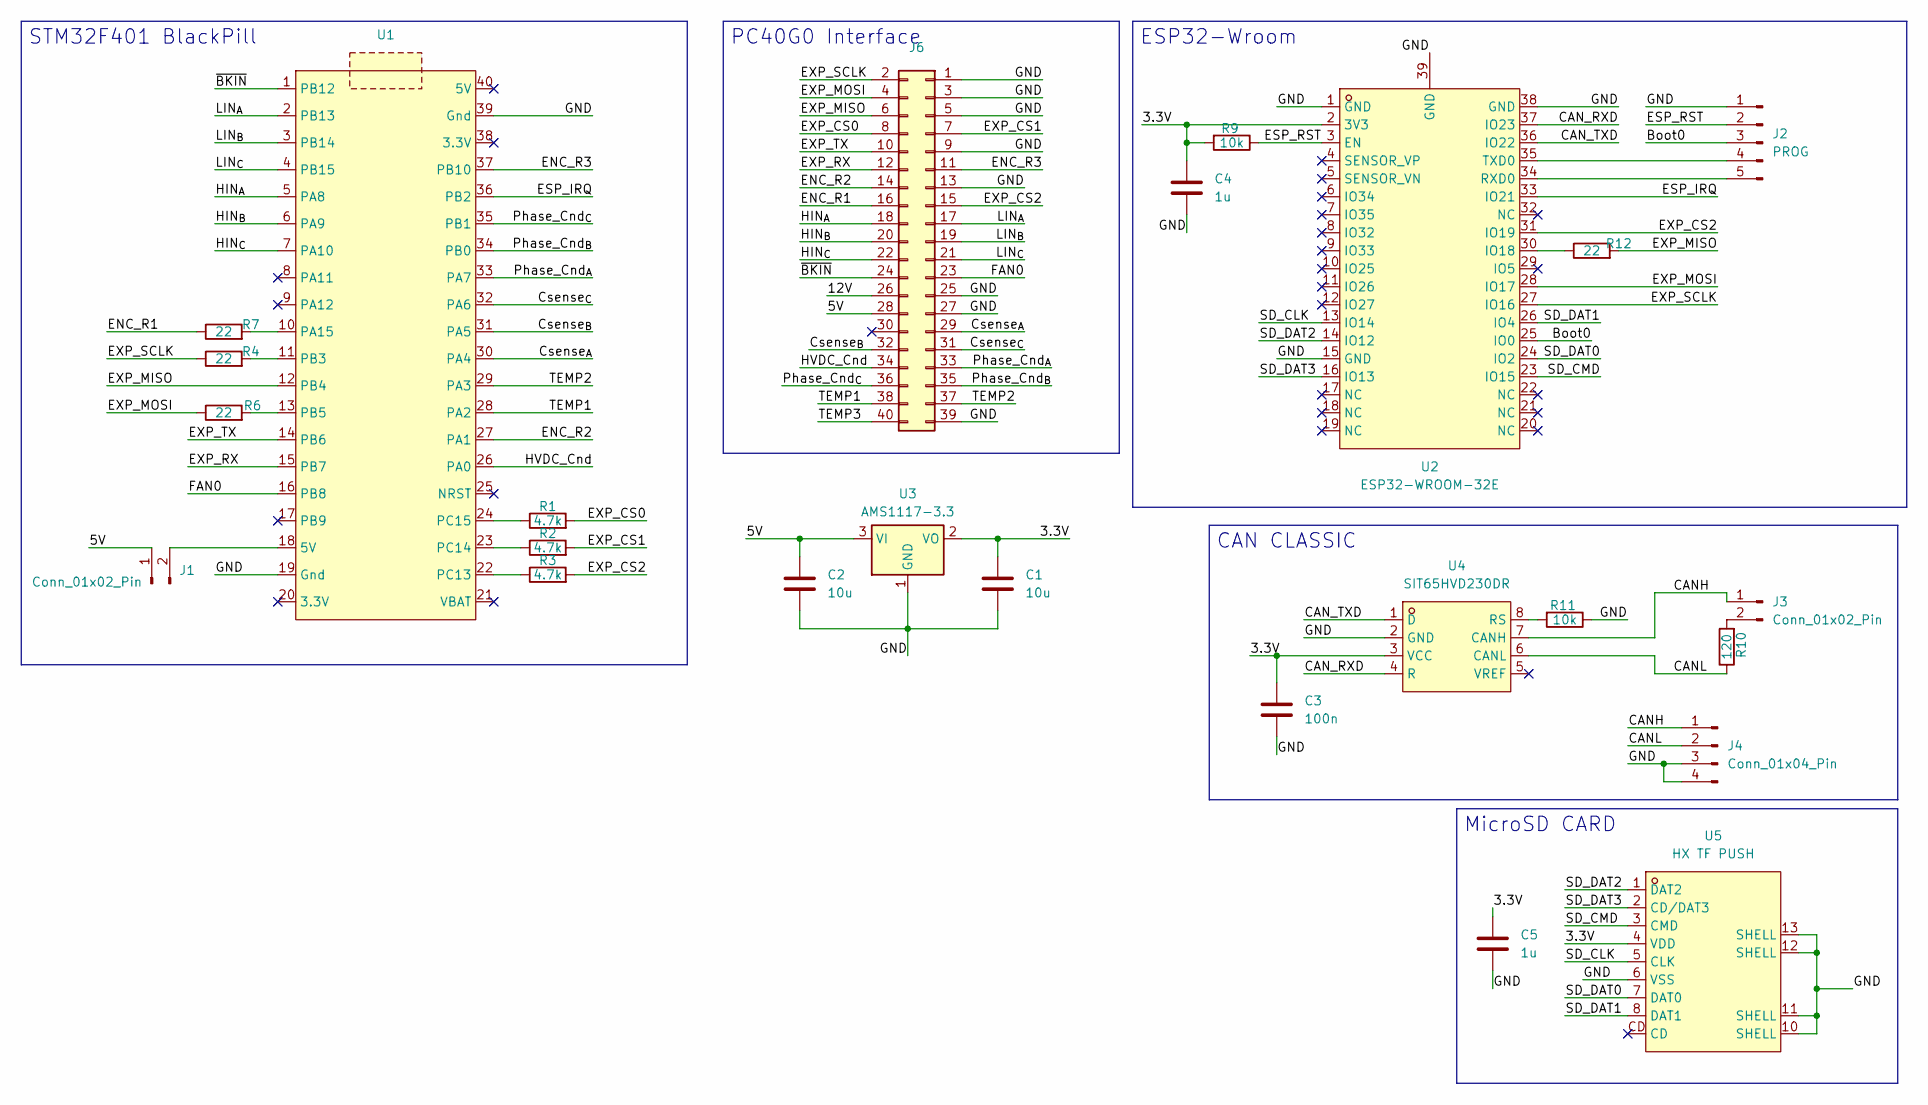
[picture p65: schematic BlackDev_G0Basic.kicad_sch]

Parts:
C1, C2: 10u; C_1206_3216Metric_Pad1.33x1.80mm_HandSolder
C3: 100n; C_0603_1608Metric_Pad1.08x0.95mm_HandSolder
C4, C5: 1u; C_0603_1608Metric_Pad1.08x0.95mm_HandSolder
J1: Conn_01x02_Pin; PinHeader_1x02_P2.54mm_Vertical_SMD_Pin1Right
J2: PROG; PinHeader_1x05_P2.54mm_Vertical_SMD_Pin1Left
J3: Conn_01x02_Pin; PinHeader_1x02_P2.54mm_Vertical
J4: Conn_01x04_Pin; JST_XH_B4B-XH-A_1x04_P2.50mm_Vertical
J6: Conn_02x20_Odd_Even; PinHeader_2x20_P2.54mm_Vertical
R1, R2, R3: 4.7k; R_0603_1608Metric_Pad0.98x0.95mm_HandSolder
R4, R6, R7, R12: 22; R_0603_1608Metric_Pad0.98x0.95mm_HandSolder
R9, R11: 10k; C_0603_1608Metric_Pad1.08x0.95mm_HandSolder
R10: 120; R_1206_3216Metric_Pad1.30x1.75mm_HandSolder
U1: Stm32BlackPill
U2: ESP32-WROOM-32E; WIFI-SMD_ESP32-WROOM-32E; MPN ESP32-WROOM-32E-N4; LCSC Part C701341
U3: AMS1117-3.3; SOT-223-3_TabPin2
U4: SIT65HVD230DR; SOP-8_L4.9-W3.9-P1.27-LS6.0-BL; MPN SIT65HVD230DR; LCSC Part C496619
U5: HX TF PUSH; TF-SMD_TF-PUSH; MPN HX TF PUSH; LCSC Part C5184837

Connections:
/3.3V: C1.1, C3.1, C4.1, C5.1, R9.2, U2.2 (3V3), U3.2 (VO), U4.3 (VCC), U5.4 (VDD)
/5V: C2.1, J1.1, J6.28, U3.3 (VI)
/12V: J6.26
/Boot0: J2.3, U2.25 (IO0)
/CANH: J3.1, J4.1, U4.7 (CANH)
/CANL: J4.2, R10.1, U4.6 (CANL)
/CAN_RXD: U2.37 (IO23), U4.4 (R)
/CAN_TXD: U2.36 (IO22), U4.1 (D)
/Csense_{A}: J6.29, U1.30 (PA4)
/Csense_{B}: J6.32, U1.31 (PA5)
/Csense_{C}: J6.31, U1.32 (PA6)
/ENC_R1: J6.16, R7.1
/ENC_R2: J6.14, U1.27 (PA1)
/ENC_R3: J6.11, U1.37 (PB10)
/ESP_IRQ: U1.36 (PB2), U2.33 (IO21)
/ESP_RST: J2.2, R9.1, U2.3 (EN)
/EXP_CS0: J6.8, R1.2
/EXP_CS1: J6.7, R2.2
/EXP_CS2: J6.15, R3.2, U2.31 (IO19)
/EXP_MISO: J6.6, R12.2, U1.12 (PB4)
/EXP_MOSI: J6.4, R6.1, U2.28 (IO17)
/EXP_RX: J6.12, U1.15 (PB7)
/EXP_SCLK: J6.2, R4.1, U2.27 (IO16)
/EXP_TX: J6.10, U1.14 (PB6)
/FAN0: J6.23, U1.16 (PB8)
/GND: C1.2, C2.2, C3.2, C4.2, C5.2, J2.1, J4.3, J4.4, J6.1, J6.3, J6.5, J6.9, J6.13, J6.25, J6.27, J6.39, R11.1, U1.19 (Gnd), U1.39 (Gnd), U2.1 (GND), U2.15 (GND), U2.38 (GND), U2.39 (GND), U3.1 (GND), U4.2 (GND), U5.6 (VSS), U5.10 (SHELL), U5.11 (SHELL), U5.12 (SHELL), U5.13 (SHELL)
/HIN_{A}: J6.18, U1.5 (PA8)
/HIN_{B}: J6.20, U1.6 (PA9)
/HIN_{C}: J6.22, U1.7 (PA10)
/HVDC_Cnd: J6.34, U1.26 (PA0)
/LIN_{A}: J6.17, U1.2 (PB13)
/LIN_{B}: J6.19, U1.3 (PB14)
/LIN_{C}: J6.21, U1.4 (PB15)
/Phase_Cnd_{A}: J6.33, U1.33 (PA7)
/Phase_Cnd_{B}: J6.35, U1.34 (PB0)
/Phase_Cnd_{C}: J6.36, U1.35 (PB1)
/SD_CLK: U2.13 (IO14), U5.5 (CLK)
/SD_CMD: U2.23 (IO15), U5.3 (CMD)
/SD_DAT0: U2.24 (IO2), U5.7 (DAT0)
/SD_DAT1: U2.26 (IO4), U5.8 (DAT1)
/SD_DAT2: U2.14 (IO12), U5.1 (DAT2)
/SD_DAT3: U2.16 (IO13), U5.2 (CD/DAT3)
/TEMP1: J6.38, U1.28 (PA2)
/TEMP2: J6.37, U1.29 (PA3)
/TEMP3: J6.40
/~BKIN: J6.24, U1.1 (PB12)
unnamed: J1.2, U1.18 (5V)
unnamed: J2.4, U2.35 (TXD0)
unnamed: J2.5, U2.34 (RXD0)
unnamed: J3.2, R10.2
unnamed: R7.2, U1.10 (PA15)
unnamed: R4.2, U1.11 (PB3)
unnamed: R6.2, U1.13 (PB5)
unnamed: R3.1, U1.22 (PC13)
unnamed: R2.1, U1.23 (PC14)
unnamed: R1.1, U1.24 (PC15)
unnamed: R12.1, U2.30 (IO18)
unnamed: R11.2, U4.8 (RS)

Notes on the sheet:
PC40G0 Interface
STM32F401 BlackPill
ESP32-Wroom
MicroSD CARD
CAN CLASSIC

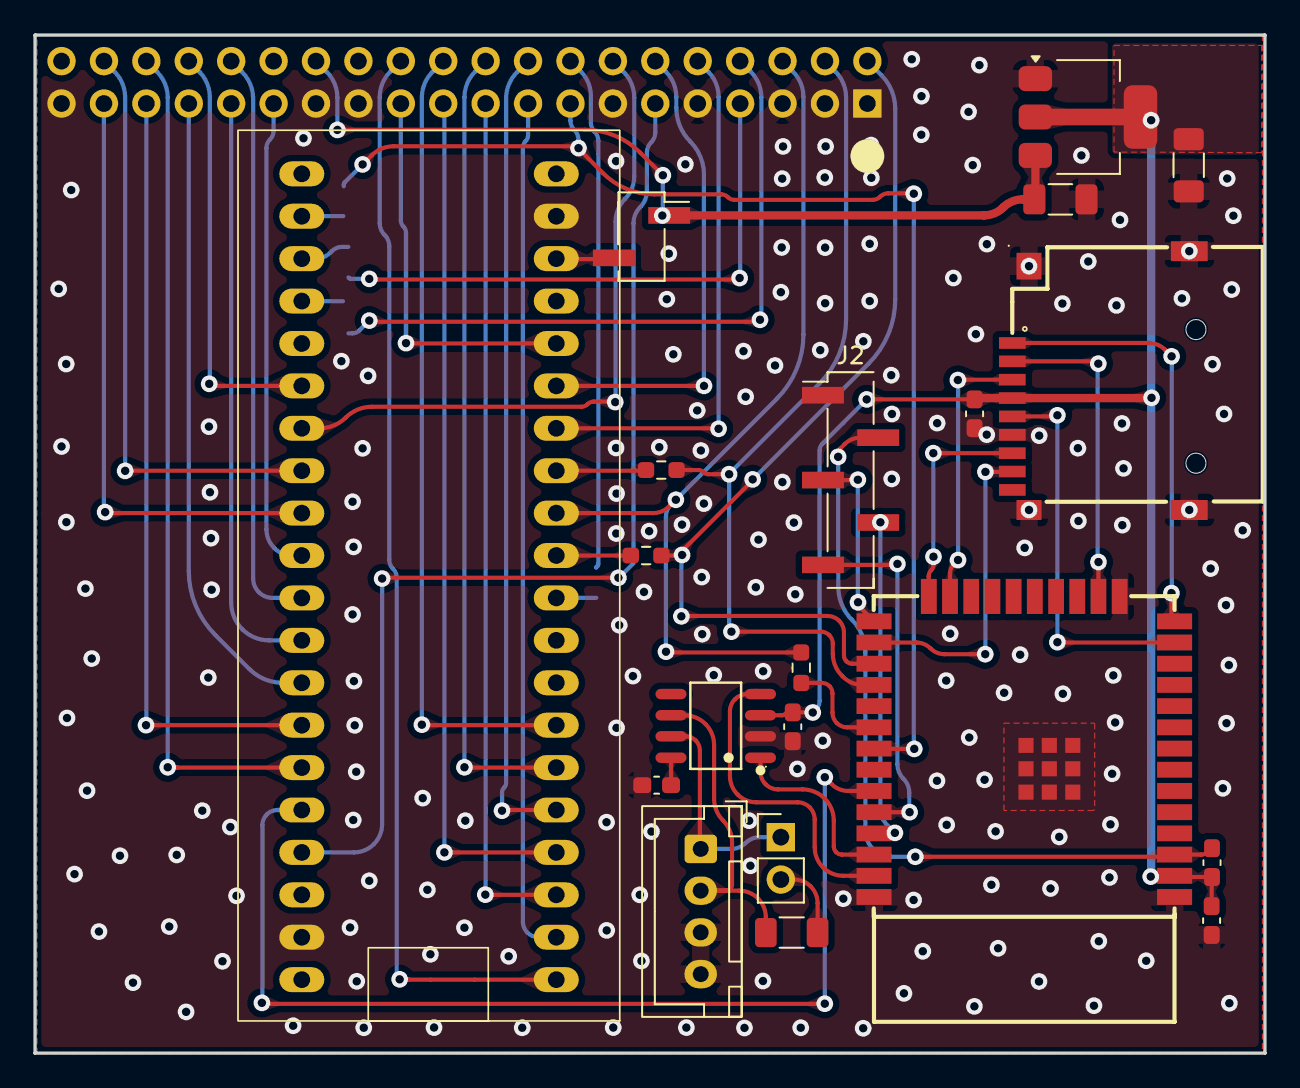
[picture p66: board BlackDev_G0Basic.kicad_pcb from above]

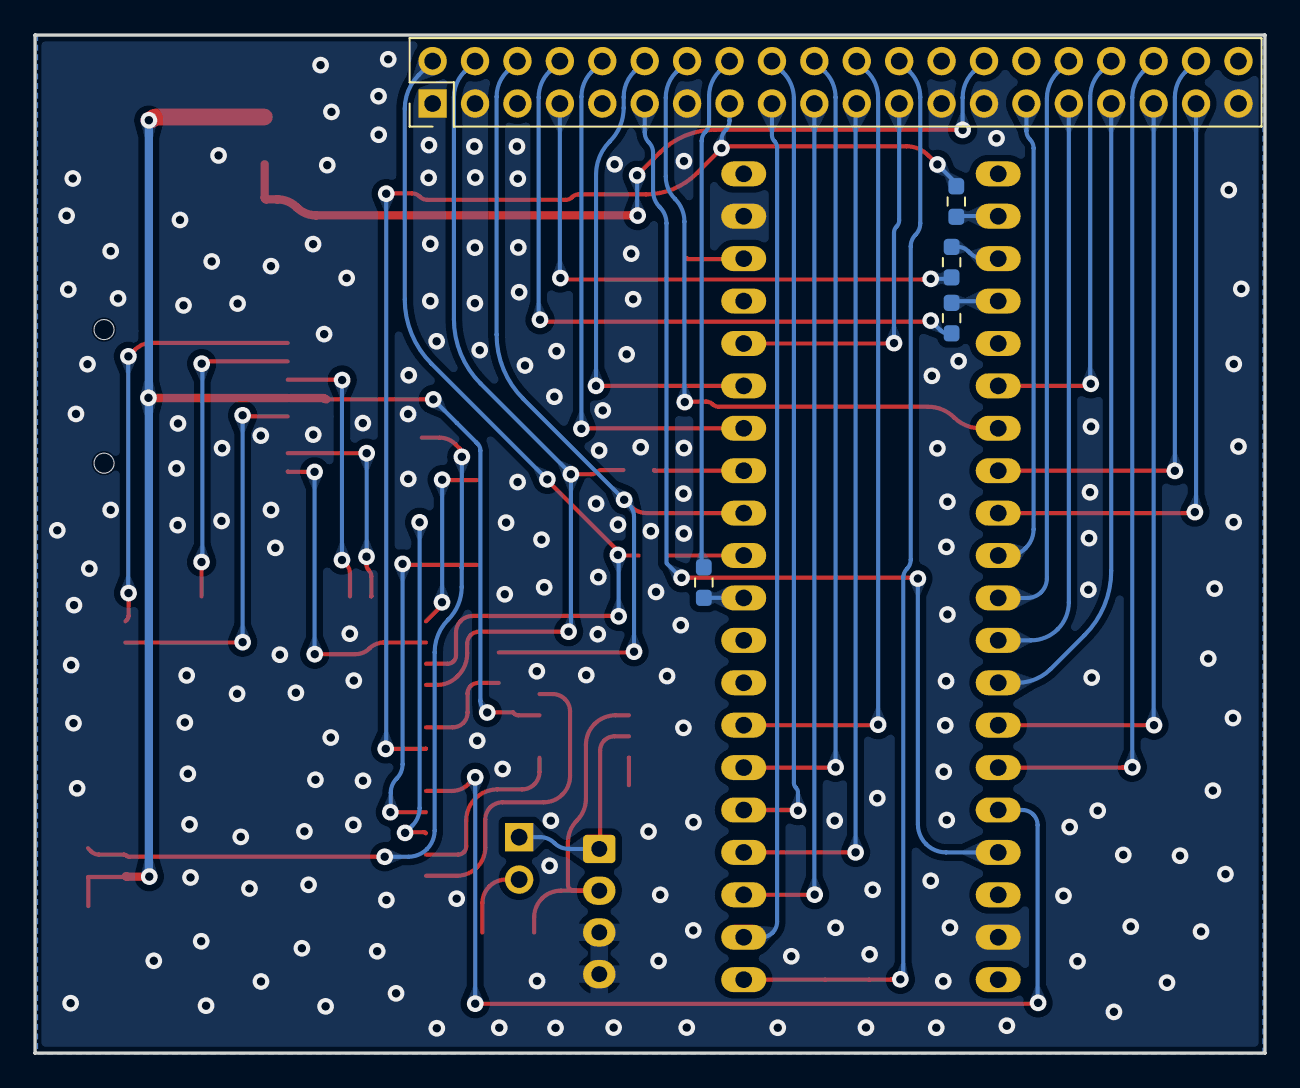
[picture p67: board BlackDev_G0Basic.kicad_pcb from below]

Board: 2 copper layers, 73.7 x 61.0 mm, 25 parts (5 on the bottom side), 56 nets.
