Omar-Magdy0/ForgeDriveHW/ForgeX/PSU_G0P20N/revA/PSU_G0P20N.kicad_pcb

## KiCad design ForgeX/PSU_G0P20N/revA/PSU_G0P20N.kicad_pcb (2026-08-24)

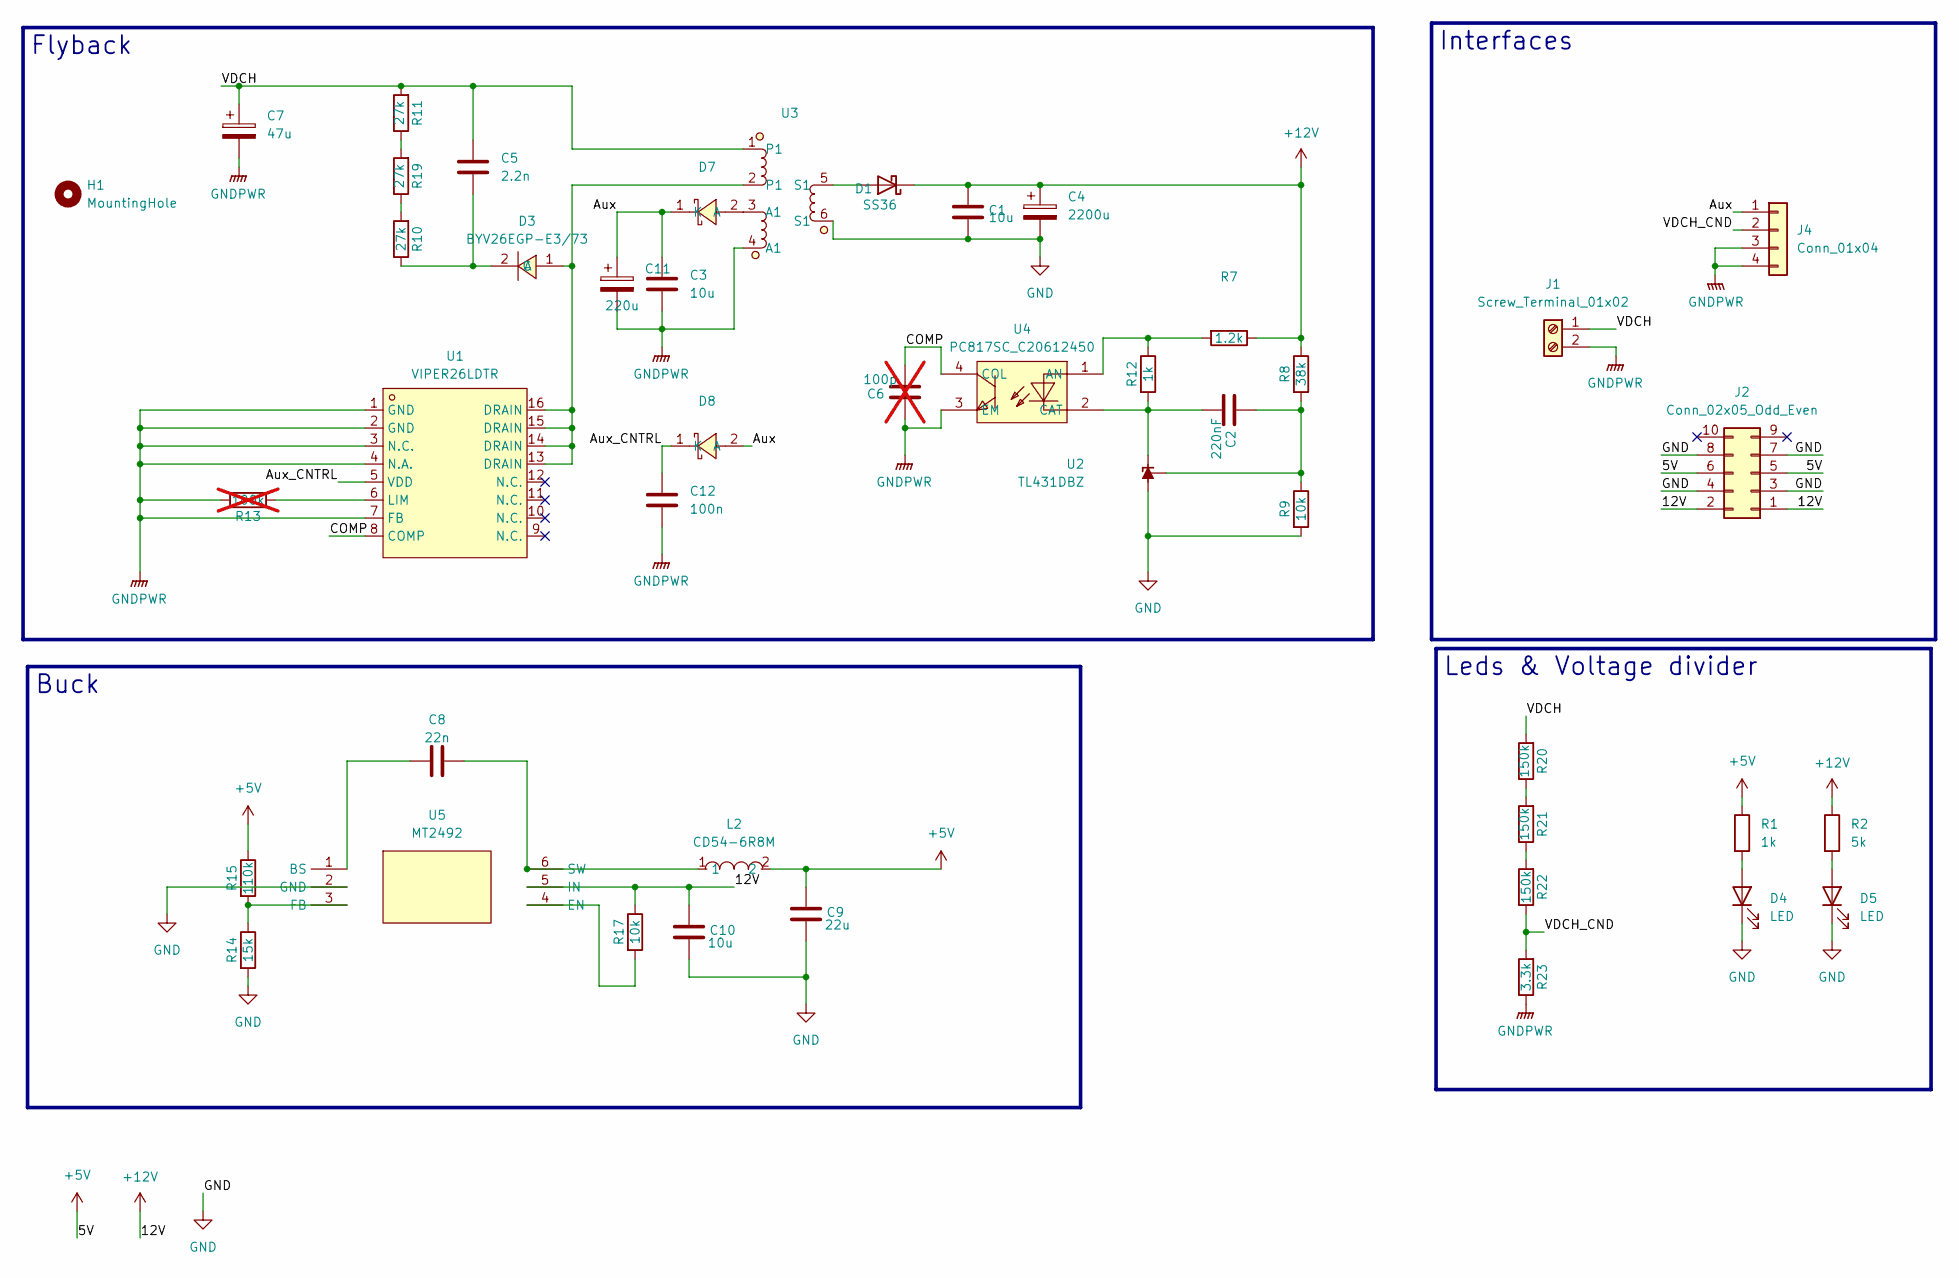
[picture p68: schematic PSU_G0P20N.kicad_sch]

Parts:
C1, C3, C10: 10u; C_1206_3216Metric_Pad1.33x1.80mm_HandSolder
C2: 220nF; C_0603_1608Metric_Pad1.08x0.95mm_HandSolder
C4: 2200u; CP_Radial_D10.0mm_P5.00mm
C5: 2.2n; C_Disc_D5.0mm_W2.5mm_P5.00mm
C6: 100p; C_0603_1608Metric_Pad1.08x0.95mm_HandSolder; not fitted
C7: 47u; CP_Radial_D10.0mm_P7.50mm
C8: 22n; C_0603_1608Metric_Pad1.08x0.95mm_HandSolder
C9: 22u; C_1206_3216Metric_Pad1.33x1.80mm_HandSolder
C11: 220u; CP_Radial_D6.3mm_P2.50mm
C12: 100n; C_0603_1608Metric_Pad1.08x0.95mm_HandSolder
D1: SS36; D_SMA
D3: BYV26EGP-E3/73; DO-15_BD3.1-L6.7-P10.70-D0.9-FD; MPN BYV26EGP-E3/73; LCSC Part C15074
D4, D5: LED; LED_1206_3216Metric_Pad1.42x1.75mm_HandSolder
D7, D8: SD103AWS_C5345966; SOD-323_L1.7-W1.3-LS2.5-RD; MPN SD103AWS; LCSC Part C5345966
H1: MountingHole; MountingHole_2.1mm
J1: Screw_Terminal_01x02; SPACER_M3_PCONN_PSU
J2: Conn_02x05_Odd_Even; PinHeader_2x05_P2.54mm_Vertical
J4: Conn_01x04; JST_XH_B4B-XH-A_1x04_P2.50mm_Vertical
L2: CD54-6R8M; IND-SMD_L5.8-W5.2_CD54; MPN CD54-6R8M; LCSC Part C7588992
R1: 1k; R_1206_3216Metric_Pad1.30x1.75mm_HandSolder
R2: 5k; R_1206_3216Metric_Pad1.30x1.75mm_HandSolder
R7: 1.2k; R_0603_1608Metric_Pad0.98x0.95mm_HandSolder
R8: 38k; R_0603_1608Metric_Pad0.98x0.95mm_HandSolder
R9, R17: 10k; R_0603_1608Metric_Pad0.98x0.95mm_HandSolder
R10, R11, R19: 27k; R_1206_3216Metric
R12: 1k; R_0603_1608Metric_Pad0.98x0.95mm_HandSolder
R13: 100k; R_0603_1608Metric_Pad0.98x0.95mm_HandSolder; not fitted
R14: 15k; R_0603_1608Metric_Pad0.98x0.95mm_HandSolder
R15: 110k; R_0603_1608Metric_Pad0.98x0.95mm_HandSolder
R20, R21, R22: 150k; R_1206_3216Metric
R23: 3.3k; R_0603_1608Metric_Pad0.98x0.95mm_HandSolder
U1: VIPER26LDTR; SOIC-16_L9.9-W3.9-P1.27-LS6.0-BL; MPN VIPER26LDTR; LCSC Part C134483
U2: TL431DBZ; SOT-23
U3: E22 Trans
U4: PC817SC_C20612450; OPTO-SMD-4_L4.6-W6.5-P2.54-LS10.3-TL; MPN PC817SC; LCSC Part C20612450
U5: MT2492; SOT-23-6_L2.9-W1.6-P0.95-LS2.8-BL_3; MPN MT2492; LCSC Part C89358

Connections:
+5V: C9.1, J2.5, J2.6, L2.2, R1.1, R15.1
+12V: C1.1, C4.1, C10.1, D1.1 (K), J2.1, J2.2, R2.1, R7.1, R8.1, R17.1, U5.5 (IN)
/Aux: C3.1, C11.1, D7.1 (K), D8.2 (A), J4.1
/Aux_CNTRL: C12.1, D8.1 (K), U1.5 (VDD)
/COMP: C6.2, U1.8 (COMP), U4.4 (COL)
/VDCH: C5.1, C7.1, J1.1, R11.2, R20.2, U3.1
/VDCH_CND: J4.2, R22.1, R23.2
GND: C1.2, C4.2, C9.2, C10.2, D4.1 (K), D5.1 (K), J2.3, J2.4, J2.7, J2.8, R9.2, R14.2, U2.3 (A), U3.6 (S1), U5.2 (GND)
GNDPWR: C3.2, C6.1, C7.2, C11.2, C12.2, J1.2, J4.3, J4.4, R13.1, R23.1, U1.1 (GND), U1.2 (GND), U1.3 (N.C.), U1.4 (N.A.), U1.7 (FB), U3.4 (A1), U4.3 (EM)
unnamed: D1.2 (A), U3.5 (S1)
unnamed: D3.1 (A), U1.13 (DRAIN), U1.14 (DRAIN), U1.15 (DRAIN), U1.16 (DRAIN), U3.2 (P1)
unnamed: C5.2, D3.2 (C), R10.1
unnamed: D4.2 (A), R1.2
unnamed: D5.2 (A), R2.2
unnamed: D7.2 (A), U3.3 (A1)
unnamed: R10.2, R19.1
unnamed: R11.1, R19.2
unnamed: R20.1, R21.2
unnamed: R21.1, R22.2
unnamed: R13.2, U1.6 (LIM)
unnamed: C2.2, R12.2, U2.1 (K), U4.2 (CAT)
unnamed: C2.1, R8.2, R9.1, U2.2 (REF)
unnamed: R7.2, R12.1, U4.1 (AN)
unnamed: C8.2, U5.1 (BS)
unnamed: R17.2, U5.4 (EN)
unnamed: R14.1, R15.2, U5.3 (FB)
unnamed: C8.1, L2.1, U5.6 (SW)

Notes on the sheet:
Flyback
Buck
Interfaces
Leds & Voltage divider

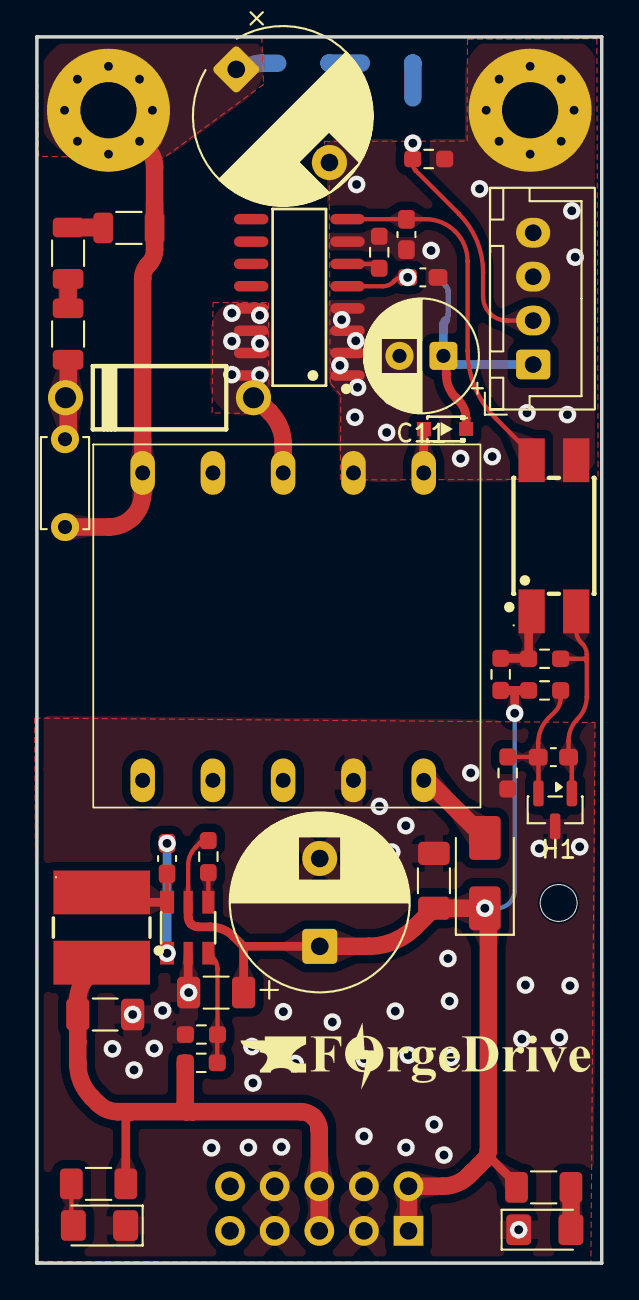
[picture p69: board PSU_G0P20N.kicad_pcb from above]

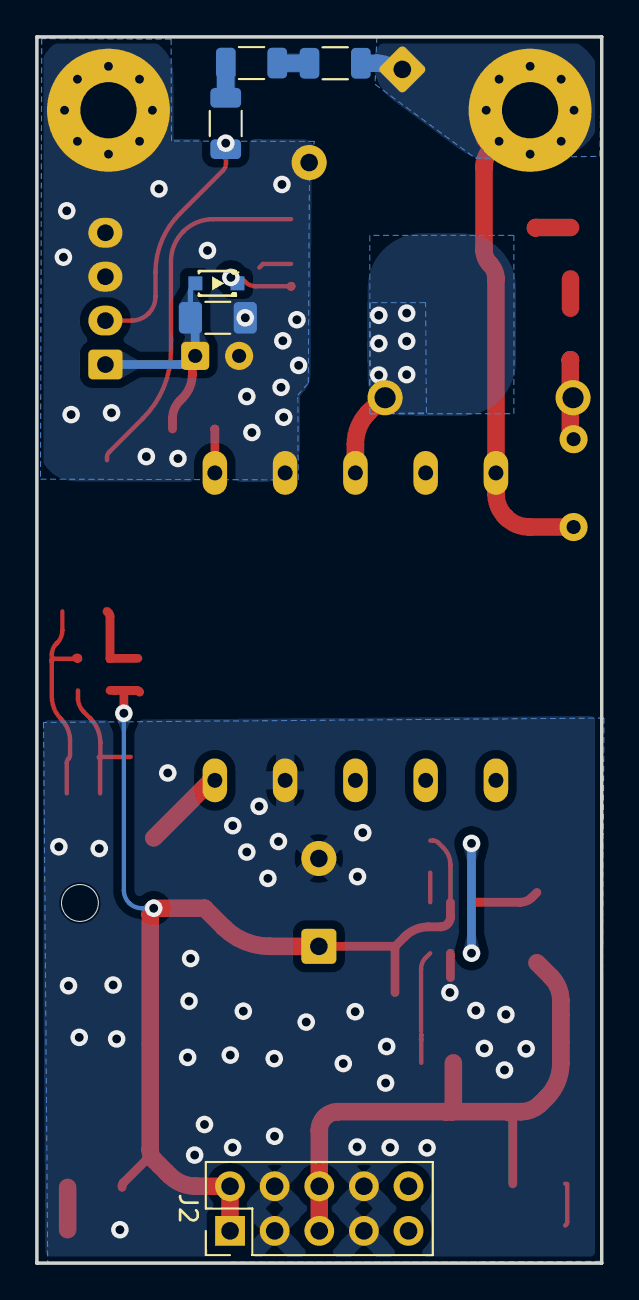
[picture p70: board PSU_G0P20N.kicad_pcb from below]

Board: 2 copper layers, 32.1 x 69.8 mm, 45 parts (6 on the bottom side), 27 nets.
