Omar-Magdy0/ForgeDriveHW/ForgeX/HBM_G0VH4C5/revA/HBM_G0VH4C5.kicad_pcb

## KiCad design ForgeX/HBM_G0VH4C5/revA/HBM_G0VH4C5.kicad_pcb (2026-08-16)

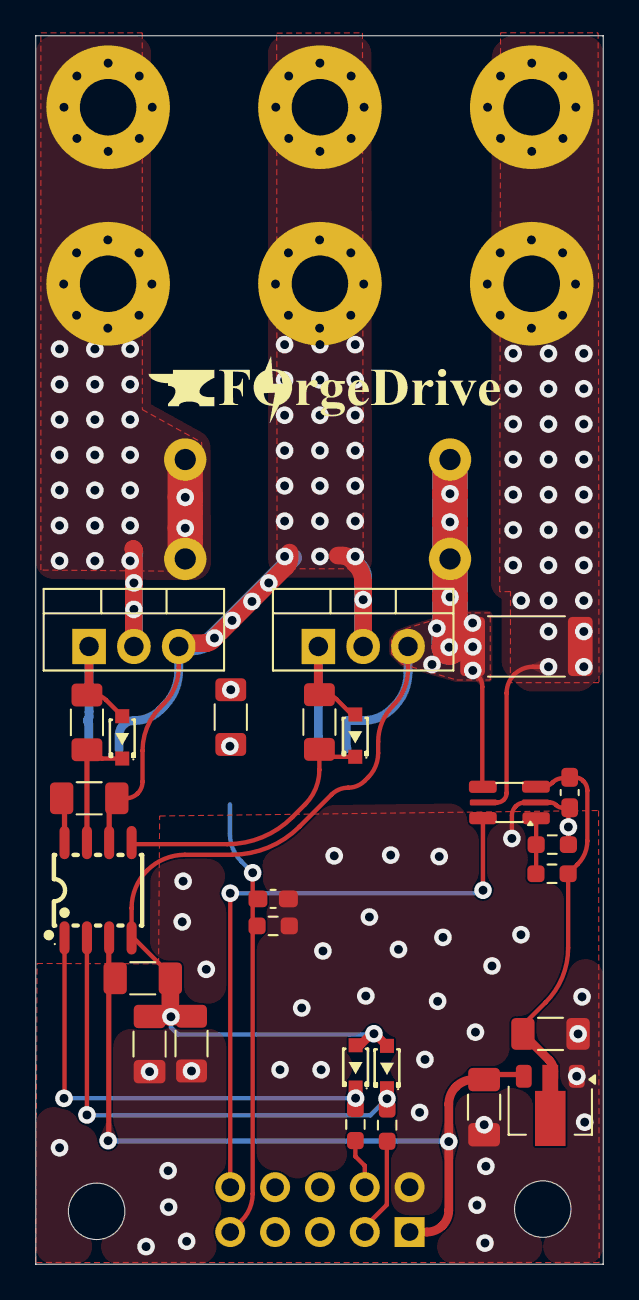
[picture p71: board HBM_G0VH4C5.kicad_pcb from above]

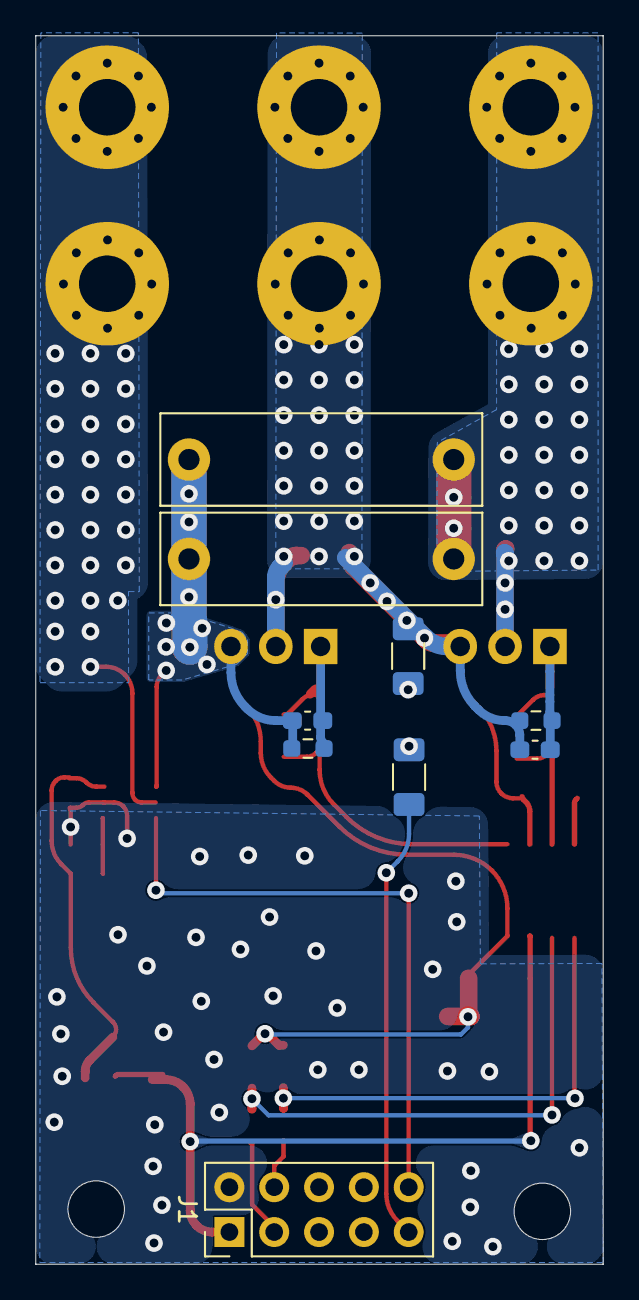
[picture p72: board HBM_G0VH4C5.kicad_pcb from below]

Board: 2 copper layers, 32.2 x 69.6 mm, 38 parts (9 on the bottom side), 21 nets.

Parts:
C2, C3: 1n; C_0603_1608Metric_Pad1.08x0.95mm_HandSolder
C4: 0.1u; C_0603_1608Metric_Pad1.08x0.95mm_HandSolder
C7: 10uF; C_1206_3216Metric_Pad1.33x1.80mm_HandSolder
C8: 1u; C_1206_3216Metric_Pad1.33x1.80mm_HandSolder
C9: 47n; C_0603_1608Metric_Pad1.08x0.95mm_HandSolder
C10: 100p; C_1206_3216Metric_Pad1.33x1.80mm_HandSolder
C20, C21: 1u; C_Rect_L18.0mm_W5.0mm_P15.00mm_FKS3_FKP3
C37, C38: 10u; C_1206_3216Metric_Pad1.33x1.80mm_HandSolder
D1, D2, D3, D4: SD103AWS_C5345966; SOD-323_L1.7-W1.3-LS2.5-RD
H1, H2: MountingHole; MountingHole_3.2mm_M3_DIN965
J1: Conn_02x05_Odd_Even; PinHeader_2x05_P2.54mm_Vertical
J2: Screw_Terminal_01x03; SPACER_M3_PCONN_2x03
Q1, Q2: STF24N60M2; TO-220-3_Vertical
R1: 5m; R_2512_6332Metric_Pad1.40x3.35mm_HandSolder
R2, R3, R4, R5: 10k; R_0603_1608Metric_Pad0.98x0.95mm_HandSolder
R6, R7: 1k; R_0603_1608Metric_Pad0.98x0.95mm_HandSolder
R8: 220; R_1206_3216Metric_Pad1.30x1.75mm_HandSolder
R11, R12: 10; R_1206_3216Metric_Pad1.30x1.75mm_HandSolder
R26: 3.3k; R_0603_1608Metric_Pad0.98x0.95mm_HandSolder
R27, R28, R29: 150k; R_1206_3216Metric_Pad1.30x1.75mm_HandSolder
U1: INA199xxDCK; SOT-363_SC-70-6
U3: L6388ED; SO-8_L4.9-W3.9-P1.27-LS5.9-BL
U7: AMS1117-3.3; SOT-89-3

Connections:
+3.3V: C4.1, C38.1, R2.2, U1.3 (V+), U7.2 (VO)
+12V: C7.1, C37.1, J1.1, U3.3 (VCC), U7.3 (VI)
/HS_GateSig: D1.1 (K), R11.1, U3.7 (HVG)
/LS_GateSig: D2.1 (K), R12.1, U3.5 (LVG)
/Shunt+: C2.2, C7.2, C10.1, C20.2, C21.2, D3.2 (A), D4.2 (A), Q1.3 (S), R1.1, R5.1, R8.1, U1.4 (+), U3.4 (GND)
Csense: J1.10, U1.6
GND: C4.2, C9.2, C10.2, C37.2, C38.2, J1.2, R3.1, R8.2, R26.2, U1.2 (GND), U7.1 (GND)
GNDPWR: J2.3, R1.2, U1.5 (-)
HIN: J1.3, R7.1
LIN: J1.4, R6.1
unnamed: C3.1, D1.2 (A), Q2.1 (G), R4.2, R11.2
unnamed: C2.1, D2.2 (A), Q1.1 (G), R5.2, R12.2
unnamed: D3.1 (K), R7.2, U3.2 (HIN)
unnamed: D4.1 (K), R6.2, U3.1 (LIN)
unnamed: R27.2, R28.1
unnamed: R28.2, R29.1
unnamed: R2.1, R3.2, U1.1 (REF)
unnamed: C8.1, U3.8 (VBOOT)
Phase: C3.2, C8.2, J2.2, Q1.2 (D), Q2.3 (S), R4.1, R29.2, U3.6 (OUT)
Phase_Cnd: C9.1, J1.9, R26.1, R27.1
VDCH: C20.1, C21.1, J2.1, Q2.2 (D)
