Omar-Magdy0/ForgeDriveHW/(commit log)

2026-08-10 Documentation
    doc update
    doc fini
    quick logo fix
    Documentation Updates
    Gen0 inverter modules finalization
    Documentation Initiative...... added logos and images, removed learning content from repo
    [BlackDev_G0Basic.step, HBM_G0VH4C5.step, LVP_G0S4.kicad_pcb, PMB_G0S4VH4.step]
2026-08-16 Technical Reference documentation updates
    [HBM_G0VH4C5.kicad_pcb]
2026-08-19 PSUG0_simulation & Doc start
    [PSU_G0P20N.kicad_sch]
2026-08-24 PSU Finalization
    PSU Documentation semi finalized, sizing, and schematic and layout second pass semi final updates
    [PSU_G0P20N.kicad_pcb, PSU_G0P20N.kicad_sch]
2026-08-31 design files section includes schematic and reordering topics (simulation - design files)
2026-09-02 BlackDevG0 Basic communication update
    Added Esp32 as an SPI slave allowing for Telemetry, CAN (TWAI) connection , TCP/IP - UDP Logging, SD-CARD based logging, for a seamless R&D experience
    [BlackDev_G0Basic.kicad_pcb, BlackDev_G0Basic.kicad_sch, BlackDev_G0Basic.step]
2026-09-02 Layout MicroOptimization
    More Continous ground, and more orthogonal overlaps in layout
    [BlackDev_G0Basic.kicad_pcb]
2026-09-02 MicroOptimization
    Added Teardrops and curved traces
    [BlackDev_G0Basic.kicad_pcb]
2026-09-03 LVP OCP comparators removal
    Initiallly put for short circuit protection, and quick analysis reveals they are not fit for the use case , and add complexity there , OCP can be included in HBM much better or in MGD's
    [LVP_G0S4.kicad_pcb, LVP_G0S4.kicad_sch]
2026-09-03 LVP_G0S4B variant from LVP_G0S4 for Ebikes
    Added an LVP_G0S4B variant
    (swapped temperature sensor 3 , for analog throttle & differential encoder phy interface to single ended encoders)
    [LVP_G0S4.kicad_pcb, LVP_G0S4B.kicad_pcb, LVP_G0S4B.kicad_sch, LVP_G0S4B.step]
2026-09-03 PMB low voltage variant
    Low voltage PMB variant up to 80V, with SEM mark
    [LVP_G0S4B.kicad_pcb, PMB_G0S4V80B.kicad_pcb, PMB_G0S4V80B.kicad_sch]
2026-09-05 PMB_G0SV80B finale
    [PMB_G0S4V80B.kicad_pcb, PMB_G0S4V80B.kicad_sch, PMB_G0S4V80B.step]
2026-09-05 PSU Sem version PSU_G0V48P15R
    resolving issue https://github.com/CUERT-dev/ForgeDriveHW_Horus/issues/3
    [PSU_G0V48P15R.kicad_pcb, PSU_G0V48P15R.kicad_sch, PSU_G0V48P15R.step]
